sastles-com/power-2S-02/docs/03-mp1584-module.md

# 03 — MP1584 降圧回路 (固定 5V / 最大 3 A)

<subproject>
- name: mp1584-module
- parent: power-2s-02
- status: **確定 (2026-08-10)** — 入手性・データシート照合・全定数を決定。**作図に着手できる**
- depends_on: [01-legacy-analysis, 06-power-switch]
</subproject>

## Scope

2S (6.0〜8.4 V) から **固定 5V / 最大 3 A** を作る降圧回路のオンボード設計。
既製品 MP1584EN ミニ降圧モジュール (トリマ調整式) の置き換え。

## 0. 入手性 (2026-08-10 確認)

<confirmed>
| 項目 | 値 |
| --- | --- |
| **選定品** | **MP1584EN-LF-Z** / Monolithic Power Systems (MPS) |
| **LCSC** | **C15051** |
| パッケージ | **SOIC-8-EP (= SOIC8E、露出パッド付き)** |
| 在庫 | 4,681 pcs |
| JLCPCB 実装 | **可 (SMT Assembly)**。ライブラリ区分 **Extended** |
| θJA | **50 °C/W** (JESD51-7、**4 層基板**での実測値 → 本基板は 4 層なのでこの値が使える) |
</confirmed>

### ⚠️ MP1584 系で在庫があるのは C15051 だけ

JLCPCB 部品ライブラリで `MP1584` を検索すると 20 品目ヒットするが、
**C15051 (MP1584EN-LF-Z) 以外はすべて在庫 0**。以下は選んではいけない:

| 型番 | LCSC | 在庫 | 備考 |
| --- | --- | --- | --- |
| **MP1584EN-LF-Z** | **C15051** | **4,681** | **✅ これを使う** |
| MP1584EN | C454188 | 0 | 無鉛/T&R サフィックスなし品 |
| MP1584EN-LF-P | C7304223 | 0 | チューブ品 |
| MP1584EN-Z | C55109561 | 0 | — |
| MP1584WN | C2916141 | 0 | 車載グレード |
| その他 (JLCPCB Assembly ブランド表記の 13 品目) | — | 0 | — |

サフィックスの意味 (データシート ORDERING INFORMATION):
**`-Z` = Tape & Reel / `-LF` = RoHS 対応** → `MP1584EN-LF-Z` が正規の量産型番。

## 1. 確定事項

<confirmed>
- **IC: MP1584EN-LF-Z** (LCSC C15051、SOIC-8-EP)。**非同期整流** (外付けキャッチダイオード方式)
- **出力: 固定 5V** — トリマ廃止、**R1 = 105 kΩ / R2 = 20 kΩ (1%) で 5.000 V** (§3.1)
- **設計最大電流: 3 A**。引き上げ (5〜6 A 級 IC への変更) は行わない
- **スイッチング周波数: 約 485 kHz** (RFREQ = 200 kΩ)。
  **データシート標準回路の 100 kΩ (≈911 kHz) は採らない** — 高デューティで最小オフ時間を割る (§3.2)
- **外付けブートストラップダイオードが必須** (§3.4)。データシート標準回路には無いが、
  `VOUT/VIN > 65%` の条件に本設計は該当する
- **EN 制御**: ディスクリートラッチが EN を **オープンドレインで引き下げる**だけの構成 (§3.7)。
  **EN を 2S レールに直結してはならない (絶対最大 6 V)**。直列 FET は置かない
- **設計の根拠: データシート標準アプリケーション回路 + 自前計算**
</confirmed>

### データシート情報源

- **一次資料: MPS MP1584 データシート Rev 1.0 (18 ページ、2011-08-08)**
  - 入手 URL: `https://robu-prod-media.s3.ap-south-1.amazonaws.com/uploads/2017/05/Mini-MP1584-DC-DC-3A-Adjustable-Buck-module-Datasheet-ROBU.IN_.pdf`
  - MPS 公式サイト / Mouser / LCSC の直リンクはいずれも bot ブロックで取得できなかった
  - ⚠️ **Rev 1.0 は 2011 年版**。最新は Rev 1.9 相当で、電気的特性が微修正されている可能性がある。
    量産前に MPS 公式で最新版を照合すること (§5)

### 既製モジュールの実測情報 (参考、写真から確認済み)

- パワーインダクタ刻印 **4R7 = 4.7 µH** → **本設計の計算結果と一致** (§3.3)
- 整流ダイオード刻印 **SS34** (3 A ショットキー) → 踏襲
- 入力 4.5〜28 V / 出力 0.8〜20 V (トリマ調整)

### legacy 基板での使われ方 ([`docs/01`](01-legacy-analysis.md))

- IN+ ← VIN ネット (P+ から FB1 フェライトビーズ経由、C1 100 µF タンタル + C3 22 µF + C2 0.1 µF)
- OUT+ → VOUT ネット (C7 100 µF タンタル + C5/C6 22 µF + C4 0.1 µF)
- ⚠️ **タンタルは本設計では使わない** — 補償回路が ESR ゼロの影響を受け C6 が必要になる (§3.5)

## 2. ピン配置 (SOIC-8-EP)

| Pin | 名称 | 機能 | 本設計での扱い |
| --- | --- | --- | --- |
| 1 | SW | スイッチノード。キャッチダイオードを**ピン直近**に | L1 / D1 / D2 (§3.3, §3.4) |
| 2 | EN | イネーブル。**H または floating で動作** | **ラッチのオープンドレインで引き下げ** (§3.7) |
| 3 | COMP | エラーアンプ出力。補償ネットワーク接続 | R3 100 kΩ + C3 220 pF (§3.5) |
| 4 | FB | フィードバック入力。**内部基準 0.8 V** | R1/R2 分圧 (§3.1) |
| 5 | GND (露出パッド) | グランド + 放熱。**出力コンデンサに最短で接続** | サーマルビア (§4) |
| 6 | FREQ | 発振周波数設定。抵抗を GND へ | **RFREQ 200 kΩ 1%** (§3.2) |
| 7 | VIN | 入力電源。デカップリングを**ピン直近**に | C1 (§3.6) |
| 8 | BST | ブートストラップ。BST–SW 間にバイパス | C4 100 nF + **D2** (§3.4) |

### 絶対最大定格 / 推奨動作条件 (重要な制約)

| 項目 | 値 | 本設計での意味 |
| --- | --- | --- |
| VIN 絶対最大 | **30 V** | 2S 8.4 V に対し十分 |
| VIN 推奨 | 4.5〜28 V | ○ |
| **その他全ピン (EN/COMP/FB/FREQ) 絶対最大** | **−0.3 〜 +6 V** | **⚠️ EN を 2S レール (6.0〜8.4 V) に直結できない** (§3.7) |
| BST − SW | −0.3 〜 +6 V | 外付け BST ダイオードを使っても 5 V 弱で収まる (§3.4) |
| 連続許容損失 (Ta = 25 °C) | 2.5 W | 実損失 ~1.3 W なので範囲内 (§3.8) |
| 動作接合部温度 Tj | −20 〜 +125 °C | §3.8 で余裕を計算 |
| 熱シャットダウン | 150 °C (ヒステリシス 15 °C) | — |
| VIN UVLO | 立上り 3.0 V / 立下り 2.6 V | BMS が先に切るので到達しない |
| 電流制限 | **min 4.0 / typ 4.7 A** | ピークインダクタ電流 3.44 A で 14% の余裕 (§3.3) |

## 3. 定数設計

### 3.1 出力電圧設定 — **R1 = 105 kΩ / R2 = 20 kΩ で 5.000 V**

- **FB 基準電圧 = 0.8 V** (min 0.776 / max 0.824 → **±3%**)
- `VOUT = VFB × (R1 + R2) / R2`。R1 = VOUT→FB 間 (上側)、R2 = FB→GND 間 (下側)

| 候補 | R1 | R2 | VOUT | 無負荷時の分圧電流 | 判定 |
| --- | --- | --- | --- | --- | --- |
| データシート標準 (Figure 4) | 210 kΩ | 40.2 kΩ | 4.979 V | **20.0 µA** | △ 下の制約にギリギリ |
| **採用** | **105 kΩ** | **20 kΩ** | **5.000 V** | **40 µA** | **○** |

**なぜ標準値を採らないか**: データシートに
`IO + VO/(R1+R2) > 20 µA` (高圧側ブートストラップ回路が出力に流す ~20 µA を吸収するため)
という制約がある。標準値 210 k/40.2 k では無負荷時ちょうど 20.0 µA で余裕がない。
**105 k/20 k なら 40 µA** で確実に満たし、しかも比が正確に 6.25 = 5.000 V/0.8 V になる。

- R2 は「40 kΩ 以下」というデータシート指定も満たす (20 kΩ)
- 精度は **1%** 品。総合誤差は FB の ±3% が支配的で、**最悪 4.77〜5.24 V**。
  WS2812 の電源範囲内なので問題ない。さらに詰めるなら 0.5% 品にする
- 分圧は VOUT に対して入るので、**電源 OFF 時 (VOUT = 0) の電池消費はゼロ**

### 3.2 スイッチング周波数 — **RFREQ = 200 kΩ → 約 485 kHz** (標準回路と変える)

`RFREQ(kΩ) = 180000 / [fs(kHz)]^1.1` → **200 kΩ で fs ≈ 485 kHz**

#### ⚠️ 本設計は高デューティ動作である (最重要の設計制約)

非同期降圧のデューティは `D = (VOUT + Vf) / (VIN + Vf − I×RDS(ON))`。
Vf = 0.5 V (SS34@3A)、RDS(ON) = 150 mΩ、L1 の DCR 30 mΩ 分を出力側に足して計算すると:

| VIN (2S) | 必要デューティ D (3 A 時) | Dmax @485 kHz = 0.952 | Dmax @911 kHz = 0.909 |
| --- | --- | --- | --- |
| 8.4 V (満充電) | 0.66 | ○ | ○ |
| 7.4 V (公称) | 0.75 | ○ | ○ |
| 6.6 V (3.3 V/cell) | 0.84 | ○ | ○ |
| **6.0 V (放電末期)** | **0.92** | **○ (余裕 3 pt)** | **✗ regulation 不能** |

- **最小オフ時間 100 ns** が上限デューティを決める: `Dmax = 1 − 100 ns × fs`
- **データシート標準回路 (Figure 4) の RFREQ = 100 kΩ (≈911 kHz) では、VIN 6.1 V 以下で 3 A を維持できない**
- **485 kHz なら 2S の全範囲 (6.0 V まで) で 3 A を出せる**。スイッチング損失も減り発熱に有利 (§3.8)
- 副作用: 同じリップルを得るのに L が大きくなる → §3.3 で 4.7 µH に決定 (結果的に既製モジュールと同値)

### 3.3 インダクタ — **L1 = 4.7 µH (LCSC C36417)**

`L1 = VOUT/(fs × ΔIL) × (1 − VOUT/VIN)` — リップル最大は VIN 最大 (8.4 V) 側

- ΔIL 目標 1.0 A (電流制限 min 4.0 A に対しピークで余裕を残す) → **L = 4.17 µH → E 系列で 4.7 µH**
- L = 4.7 µH での実際のリップル (VIN = 8.4 V):
  `ΔIL = 5/(485k × 4.7µ) × (1 − 5/8.4) = 0.89 A` (負荷 3 A の 30%、データシートの推奨範囲内)
- ピークインダクタ電流 `ILP = 3.0 + 0.89/2 = 3.44 A`
  → **電流制限の最小値 4.0 A に対し 14% の余裕** ✓
- VIN = 6.0 V ではリップルが 0.37 A に下がる (ILP 3.18 A) ので、8.4 V が最悪条件
- 要求: **Isat ≥ 4.2 A / Idc ≥ 3.6 A (ピーク 3.44 A・平均 3.0 A に対し 1.2 倍)**、DCR ≤ 30 mΩ
  (DCR 損失 = 9 × 0.03 = 0.27 W。これ以上大きいと効率と発熱に効く)
- **選定確定 (2026-08-11): `SWPA8040S4R7NT` = LCSC `C36417`**
   — 4.7 µH / **Idc 4.1 A / Isat 6.5 A / DCR 25 mΩ / 8.0 × 8.0 mm**
  - 余裕: Isat は ピーク 3.44 A に対し **1.9 倍** ✓ / Idc は平均 3.0 A に対し **1.37 倍**
    (Idc 定格は温度上昇 40 °C 基準なので、3.0 A では上昇 21 °C 相当)
  - DCR 25 mΩ は要求「≤ 30 mΩ」を満たす ✓ (損失 `9 × 0.025 = 0.23 W`)
  - ⚠️ **8.0 × 8.0 mm は本基板で最大の部品**。40×40 のレイアウト制約になる ([`docs/04`](04-layout-thermal.md))。
    小型の `SWPA6045S4R7NT` (C316350) もあるが**ライブラリに電流・DCR が入っておらず検証できない**ため採らなかった
  - データシート Table 1 の推奨品 (TDK RLF7030T-4R7 = 4.7 µH / 31 mΩ / 3.4 A) は電流定格が足りない

### 3.4 外付けブートストラップダイオード — **必須。標準回路には無いので忘れやすい**

<confirmed>
**D2: VOUT (5 V) → BST に `1N4148W` (LCSC C81598) を追加する。**
</confirmed>

データシート "External Bootstrap Diode" の適用条件に本設計が**二重に該当する**:

1. **「`VOUT/VIN > 65%` の高デューティ動作」** — 本設計は 5/7.4 = **68%** (公称)、5/6.0 = 83% (末期)。
   満充電の 5/8.4 = 60% のときだけ 65% を下回る = **電池寿命のほぼ全域で該当**
2. **「軽負荷時は `VIN − VOUT > 3 V` が必要」** — 本設計は最大でも 8.4 − 5 = 3.4 V、公称では **2.4 V で不足**。
   軽負荷ではパルススキップ動作に入り BST コンデンサのリフレッシュ時間が足りなくなる

放置すると **ハイサイド FET のゲート電圧が不足して効率低下・出力不安定**を招く。
5 V レールが系内にある (自分の出力) ので、データシートの言う
「5 V レールが利用できるなら外付けダイオードを追加せよ」に素直に従える。

- 実装: **VOUT → D2 → BST**、BST–SW 間の **C4 = 100 nF** は標準どおり残す
- BST−SW 間電圧は `5 V − Vf ≈ 4.7 V` で**絶対最大 6 V 以内** ✓
- 起動時は VOUT = 0 なので D2 は効かないが、内部 PMOS 経由の充電で立ち上がる (ソフトスタート 1.5 ms)
- **選定確定 (2026-08-11): `1N4148W` = LCSC `C81598` (SOD-123F、Basic Part)**
  - データシートが名指しする型番で、Basic なので段取り費もかからない
  - Vf = 1 V @ 50 mA なので BST−SW ≈ **4.0 V**。ショットキー (BAT54, Vf 0.3 V) なら 4.7 V だが、
    **BST の UVLO 立上り閾値は 2.2 V** なので 4.0 V でも十分な余裕がある ✓
  - BAT54 は LCSC で SOT-23 の Extended しか無く、サイズもコストも不利だったため採らなかった

### 3.5 補償ネットワーク — **R3 = 100 kΩ / C3 = 220 pF / C6 なし**

データシート "Compensation Components" の手順に従う (GEA = 60 µA/V、GCS = 9 A/V):

1. `R3 = 2π × C2 × fC / (GEA × GCS) × VOUT/VFB`、クロスオーバ `fC = fs/10 = 48.5 kHz`
   - C2 実効 22 µF なら R3 = **78 kΩ**、実効 35 µF なら R3 = **124 kΩ**
   - → **R3 = 100 kΩ** はこの範囲の中央で、かつ**データシート Table 3 の 5 V 行の値と一致**する
2. `C3 > 4/(2π × R3 × fC)` = **131 pF** → **C3 = 220 pF** を採用
   - 零点 `fZ1 = 1/(2π × C3 × R3) = 7.2 kHz` = fC/6.7 → 「fC の 1/4 以下」条件を満たす ✓
   - Table 3 の 5 V 行は 150 pF。**220 pF は位相余裕を厚めに取った選択**。
     過渡応答を速くしたい場合は 150 pF に下げてよい
3. `C6` は出力コンデンサの ESR 零点が `fs/2` 未満のときだけ必要
   - **セラミックのみ (ESR ~5 mΩ)** → ESR 零点 ≈ 1.4 MHz ≫ fs/2 = 242 kHz → **C6 不要** ✓
   - ⚠️ **legacy のように 100 µF タンタル (ESR ~100 mΩ) を足すと ESR 零点が 16 kHz に落ちて C6 が必要になる**
     (`C6 = C2 × RESR / R3` ≈ 130 pF)。**タンタルは使わず全セラミックにする**方が設計が単純で確実

- 補償部品は **IC 直近**に置く。SW ノードの真下・近傍や大電流ループ内には置かない (§4)

### 3.6 入出力コンデンサ — **全セラミック**

| | 構成 | 根拠 |
| --- | --- | --- |
| **C1 (入力)** | **22 µF/25 V ×2 + 0.1 µF** | 入力リップル電流は `ILOAD × √(D(1−D)) = 3 × 0.43 = 1.3 A RMS`。セラミック複数個で分担する。入力電圧リップルは 26 mV |
| **C2 (出力)** | **22 µF/25 V ×2 + 0.1 µF** | 出力リップル `ΔVOUT = VOUT/(8 fs² L C2) × (1−VOUT/VIN)` = 10 mV (公称値)、DC バイアス減衰後の実効 ~22 µF でも 21 mV |

- **耐圧 25 V を選ぶ** — 5 V 出力・8.4 V 入力に対して過剰に見えるが、
  **0805/1206 の 22 µF X5R は DC バイアスで実効容量が 30〜50% 落ちる**。
  16 V 品より 25 V 品の方が定格電圧に対する使用率が下がり、実効容量を確保できる
- 0.1 µF は各々 IC ピン直近に配置
- **タンタル/電解は使わない** (§3.5 の理由 + 信頼性)

### 3.7 EN ピンとラッチ interface — **ここが [`docs/06`](06-power-switch.md) の設計前提**

<confirmed>
**EN は「ラッチがオープンドレインで GND へ引き下げるだけ」の構成にする。プルアップ抵抗も分圧も付けない。**
</confirmed>

データシートから判明した EN の性質:

| 項目 | 値 | 設計への影響 |
| --- | --- | --- |
| 立上り閾値 | 1.5 V typ (**min 1.35 / max 1.65**) | — |
| 立下り閾値 | **1.2 V** (precision) | ヒステリシス 300 mV |
| **floating 時** | **内部 1 µA プルアップで約 3.0 V まで上がり = イネーブル** | **⚠️ 何もしないと電源 ON になる** |
| 引き下げに必要な能力 | **1 µA** | 小信号 MOS/NPN で十分 |
| **絶対最大** | **6 V** | **⚠️ 2S レール (6.0〜8.4 V) に直結不可** |
| シャットダウン時消費 | **12 µA typ / 20 µA max** (VEN = 0) | §3.9 のオフ電流を支配する |

#### [`docs/06`](06-power-switch.md) への申し送り (4 件)

1. **EN を 2S レールから分圧してはならない…わけではないが、その必要がない。**
   floating で内部プルアップが ~3.0 V まで持ち上げるので、**ラッチは「引き下げるだけ」でよい**。
   分圧を付けると 6 V 絶対最大の管理が必要になり、常時電流も流れる。**オープンドレイン一択**
2. **電池を挿した直後のデフォルトは「電源 ON」になる** (EN が floating = イネーブル)。
   これを避けるには **ラッチの電源投入時状態を「EN を引き下げる」側に確定させる回路** (RC による
   パワーオンリセット等) が必要。2 石ソフトラッチの素朴な構成では初期状態が不定になりうる
3. **OFF 時は EN を GND まで確実に引き切る。** データシートに
   「EN が 0 V より高く立上り閾値より低い場合、シャットダウンではあるが消費電流がやや増える」
   と明記されている
4. **EN は開放時 1 µA という高インピーダンスノード** → SW ノードから離して配線し、
   **ノイズ対策に EN–GND 間へ 220 pF 程度**を入れる (1 µA で 220 pF を 1.5 V まで充電するのに
   約 0.33 ms。ソフトスタート 1.5 ms に対して無視できる)

### 3.8 発熱と効率 (VIN = 7.4 V, VOUT = 5 V, 3 A)

| 損失要因 | 計算 | 損失 |
| --- | --- | --- |
| ハイサイド FET 導通 | `I² × RDS(ON) × D = 9 × 0.15 × 0.75` | **1.01 W** |
| スイッチング + ドライバ | 概算 | 0.15 W |
| **→ IC 単体** | | **約 1.16 W** |
| D1 キャッチダイオード | `Vf × I × (1−D) = 0.5 × 3 × 0.25` | 0.38 W |
| L1 の DCR | `I² × DCR = 9 × 0.03` | 0.27 W |
| **合計** | | **約 1.8 W** |

- **効率 ≈ 15 W / 16.8 W = 89%** → **CLAUDE.md §9 の「降圧効率 ~90%」という前提を裏取りできた**
- IC の温度上昇: **θJA 50 °C/W × 1.16 W = ΔT 58 °C**。
  ⚠️ IC 損失の最悪条件は**高デューティ側** (VIN = 6.6 V, D = 0.84) で **1.28 W → ΔT 64 °C**
- 周囲温度 40 °C を仮定すると **Tj ≈ 104 °C** — 動作上限 125 °C 以内だが**余裕は大きくない**。
  θJA 50 °C/W は「4 層基板 + 露出パッドを GND プレーンに熱結合」が前提の数値なので、
  **サーマルビアの設計が効率と信頼性を直接左右する** → §4 / [`docs/04`](04-layout-thermal.md)
- 連続許容損失 2.5 W (Ta = 25 °C) の範囲内 ✓

### 3.9 オフ時消費電流 — **≤10 µA は達成不可能** (docs/06 Q1 への回答)

| 要因 | 電流 |
| --- | --- |
| **MP1584 シャットダウン電流 (VEN = 0)** | **12 µA typ / 20 µA max** |
| IP2326 スタンバイ (充電入力なし) | 0.7 µA typ / 1 µA max ([`docs/02`](02-ip2326-module.md) §3.7) |
| ラッチ回路の静止電流 | 未定 ([`docs/06`](06-power-switch.md)) |
| FB 分圧 / EN 分圧 | **0** (VOUT = 0、EN 分圧なし) |
| **合計 (ラッチ除く)** | **約 13 µA typ / 21 µA max** |

- **[`docs/06`](06-power-switch.md) Q1 の目標「≤10 µA」は MP1584 単体で超えるので達成できない。**
  **目標を ≤50 µA に改める** ことを提案 (ラッチ側に ~20 µA の予算が残る)
- 実用上の影響: **20 µA で 2000 mAh を消費するのに 11 年** — 完全に無視できる。
  ディスクリートラッチ方式を選んだ本来の目的 (直列 FET の導通損失回避 + オフ時に降圧 IC を止める)
  は達成できている

## 3.10 回路図の実装状況 — **DCDC ブロック完成 (2026-08-11)**

> **Designator は 2026-08-11 にリナンバー済み** (旧 U20/L20/C20-C27/R20-R23/D20/D21)。
> 全体の対応表は [`HANDOFF.md`](../HANDOFF.md) 「Designator リナンバー」を参照。

<confirmed>
**枠 X 690..1400 / Y 340..700 (710×360)。16 部品 + GND 記号 12 + NET_PORT 3 + 配線 15 本を実装し、
幾何検証 (短絡なし / 未接続なし) をクリアした。**
</confirmed>

| Designator | 部品 | LCSC | 位置 |
| --- | --- | --- | --- |
| **U2** | MP1584EN-LF-Z | C15051 | (1000,520)。**幅 100 / ピッチ 10 / 左 SW,EN,COMP,FB / 右 GND,FREQ,VIN,BST / EP は pin 9 (1000,485)** |
| L2 | 4.7 µH | C36417 | (850,535) |
| D2 (キャッチ) / D3 (**外付け BST**) | SS34 / 1N4148W | C8678 / C81598 | (900,480) / (1130,580) |
| C9 / C10 (入力 22 µF) | — | C12891 | (1120,510) / (1180,510) |
| C11 / C12 (出力 22 µF) | — | C12891 | (800,520) / (760,520) |
| C13 (入力 0.1 µF) / C14 (出力 0.1 µF) / C15 (BST 100 nF) | — | C1591 | (1240,505) / (720,515) / (1000,580) |
| C16 (補償 220 pF) | — | C27675 | (840,370) |
| R7 (105 k) / R8 (20 k) | FB 分圧 | C16840 / C4184 | (900,450) / (900,410) |
| R9 (100 k) / R10 (200 k) | 補償 / RFREQ | C25803 / C25811 | (900,370) / (1090,470) |

**ネットごとの接続 (検証結果)**:

| ネット | ピン |
| --- | --- |
| `DC_SW` | U2.SW / L2.2 / D2.K / C15.1 |
| `DC_BST` | U2.BST / C15.2 / **D3.K** ← 外付け BST ダイオードが入っている ✓ |
| `V5V` | L2.1 / C11.1 / C12.1 / C14.1 / R7.1 / **D3.A** / NET_PORT |
| `SW_VIN` | U2.VIN / C9.1 / C10.1 / C13.1 / NET_PORT |
| `DC_FB` | U2.FB / R7.2 / R8.2 |
| `DC_COMP` → `DC_COMPR` | U2.COMP / R9.2 → R9.1 / C16.2 (直列 RC) |
| `DC_FREQ` | U2.FREQ / R10.1 |
| `PWR_EN` | U2.EN / NET_PORT (PMIC のラッチから) |
| `GND` | U2.GND / U2.EP + 各コンデンサ・抵抗の GND 側 (12 ピン、netflag 直置き) |

⚠️ **`PACK_P` → `SW_VIN` の接続 (フェライトビーズ or 0 Ω) は未実装** —
legacy の FB1 を続投するかは未確定 ([`docs/04`](04-layout-thermal.md) §7 Q2)。
現状は `SW_VIN` を NET_PORT で外に出しているだけ。

### 2026-08-12 の再監査結果

**16 部品・37 ピンを 1 ピンずつ照合し、上の表と完全に一致することを確認した**
(`GND` 12 / `V5V` 6 / SW 4 / `SW_VIN` 4 / FB 3 / BST 3 / COMP 2 / FREQ 2 / 補償 RC 2 / `PWR_EN` 1)。
**短絡・未接続なし。** 監査は `.claude/skills/eda-connect/scripts/dcdc-audit.js`。

DCDC 段の残件は 2 件だけ:

| # | 残件 | 状態 |
| --- | --- | --- |
| ① | **`PACK_P` → `SW_VIN`** (ビーズ or 0 Ω) | 未実装 ([`docs/04`](04-layout-thermal.md) §7 Q2) |
| ② | **EN–GND の 220 pF** (§3.7 申し送り 4) | **未実装。方式変更で不要になった可能性** — §3.7 の提案は「EN が 1 µA プルアップの高インピーダンスノード」という前提だったが、[`docs/06`](06-power-switch.md) §4.5 で **D-FF の Q (3.3 V CMOS プッシュプル) 直結**に変わり、ノードは低インピーダンスになった。入れるなら D-FF の駆動能力 (数 mA) で 220 pF は問題なく、SW ノード近傍を通す場合の保険になる → ユーザー判断 |

## 4. レイアウト要件 (データシート "High Frequency Operation" より)

- **C1 (入力デカップリング) / D1 (キャッチダイオード) / IC の VIN・SW・GND を可能な限り近接**させ、
  配線は**短く太く**。SW ノードの電圧スパイクと EMI を抑える
- **D1 は SW ピン直近**に置く (データシートがピン説明でも明記)
- **FB 配線はインダクタと大電流配線から離す。** 可能なら**インダクタの裏面側に GND プレーンを挟んで**通す
- **補償部品 (R3/C3) は IC 直近。SW ノードの近傍/直下や大電流ループ内に置かない**
- **露出パッド直下にサーマルビアのグリッド**:
  - **バレル径 15 mil (0.38 mm)** — メッキで穴がほぼ埋まる小径にする (大きいとリフローで半田が吸われる)
  - **ピッチ 40 mil (1.0 mm)**
  - → [`docs/04`](04-layout-thermal.md) の内層/Bottom ベタ GND へ熱を逃がす
- SW ノードは面積最小 + 内層 GND で直下シールド

## 5. 負荷側の制約 (重要)

**3 A は LED 負荷に対して厳しい上限**であり、ファーム側の輝度上限運用が前提。
定量的な内訳は CLAUDE.md §9 (Known Constraints) を参照。要点は
**設計上限 3 A から静止電流 0.6〜0.8 A を引いた約 2.2 A が発光に使える分**で、
**LED 1 個あたり平均 2.75 mA** (全白の約 5%) が上限ということ。
この制約は親プロジェクトのファーム設計へ申し送る必要がある。

- §3.8 で **効率 89%** が裏取りできたので、CLAUDE.md §9 の
  「14.8 Wh に対し 15 W で実際 50 分程度」という見積りはそのまま有効

## 6. Open questions

**降圧段の定数は確定した。残るのは部品選定と検証項目のみ。**

| 旧 Q | 内容 | 結論 |
| --- | --- | --- |
| Q1 | データシート照合・固定 5V 分圧・EN 仕様 | ✅ 完了 (§2, §3)。EN の性質は §3.7 に整理して [`docs/06`](06-power-switch.md) へ申し送り |
| Q2 | 出力コンデンサの実効容量確保 | ✅ **22 µF/25 V ×2 の全セラミック構成**。タンタルは補償が複雑になるので使わない (§3.5, §3.6) |
| Q3 | 同期整流型の後継 IC を将来検討するか | 今回は **MP1584 で確定** (再議論しない)。※ 調査中に **SCT2430** (Silicon Content、3.5 A 同期整流、低ドロップアウトモード、ESOP-8) を見つけた。ピン配置は非互換だが、将来 2S 末期の余裕を増やしたい場合の候補として記録 |

残タスク:

- [x] ~~L1 の LCSC 品番選定~~ → **C36417 (SWPA8040S4R7NT)** (§3.3)。⚠️ **8.0×8.0 mm がレイアウト制約**
- [x] ~~D2 (外付け BST ダイオード)~~ → **C81598 (1N4148W, SOD-123F, Basic)** (§3.4)
- [x] ~~セラコン 22 µF/25 V~~ → **C12891 (1206, Basic, 25 V 確認済み)**。
  **0805 の 22 µF は 16 V 品しか存在しない**ので 1206 で確定。入力/出力で計 4 個 + 充電段 2 個 = **6 個**載る
  ([`docs/05`](05-jlcpcb-fab.md) §2.1)
- [ ] **データシート最新版 (Rev 1.9 相当) との照合** — 本設計は Rev 1.0 (2011) に基づく。
  電気的特性 (特に EN 閾値・シャットダウン電流・最小オフ時間) が変わっていないか量産前に確認
- [ ] **試作機での検証**: 負荷ステップ応答 (補償の妥当性)、VIN 6.0〜6.6 V での 3 A 維持、IC 温度実測
