sastles-com/power-2S-02/docs/08-north-status-window.md

# 08 — 北極ステータス窓 (North Pole Status Window)

<subproject>
- name: north-status-window
- parent: power-2s-02 (さらに親: Isolation Sphere V2)
- status: **draft — 作業指示書 (handoff)。着手前に §7 の判断 4 件を解消すること**
- created: 2026-08-11
- depends_on: [06-power-switch, 02-ip2326-module, 親リポジトリ docs/01-shell-cad]
</subproject>

> **この doc は単独で読めるように書いてある。** 会話ログや他セッションの文脈に依存しない。
> 別セッション (別の Opus) がこの doc と [`CLAUDE.md`](../CLAUDE.md) / [`HANDOFF.md`](../HANDOFF.md) だけを読んで着手できることを要件とする。

---

## 1. Goal / 何を作るか

<goal>
球体 (Isolation Sphere V2) の**北極キャップを、電源状態と充電状態が見える「ステータス窓」に作り替える。**

解決する問題は 2 つ:

1. **電源 ON/OFF が分からない** — 磁石をかざして電源を入れても、コントローラ (M5 AtomS 系) の起動に時間がかかるため、
   その間ユーザーは ON なのか OFF なのか判断できない。**ファームウェアに依存しないハードウェア表示**が必要。
2. **既存の指示 LED が見えない** — [`docs/06`](06-power-switch.md) §3.6.2 の電源 ON LED と
   [`docs/02`](02-ip2326-module.md) §3.5 の充電中 LED は**どちらも電源基板上 = 球体コアの中**にあり、
   外殻に埋まって視認できない。**北極キャップへ移設する。**

加えて **「再生が始まったら消灯する」** — コントローラがコンテンツ再生を開始したら、
ステータス窓を消して演出の邪魔をしない。これは ESP32 からの veto 線 1 本で実現する (§4.3)。
</goal>

## 2. Scope / この doc が扱う範囲

- 北極キャップ (意匠) の透光化
- 北極 pillar 先端の**キャリア基板** (ホール素子 + ステータス LED 2 個)
- 北極 pillar の**配線通路** (Φ3 mm / 5 本)
- 電源基板側の LED 駆動回路と **ESP32 veto 回路**
- 上記に伴う親リポジトリ / 本リポジトリの doc 改訂リスト

### Out of scope / 扱わない範囲

- 電源 ON/OFF 回路そのもの (ホール素子 → フリップフロップ → MP1584 EN) → [`docs/06`](06-power-switch.md)
- 充電回路 → [`docs/02`](02-ip2326-module.md)
- 球体外殻・カセット・マザーリング → 親リポジトリ `docs/01-shell-cad.md`
- **ブザー (音による通知)** — **保留**。光で先行する (§7 Q3)

---

## 3. Confirmed decisions / 確定事項

<confirmed>
2026-08-11 ユーザー決定。**再議論しない。**

| 項目 | 決定 |
| --- | --- |
| 北極キャップの役割 | 「純粋装飾蓋」→ **透光ステータス窓**に変更 |
| トリガ素子 | **ホール素子** (リードスイッチは不採用)。**間欠動作の µA 級に限る** — 連続動作型は mA 級で予算 50 µA を 100 倍超える |
| 素子の型 | **スイッチ型 (磁石が近い間だけ出力)**。**ラッチ型は不可** — N/S を交互に当てる必要があり磁石を裏返す操作になる |
| 検知極性 | **両極検知 (omnipolar)** — 磁石の向きを気にせず使える |
| トリガ位置 | **北極** (充電マグネット端子は南極)。磁気干渉なし — 距離 100 mm、磁束は距離の 3 乗で減衰し約 1/1000。クランプねじは真鍮=非磁性 |
| 状態表示の駆動元 | **フリップフロップの Q (3.3 V)**。5V レールではない — **かざした瞬間**に点灯し、MP1584 の soft-start (1.5 ms) すら待たない |
| 再生開始で消灯 | **実装する。** 方式は §4.3 の 3 案から選ぶ。**起動中は必ず点灯**していること (boot-safe) |
| ⚠️ コントローラの制約 | **M5 AtomS3R は GPIO を使い切っている** (2026-08-11 判明)。**veto 専用 GPIO は使えない**前提で設計する |
| 充電中 LED | **北極キャリア基板へ移設**。IP2326 pin 6 が充電中点灯 / 満充電消灯 / 異常点滅を自動でやる |
| **音 (ブザー)** | **鳴らさない。確定 (2026-08-11)。光のみ。** 再提案禁止 |
| **動画再生中の表示** | **電源 ON / 充電中の両インジケータを消灯する。** veto は 2 灯まとめて効かせる (§4.3) |
| pillar 先端の実装 | **小型キャリア基板を新設** (ホール SOT-23-3 + LED 2 + 抵抗 2)。`inner_deck` に続く 2 枚目の補助基板 |
| 北極 pillar | **配線通路 Φ3 mm を新設** (現行仕様は「北極は通路不要」) |
| 接着剤 | **使用禁止** (親プロジェクトの絶対規則) |
</confirmed>

---

## 4. Electrical specification / 電気仕様

### 4.1 System context (前提となる電源アーキテクチャ)

```
2S LiPo ──> [XR-2S-30A BMS (基板外)] ──> PACK_P (6.0-8.4V)
                                            │
                        ┌───────────────────┼──────────────────┐
                        │                   │                  │
                   [IP2326 充電]      [HT7333-1 LDO]     [MP1584 降圧]
                   CHG_IN=南極磁気端子   3.3V 常時オン        EN 制御で ON/OFF
                        │                   │                  │
                    pin6=充電LED        ┌───┴───┐            V5V (5V/3A)
                        │               │       │                │
                        │          ホール素子  [D-FF]            └─> AtomS + LED 800
                        │           (北極)   Q=電源状態
                        │                       │
                        └──────────────> 北極ステータス窓 <───────┘
```

**重要**: 3.3 V LDO は**常時オン**。だから電源 OFF 中でもホール素子と D-FF が生きていて、
かざした瞬間に反応できる。この構造が本 doc の前提。詳細は [`docs/06`](06-power-switch.md)。

### 4.2 北極 pillar を通る配線 — 6 本

**⚠️ 2026-08-11 改訂: 共通カソード方式へ変更したため 3 本のネットが入れ替わった。**
**下表が最新。** 旧表 (`LED_VCC` / `STAT_PWR_K` / `STAT_CHG_K`) は破棄した — 経緯は §5.2a の訂正ブロック。

| # | 信号名 (電源基板側) | 北極側 | 方向 | 内容 |
| --- | --- | --- | --- | --- |
| 1 | `V3P3` | `+3V3` (J1.2) | 基板 → 北極 | 常時オン 3.3 V。ホール素子とスイッチのプルアップ用 |
| 2 | `GND` | `GND` (J1.1) | — | 共通グランド |
| 3 | `HALL_OUT` | `OUT` (J2.2) | 北極 → 基板 | ホール + SW のダイオード OR 出力 → Schmitt → D-FF の CLK |
| 4 | **`PWR_EN`** | `PWR_EN` (J2.4) | **基板 → 北極** | **D-FF の `Q` が `D1` のアノードを直接駆動** (MOSFET 不要) |
| 5 | **`CHG_LED`** | `CHG_LED` (J2.3) | **基板 → 北極** | **IP2326 pin 6 が `D2` のアノードを直接駆動** (ソース出力) |
| 6 | **`LED_K`** | `LED_K` (J2.1) | **北極 → 基板** | **2 灯の共通カソードの帰り** → 電源基板の `Q1` (2N7002) が GND へ落とす。**veto はここ 1 点で 2 灯を消す** |

- **線材: AWG30 級の細線 × 6**。AWG30 は被覆込み Φ0.5 mm 級なので Φ3 mm (断面 7 mm²) 通路に余裕で収まる
- ✅ **`V3P3` は veto の影響を受けない** — veto は共通カソード `LED_K` を切るだけなので、
  **ホール素子が veto 中に止まる経路が構造的に存在しない**。
  (旧方式では `LED_VCC` と `V3P3` の共用が禁止事項だったが、その前提自体が消えた)
- **`HALL_OUT` は必ずツイストする** — 球内に WS2812 データ 5 本が走っており、
  40〜50 mm の引き回しはノイズを拾う。ホール出力はドライブされた低インピーダンスなので
  リードスイッチ (高インピーダンスのプルアップノード) よりは有利だが、対策は入れる
- 基板側に **RC ローパス** (例 1 kΩ + 1 nF) を入れる

### 4.3 インジケータの駆動 + 再生開始で 2 灯とも消灯する仕組み (veto)

> ## ⚠️ 本節 (§4.3 / §4.4 / §4.4a / §4.4b) は検討経緯であり、**確定仕様ではない**
>
> **`IP2326` pin 6 が「シンク」という誤った前提**で書かれている。データシート Figure 5 で
> **ソース**と判明したため、topology は **共通カソード + N-MOS 1 個**に変わった。
>
> **確定仕様は [§5.2a の訂正ブロック](#-2026-08-11-訂正-ip2326-pin-6-はソースだった--led-を共通カソードに変える) と
> [§4.2 の配線表](#42-北極-pillar-を通る配線--6-本) を見ること。**
> 本節は「なぜ P-MOS + PNP 反転段を検討したか」「案 A/案 1/案 2 を何故捨てたか」の記録として残す。

**電流制限抵抗と LED はキャリア基板に、スイッチング素子は電源基板に置く。**

**設計方針: veto は「LED 用アノードレール `LED_VCC` を 1 個の素子で切る」。**
こうすれば **電源 ON LED と充電 LED の 2 灯を 1 箇所で一括消灯**でき、
IP2326 pin 6 の駆動経路に一切手を入れずに済む (pin 6 の駆動形式が §7 Q2 で未確定なため重要)。

```text
                    [電源基板]                          │      [キャリア基板 = 北極]
                                                        │
  V3P3 ──┬─────────────────────────────────────────────┼──> ホール素子 (veto の影響を受けない)
         │                                              │
         ├── Q_RAIL.source (P-MOS)                      │
         │      │  gate ──┬── R 100k ── GND  (default ON = 点灯)
         │      │         └── R 10k ──── VETO 信号 (H で OFF = 消灯)
         │      │                                       │
         │   Q_RAIL.drain ── LED_VCC ══════════════════>┼──┬── R 680Ω ── LED_PWR ──┐
         │                                              │  │  (Vf 2.0V → 2.0mA)    │
         │                                              │  └── R xxxΩ ── LED_CHG ──┼─┐
         │                                              │     (値は §7 Q2 で確定)  │ │
         │   Q_LED.drain <════ STAT_PWR_K ══════════════┼─────────────────────────-┘ │
         │      │ (2N7002)                              │                            │
         │     GND                                      │                            │
         │      gate ── R 10k ── Q (D-FF 出力)          │                            │
         │                                              │                            │
         └── IP2326 pin 6 <════ STAT_CHG_K ═════════════┼────────────────────────────┘
```

**`VETO` 信号の作り方は 3 案あり (下記)。上の骨格はどの案でも共通。**

⚠️ **`Q_RAIL` の gate は R 100k で GND へプルダウンする (default = 点灯)。**
これが boot-safe を保証する — AtomS3R が起動中で veto を driveできない間、
LED レールは生きたままになる。**このプルダウンは省略不可。**

#### ⚠️ 制約: M5 AtomS3R は GPIO を使い切っている (2026-08-11)

当初案の「ESP32 の GPIO 1 本で veto」は**使えない**。代替 3 案を比較する。

| | **案 A: WS2812 データ活動検出** | 案 B: I2C GPIO エキスパンダ | 案 C: RC タイムアウト |
| --- | --- | --- | --- |
| GPIO 消費 | **0** | **0** (既存 I2C バスに相乗り) | **0** |
| firmware 変更 | **不要** | 必要 (1 bit 書くだけ) | **不要** |
| 追加部品 | 6 点 (すべて既存 BOM の型番) | IC 1 個 + 受動数点 + アドレス管理 | **4 点** |
| 消灯タイミング | **WS2812 へフレームが流れ始めた瞬間** | firmware が決めた任意の時点 | 電源 ON から固定時間後 |
| 意味的な正しさ | **「再生を始めたら」とほぼ一致** | 最も正確 (任意の条件で制御可) | 近似 (起動が遅れると先に消える) |
| リスク | データ線への負荷 (要高インピーダンス設計) | I2C バスが GPIO として使われていると成立しない | 起動時間のばらつきを吸収できない |

**推奨は案 A。** GPIO も I2C も firmware も使わず、しかも「再生が始まった」という
意味そのものを直接検出できる。

#### 案 A の回路 (WS2812 データ活動検出) — **フォールバック**

⚠️ **2026-08-11 に方針変更: I2C 端子が基板上で使用可能と判明したため、`VETO` は
§4.4 案 1 (I2C GPIO エキスパンダ) から取る。** 案 A は **I2C が使えないと分かった場合の
代替**として残す (定数まで算出済みなので即着手できる)。

Grove ポートは BNO055 が使用中だが、**I2C はバスなので別アドレスのデバイスを追加できる**
(§4.4)。案 A を使うのは、アドレス衝突・バス速度・実装スペースなどで
エキスパンダが載らないと判明した場合に限る。

##### ① 入力信号の実測前提 (WS2812 のタイミングから計算)

| 項目 | 値 | 根拠 |
| --- | --- | --- |
| ビット周期 | **1.25 µs** (800 kbps) | WS2812 プロトコル |
| **High の最大継続時間** | **T1H ≈ 0.8 µs** (公差込みで 1 µs 未満) | 「持続 High は通常発生しない」ことの根拠 |
| バースト内のデューティ | **28%** (全ビット 0) 〜 **60%** (全ビット 1) | T0H 0.4 / T1H 0.8 ÷ 1.25 |
| **1 フレームの送出時間** | **4.8 ms** | 160 LED × 24 bit × 1.25 µs。**5 本は並列駆動なので 1 本ぶんの時間** |
| フレーム間隔 (30 fps 想定) | 33.3 ms | — |
| **「データあり」の実効デューティ** | **4.0%** (全 0) 〜 **8.6%** (全 1) | 4.8 ms × バースト内デューティ ÷ 33.3 ms |

**設計は最悪条件 (実効デューティ 4.0% = 全ビット 0 = 全消灯フレーム) で成立させる。**

##### ② 回路

```text
  WS2812 DIN ──[R1 100k]──┬──[D1 1N4148W]──┬── V_ACT ──[R3 1M]── Q_ACT.base
   (3.3V, 800kbps)        │                │                     (MMBT3904 / C20526)
                          │             C1 100nF                        │
                       ピーク電流         │                       Q_ACT.collector
                       33 µA のみ       R2 4.7M                        │
                       = 信号品質に       │                        VETO ノード
                       影響しない        GND
```

##### ③ 定数の根拠

| 項目 | 式 / 値 |
| --- | --- |
| 充電の実効時定数 | `τc = R1·C1 / 実効デューティ` = 10 ms / 0.040 = **250 ms** |
| 放電の時定数 | `τd = R2·C1` = 4.7 MΩ × 100 nF = **470 ms** |
| `V_ACT` の平衡電圧 | `(3.3 − Vf) × τd/(τd+τc)` = 2.7 × 470/720 = **1.76 V** |
| しきい値 | **NPN の Vbe = 0.6 V** |
| **余裕** | 1.76 / 0.6 = **2.9 倍** ✓ |
| 消灯までの時間 | 数フレーム (≈100 ms 以内) |
| **再点灯までの時間** | `τd × ln(1.76/0.6)` = **約 0.5 s** |

- **しきい値に NPN の Vbe (0.6 V) を使う。** MOSFET の Vth (2N7002 で 1.0〜2.5 V の 2.5 倍ばらつき)
  に依存させない — [`docs/06`](06-power-switch.md) §3.6.4 で採った設計方針と同じ
- `R3 = 1 MΩ` にして **`V_ACT` からの引き出しを 1.2 µA に抑える**。
  こうすればチャージポンプの供給能力 (1 フレームあたり 40 nC 級) で余裕をもって支えられる。
  ⚠️ `R3` を 10 kΩ にすると 120 µA を引いてポンプが追従できず**平衡電圧が崩壊する**
- **`R1 = 100 kΩ` でデータ線への負荷はピーク 33 µA のみ。** ESP32 GPIO の駆動能力
  (20〜40 mA) に対して 0.1% 以下で、信号品質に影響しない
- **部品はすべて既存 BOM の型番を流用できる**: MMBT3904 = `C20526` /
  1N4148W = MP1584 の BST ダイオード `D3` と同型 / 抵抗・コンデンサは 0603 の既存品番
- **オフ時電流は 0** — `V_ACT` が 0 V なので `R2` にも `R3` にも電流が流れない

##### ④ VETO の極性と出力段 — **IP2326 pin 6 の駆動形式で 2 通りに分かれる (§7 Q2)**

`Q_ACT` (NPN) は **GND へ引く**ことしかできない。一方 boot-safe の要件から
**「detector 非活性 = 点灯」がデフォルト**でなければならない。この組み合わせで topology が決まる。

| pin 6 が | LED の共通側 | veto 素子 | 極性の整合 | 追加部品 |
| --- | --- | --- | --- | --- |
| **ソース (吐き出し)** | **共通カソード → GND** | **N-MOS 1 個** (ゲートを V3P3 へ 100 kΩ でプルアップ = default ON) | **`Q_ACT` がゲートを引き下げて消灯 — 直結で成立** ✓ | N-MOS + R 100 kΩ = **2 点** |
| **シンク (吸い込み)** | **共通アノード `LED_VCC`** | **P-MOS** (§4.3 の骨格) | `Q_ACT` では P-MOS ゲートを V3P3 まで**持ち上げられない** → **PNP 1 石の反転段が必要** | P-MOS + PNP + R×3 = **5 点** |

**pin 6 がソースなら回路が 3 点少なく済む。** §7 Q2 を先に確定させること。

##### ⑤ 実装上の注意

- **タップするのは 5 本のうち 1 本。** 常に駆動される系統を選ぶ
  (一部の系統だけ止める実装があると誤検出する)
- **タップ線は 50 mm 以下に抑える。** 800 kbps に対する容量負荷は
  50 mm ≈ 5 pF 程度で問題にならないが、長くする場合は `R1` をタップ点側に置く
- **電源基板に WS2812 データ線のタップ入力が 1 本増える** — コネクタ 1 ピンを確保する
  ([`docs/01`](01-legacy-analysis.md) §4 のコネクタ構成に反映)
- **この同じタップは将来 `PWR_OFF` にも再利用できる** — WS2812 は High が
  0.8 µs しか続かないので、**数十 ms の持続 High は通常動作では絶対に起きない**一意な合図になる。
  ただし `V_ACT` は持続 High でも飽和するため、**判別には 2 段目のしきい値が必要** (§4.4 案 2)

⚠️ **案 A の意味論に注意**: 検出しているのは「**firmware が WS2812 フレームを送出している**」で、
「コンテンツを再生している」ではない。**firmware が待機中も黒フレームを流し続ける実装だと、
待機状態でも消灯する。** ファームウェアの挙動を確認して判断すること (§7 V3)。

#### 動作表 (案 A の場合)

| 状態 | Q | VETO | 電源 ON LED | 充電 LED |
| --- | --- | --- | --- | --- |
| 電源 OFF・充電なし | L | L | 消灯 | 消灯 |
| **電源 OFF で充電中** | L | L | 消灯 | **点灯** ← 消灯のまま充電できることの可視化 |
| **かざした瞬間 〜 AtomS 起動中** | **H** | **L** | **点灯** ← 解決したい問題 | 充電中なら点灯 |
| **動画再生中** | H | **H** | **消灯** | **消灯** ← 2 灯とも消える (2026-08-11 確定) |
| 再生停止 / 送出が 100 ms 以上途切れた | H | L | 点灯 | 充電中なら点灯 |

**boot-safe が最重要要件**: `Q_RAIL.gate` の pulldown が無いと `VETO` ノードが不定電位になり、
起動中に消灯する事故が起きる。**どの案を選んでも pulldown は省略不可。**

### 4.4 ESP32 インターフェースと GPIO 拡張

<constraint>
**M5 AtomS3R は GPIO を使い切っており、veto 線も電源オフ線も割り当てられない (2026-08-11)。**
必要な信号は 2 本:

| 信号 | 方向 | 用途 | 現在の扱い |
| --- | --- | --- | --- |
| `VETO` | AtomS → 基板 | 再生開始でステータス窓を消灯 (§4.3) | 本 doc で新設 |
| `PWR_OFF` | AtomS → 基板 | ソフト電源断 (D-FF の CLR を引く) | **2026-08-11 にペンディング解除 → 実装する** ([`docs/06`](06-power-switch.md) §1 の「パッド予約のみ」を改訂) |

**GPIO は 1 本も空いていないが、I2C 端子が基板上に実装済みで使用可能** (2026-08-11 ユーザー確認)。
I2C は**バス**なので、Grove の BNO055 と同居しながらデバイスを追加でき、**GPIO を消費しない。**
</constraint>

#### 拡張方法 3 案

| | **案 1: I2C GPIO エキスパンダ** | 案 2: WS2812 データ線に多重化 | 案 3: コントローラを載せ替え |
| --- | --- | --- | --- |
| 追加 GPIO の消費 | **0** (既存 I2C バスに相乗り) | **0** | — |
| 得られるビット数 | **4〜8 本** (将来の拡張余地つき) | 1 本相当 | 多数 |
| 部品 | IC 1 個 + パスコン (I2C プルアップはバス側に既存) | R + D + C + NPN ≈ 4 点 | — |
| firmware | I2C 書き込み (M5Unified で容易) | `digitalWrite(HIGH); delay(100);` のみ | 再検証が必要 |
| 決定性 | **高い** (任意のタイミングを明示的に制御) | 中 (レベル判別に設計余裕が必要) | 高い |
| 前提 | **I2C バスが空いていること** ← §7 Q5 | WS2812 線を電源基板まで引くこと | 親プロジェクトへの影響大 |

#### ⚠️ 案 1 (I2C エキスパンダ) は保留 — パッケージが大きい (2026-08-11)

**40×40 片面実装に載る小型品が見つからないため、いったん保留。**
以下の案 1 の設計は**将来 小型品が見つかった場合のために残す** (落とし穴の分析は再利用価値がある)。
再検討する場合は **`PCA9570` クラス (4 bit・出力専用・SC70-6 等)** から当たること。

**→ 現在の方針は §4.4a (WS2812 データ線から 2 信号とも取る) を参照。**

#### 案 1 の設計 (保留・参考)

**I2C 端子は電源基板上に実装済みで使用可能**、かつ **`PWR_OFF` も実現したい**との判断。

> **Grove を BNO055 が使っていても問題ない。** I2C は**バス**なので、同じ 2 線に別アドレスの
> デバイスを追加できる (BNO055 = 0x28/0x29、エキスパンダ = 0x20 帯 / 0x41)。**GPIO は 1 本も増えない。**

これにより **`VETO` と `PWR_OFF` を 1 個の IC でまとめて供給**でき、
**§4.3 案 A (WS2812 データ活動検出) は不要になる** → 案 A は **I2C が使えなかった場合の
フォールバックとして残す** (回路と定数は算出済みなので、必要になれば即着手できる)。

##### 信号の割り当て

| ビット | 信号 | 極性 | 接続先 |
| --- | --- | --- | --- |
| P0 | `VETO` | 詳細は下記 ② | LED アノードレール `LED_VCC` のスイッチ (§4.3) |
| P1 | `PWR_OFF` | 同 | D-FF の **CLR (アクティブ Low)** → 引くと即 OFF |
| P2, P3 | 予備 | — | 将来の `PWR_STATE` 通知 / RGB ドライバ制御など |

##### ① ⚠️ 落とし穴 1: 電源ドメインの選択

| 電源 | 利点 | 致命的な問題 |
| --- | --- | --- |
| **常時オン 3.3 V (`V3P3`)** | 配線が単純 | **前回セッションの veto 状態が残る。** 再生中に電源を切ると veto=有効のまま保持され、**次回起動時にステータス窓が点かない** — 本 doc が解決しようとしている問題そのものが再発する |
| **電源 ON 中の系 (推奨)** | **毎回リセットされるので状態が残らない** ✓ / **オフ時電流に寄与しない** ✓ | 未通電時のリーク経路に注意 (下記 ②) |

**推奨: AtomS3R の 3V3 出力から給電する。** I2C バスの論理レベルも AtomS3R の 3.3 V と
自動的に一致するので、レベル変換が不要になる (§7 V8 で 3V3 ピンの供給能力を確認)。

##### ② ⚠️ 落とし穴 2: 未通電時のリークと power-up 出力状態

エキスパンダを ON ドメインで動かすと、**電源 OFF 中はエキスパンダが未通電**になる。
このとき信号線を常時オン側のプルアップで保持すると、
**プルアップ電流が未通電 IC の ESD ダイオード経由で VDD へ流れ込む** — 100 kΩ × 2 本で
**66 µA**、オフ時電流の予算 50 µA を単独で超える。

**対策: エキスパンダの出力を直接つながず、小信号 N-MOS 1 石ずつで受ける。**

```text
   [ON ドメイン]                    │        [常時オン ドメイン]
                                    │
  エキスパンダ Px ──┬── R 10k ──────┼── Q_x.gate      (Q_x = 2N7002)
                    │               │      │
                  R 100k            │   Q_x.drain ──> 信号ノード
                  (pulldown)        │      │          (VETO / CLR)
                    │               │     GND         ← R 100k で V3P3 へプルアップ
                   GND              │
```

- **未通電時**: `Px` が高インピーダンス → `R 100k` の pulldown が `Q_x` のゲートを GND に固定
  → `Q_x` OFF → **リーク経路なし** ✓ かつ信号ノードはプルアップで H = 非アサート ✓
- **極性**: エキスパンダが **H を出すとアサート** (`Q_x` が信号を GND へ引く) になる
- **したがってエキスパンダは「power-up 時に出力が H にならない」品種でなければならない。**
  **`PCA9536` は power-up 時に全ピンが入力 (高インピーダンス) になる**ので条件を満たす。
  ⚠️ **`PCF8574` は power-up 時に出力が H** になるため、この topology では
  **起動と同時に電源が切れる**。**PCF8574 を採用してはならない** (§7 V7 で最終確認)
- pulldown があるので **boot-safe も同時に満たす** — firmware が走る前は両信号とも非アサート
  = ステータス窓は点灯、電源は入ったまま ✓

##### ③ `PWR_OFF` の動作シーケンス

1. firmware が `P1` を H にする → `Q_1` が D-FF の `CLR` を GND へ引く
2. D-FF がクリア → `Q` = L → MP1584 の EN が L → 5V 崩壊 → **電源 OFF**
3. 5V が消える → AtomS3R とエキスパンダが未通電 → `Q_1` OFF → `CLR` はプルアップで解放
4. **D-FF は常時オン 3.3 V で生きており `Q` = L を保持** → 再投入ループは起きない ✓

##### ④ 部品と追加線

| 部品 | 数 | 置き場所 |
| --- | --- | --- |
| I2C GPIO エキスパンダ (PCA9536 系) | 1 | 電源基板 |
| パスコン 100 nF | 1 | 電源基板 |
| N-MOS 2N7002 (`C8545`) | 2 | 電源基板 |
| 抵抗 (ゲート直列 10 k ×2 / pulldown 100 k ×2 / プルアップ 100 k ×2) | 6 | 電源基板 |

- **AtomS3R との接続線: SDA / SCL / 3V3 / GND = 4 本** (既存 I2C 端子を流用)
- I2C バスのプルアップ抵抗が基板側にあるか AtomS3R 側にあるかを確認 (§7 V9)

### 4.4b ★採用: PCA9632 (I2C 4ch LED ドライバ) — 2026-08-11

**GPIO エキスパンダではなく「I2C LED ドライバ」を使うのが本件には最適。**
ユーザー提示: [Switch Science PCA9632DP1 I2C 4ch LED ドライバ基板 ¥611 / 在庫 88](https://www.switch-science.com/products/2378)

#### なぜエキスパンダより良いのか — 4 点

| 特性 | 本件での意味 |
| --- | --- |
| **出力がオープンドレイン (シンク 25 mA/ch)** | 必要な操作は「プルアップされたノードを GND へ引く」だけ。**極性が完全に一致し、N-MOS のバッファが不要**になる (エキスパンダ案で必要だった 2 石 + 抵抗 4 本が消える) |
| **LED ドライバなので power-up 時は消灯 = 出力オフ** | **`VETO` も `PWR_OFF` も power-up 時に非アサート** → **boot-safe が無条件で成立**。`PCF8574` の「power-up で出力 H → 起動と同時に電源が切れる」危険が原理的に発生しない |
| **8 bit PWM × 4ch + ハードウェア点滅** | ステータス窓の**明るさをソフトで可変**でき、点滅も IC 側が生成する。「暗所では暗く」「エラー種別を点滅パターンで」といった表現が firmware のタイマ処理なしで実現できる |
| **2.3〜5.5 V 動作 / I2C アドレス 0xC4 (7bit 0x62)** | **BNO055 (0x28 / 0x29) と衝突しない** ✓ |

#### 信号割り当て

| ch | 用途 | 接続 |
| --- | --- | --- |
| ch0 | **`VETO`** | LED アノードレールの N-MOS ゲート (V3P3 へ 1 MΩ プルアップ = default ON = 点灯) を**シンクして消灯** |
| ch1 | **`PWR_OFF`** | D-FF の **CLR** (V3P3 へ 470 kΩ プルアップ) を**シンクして電源 OFF** |
| ch2, ch3 | 予備 | 将来の 3 灯目 / RGB / `PWR_STATE` など |

- **どちらも直結**。追加の能動素子は LED レール用 N-MOS 1 個のみ
- 電源 ON 表示の「かざした瞬間に点灯」は従来どおり **D-FF の `Q` からハードウェアで駆動**する。
  PCA9632 は**それを消す側**にだけ関与する — これで firmware 起動前の点灯が保証される

#### ⚠️ 電源ドメインと未通電時リーク (エキスパンダ案と同じ論点)

- **PCA9632 は「電源 ON 中の系」(AtomS3R の 3V3) から給電する。**
  常時オンにすると**前回の veto 状態がレジスタに残り、次回起動時にステータス窓が点かない**
  (PCA9632 はソフトウェアリセットのみでリセットピンが無いため、電源で落とすのが唯一の確実な手段)
- 未通電時、常時オン側のプルアップ電流が **ESD ダイオード経由で流れ込む**。
  **プルアップを大きくして抑える**:

| ノード | プルアップ | リーク | 備考 |
| --- | --- | --- | --- |
| LED レール N-MOS ゲート | **1 MΩ** | 3.3 µA | ゲートは高インピーダンスなので 1 MΩ で問題ない |
| D-FF の `CLR` | **470 kΩ** | 7.0 µA | LVC の入力リーク ±1 µA max を考慮。1 MΩ では H レベルの余裕が薄い (§7 V10) |
| **合計** | — | **約 10 µA** | オフ時合計 **約 28 µA typ** → **目標 ≤50 µA を満たす** ✓ |

#### 調達

- **試作**: Switch Science のブレークアウト基板 (¥611 / 在庫 88) をそのまま使える
- **量産**: 単体 IC を電源基板に実装。`PCA9632DP1` は **TSSOP-8**、DFN 系の小型品種もある
  → LCSC 在庫とパッケージの確定は §7 V13

### 4.4a フォールバック: WS2812 データ線 + GPIO06 から取る

⚠️ **PCA9632 (§4.4b) が使えないと分かった場合の代替。** 以下は設計・定数まで算出済みなので即着手できる。

**`VETO` と `PWR_OFF` を GPIO を消費せずに作る。**

| 信号 | 取得元 | 検出方法 | 原理 |
| --- | --- | --- | --- |
| `VETO` | **WS2812 データ線 (0 ピン)** | **活動検出** (§4.3 案 A) | フレームが流れている = 再生中 |
| `PWR_OFF` | **GPIO06 (スピーカと共用)** | **「Low が来ないこと」の検出** (下記) | **音声は AC なので 100 ms の DC High を保つことは絶対にない** |

#### M5 AtomS3R の外部ピンは 6 本しかない (2026-08-11 ユーザー確認)

| ピン | 用途 | 空き |
| --- | --- | --- |
| GPIO01〜05 | **WS2812 5 ストリップの制御** | ✗ (親プロジェクトの必須要件) |
| **GPIO06** | **スピーカ** | **共用の可否が論点 (下記)** |
| 内部の他ピン | 製品として線が出ていない (ESP32-S3 には存在する) | 実質不可 — **モジュール上のパッドへ手はんだする改造が必要。極小モジュールでは現実的でない** |

#### ✅ GPIO06 は **`PWR_OFF` に限って共用できる** — スピーカを維持したまま

**信号の性質が違うので、共用の可否は信号ごとに分かれる。**

| 信号 | 性質 | GPIO06 共用 |
| --- | --- | --- |
| `VETO` | **再生中ずっと保持する静的レベル** | **✗ 不可** — 音を鳴らしている間レベルが暴れる。時間多重が成立しない |
| **`PWR_OFF`** | **意図した瞬間だけの一過性の操作** | **✅ 可能** — 下記の理由で音声と原理的に弁別できる |

**弁別できる理由: 音声信号は AC であり、100 ms のあいだ DC High を保つことは絶対にない。**
したがって「持続 High 検出」(下記の `PWR_OFF` 検出回路) は、
**スピーカが鳴っていても誤発火しない。**

- firmware は電源を切りたいとき **GPIO06 を 100 ms 以上 High に保持するだけ**
- **スピーカ機能はそのまま残せる** — 音声出力と電源オフ指示が同じ線で共存する
- ⚠️ **タップ位置はアンプ/ドライバの前 (GPIO 側)** にする。3.3 V ロジックレベルを直接見る
- ⚠️ **スピーカを直結駆動している場合、100 ms の DC High はコイルに直流を流す。**
  「プツッ」という音が出る (電源オフの合図としては実用上むしろ都合が良いが、
  素子保護の観点で直流耐性を確認する) → §7 V12

**これにより WS2812 データ線に触るのは `VETO` の活動検出だけになる。**
活動検出は「データが無い = veto しない = 点灯」という安全側に倒れる回路なので、
**LED データ線に critical な依存を作らずに済む** — 当初 `PWR_OFF` も WS2812 から
取ろうとしていた案より安全。

#### `PWR_OFF` の検出回路 — GPIO06 で「Low が来ないこと」を見る

振幅ではなく **「一定時間 Low が現れないこと」** で弁別する。
音声信号は AC なので必ず Low に戻る → **原理的に誤動作しない。**

```text
  V3P3 ──[R4 1M]──┬── V_OFF ──[R5 220k]──┬── Q_OFF.base (MMBT3904)
                  │                       │
                C2 100nF              [R6 100k]
                  │                       │
                 GND                     GND
                  │
  GPIO06 ─────────┴──[D2 1N4148W]  (アノード = V_OFF 側 / カソード = GPIO06 側)
   (アンプ前の
    ロジック側)  │
             [R7 10k] ← ⚠️ プルダウン (必須・下記)
                │
               GND
```

| 状態 | GPIO06 | `V_OFF` | 判定 |
| --- | --- | --- | --- |
| **音声出力中** | AC で必ず Low に戻る | **D2 が毎周期 放電 → 0.6 V に固定** | 非アサート ✓ |
| 無音 / 待機 / 起動中 | **Low で静止** (プルダウンで確定) | D2 が導通し続け 0.6 V | 非アサート ✓ |
| **firmware が意図的に High 保持** | High 継続 | **D2 が切れて `R4·C2` で充電** | **しきい値到達で `PWR_OFF`** |

- 充電時定数 `R4·C2` = 1 MΩ × 100 nF = **100 ms**
- 分圧 `R5:R6 = 220k:100k` によりトリガは `V_OFF ≈ 1.9 V` (NPN の Vbe 0.6 V に対応)
- 到達時間 = `100 ms × ln((3.3−0.6)/(3.3−1.9))` = **約 66 ms**
  → **firmware は該当ピンを 100 ms 以上 High に保持するだけでよい**
- ⚠️ **`R7 10 kΩ` のデータ線プルダウンは必須。** ESP32 の GPIO は起動中 High-Z になりうる。
  プルダウンが無いと線が浮いて **起動中に `PWR_OFF` が誤発火し、電源が落ちる**。
  WS2812 の DIN を確定させる意味でも定石
- しきい値に **NPN の Vbe (0.6 V)** を使う方針は §4.3 と同じ
- **オフ時電流**: 電源 OFF 中は `V3P3` から `R4` 経由で `C2` が充電され、
  `D2` がデータ線 (プルダウンで Low) へ流す → **3.3 V / 1 MΩ ≈ 3.3 µA が常時流れる**。
  ⚠️ これは無視できないので、**`R4` を `V3P3` ではなく `LED_VCC` か
  「電源 ON 中の系」から取ることを検討する** (§7 V11)

#### 部品まとめ (WS2812 方式・2 信号)

| 用途 | 部品 | 数 |
| --- | --- | --- |
| 共通 | データ線プルダウン `R7` | 1 |
| `VETO` 活動検出 | `R1` `D1` `C1` `R2` `R3` + NPN | 6 |
| `PWR_OFF` 検出 | `R4` `C2` `D2` `R5` `R6` + NPN | 6 |
| 出力段 | §4.3 ④ の topology (pin 6 の駆動形式次第で 2〜5 点) | 2〜5 |

**合計 15〜18 点。** I2C エキスパンダ案 (10 点) より多いが、**GPIO も I2C も消費せず、
小型パッケージの入手性に依存しない**。すべて 0603 / SOT-23 の既存 BOM 型番で構成できる。

#### 案 2 の詳細 (参考・上記 `PWR_OFF` 検出の原型)

WS2812 のプロトコルでは **High が最大 ~0.9 µs (T1H) しか続かない**。
したがって **数十 ms continuous High は通常動作では絶対に発生しない** → 一意な合図として使える。

- firmware は該当ピンを `HIGH` にして 100 ms 保持するだけ
- 基板側は RC ローパス + NPN で「持続 High」を検出 → `PWR_OFF` を生成
- ⚠️ **通常のフレーム送出との判別に設計余裕が必要**: WS2812 のビット列はデューティ
  33〜66% なので、RC の整定値が全ビット 1 のときと持続 High で近づく。
  **しきい値の余裕を計算で裏取りすること**。余裕が取れない場合は案 1 に戻る

### 4.5 充電中 LED

- IP2326 **pin 6** が駆動 (充電中点灯 / 満充電消灯 / 異常点滅を IC が自動判定)
- アノードは **`LED_VCC`** から取る。`LED_VCC` は常時オンの `V3P3` を veto でゲートしたものなので:
  - **電源 OFF 中の充電でも点灯する** ✓ (「消灯のまま充電できる」ことがユーザーに見える)
  - **動画再生中は電源 ON LED と一緒に消灯する** ✓ (2026-08-11 確定)
- 直列抵抗はキャリア基板側に置く。値は pin 6 の駆動形式が確定してから決める (§7 Q2)
- ⚠️ **異常表示は別 LED を足さなくてよい** — IP2326 が**異常時に点滅**させるので、
  この 1 灯が「充電中 / 満充電 / 異常」の 3 状態を表現する

### 4.6 ホール素子

| 候補 | 消費電流 | Bop | パッケージ | 調達 | 備考 |
| --- | --- | --- | --- | --- | --- |
| **ABLIC S-5716A** | **4.0 µA typ** (両極, tcycle 50.50 ms) | 1.8 / 3.0 / 3.4 / 4.5 / 7.0 mT から選択 | SOT-23-3 | **秋月 116980 系 ¥60** | 感度の高い品種が取れれば有利。出力は Nch OD / CMOS 選択可 |
| TI DRV5032FA | 1.6 µA (3V, 20Hz) | ±4.8 mT | TO-92 / SOT-23 / X2SON | LCSC C3716252 $0.18 | TO-92 あり (ただしキャリア基板を作るので不要) |

**どちらを採用するかは §7 Q1 で決める。** 消費電流の差 2.4 µA は
MP1584 のシャットダウン 12 µA に対し無視できるので、**判断軸は感度と調達性**。

---

## 5. Mechanical specification / 機構仕様

### 5.0 ★実機で確定した機構 (2026-08-11)

<confirmed>
**ユーザー確認済み。ここが設計の土台なので、以降の記述はすべてこれに従う。**

| 項目 | 確定内容 |
| --- | --- |
| **北極の五角形穴** | **φ5〜6 mm。これを「LED を覗かせる窓」として使う** |
| **基板の位置** | **球体の内側。pillar 先端に載る** |
| **外形** | **φ14.7 mm** (南極の送信側基板と同一寸法。実測値) |
| ホール素子の検出 | **外殻 5 mm を透かして検出**。Bop 1.8 mT 品を選定済み |
| 外部露出 | **なし** → **ESD 保護素子は不要** |
</confirmed>

⚠️ **`charge-connector-06` は球体の部品ではない。** あれは**充電ドック/ケーブル側の「送信側」基板**で、
磁石で球体の南極に吸着して `+5V` / `GND` を送り込む。**球体側の南極には裏面パッドが無い。**
[`docs/09`](09-system-structure.md) の基板一覧でも「球体外の部品」として扱う。

```text
          磁石 (手でかざす)
             │  距離 = 外殻 5mm + 隙間
   ━━━━━━━━━┿━━━━━━━━━━  ← 外殻 5mm / φ5〜6mm の五角形穴 = LED の窓
             │ ↑ LED の光が出る
        ┌────┴────┐
        │ 北極基板 │ φ14.7mm  ← 内側・pillar 先端
        │ U1 / LED×2 / R×2 │
        └────┬────┘
             │ 6 本
          pillar → コア → 電源基板
```

### 5.1 北極キャップ — ⚠️ 窓と競合する

- 現行: 黒 PETG の**純粋装飾蓋**、pillar へ**スナップ留め** (中央ねじなし)
- **問題**: **五角形穴を LED の窓として使う**ため、**不透明なキャップが穴を覆うと光が出ない**
- 選択肢 (§7 Q4):

| 案 | 内容 |
| --- | --- |
| **a. キャップに開口を設ける** | 五角形穴と位置を合わせた窓を開ける。黒の意匠を保てる |
| **b. キャップを半透明 PETG で造形** | 部品追加ゼロ。穴の位置合わせが不要になる |
| **c. キャップを付けない** | 穴がそのまま露出。最も単純だが意匠と防塵で不利 |

- ⚠️ 外殻を黒にしているのは **LED ラッパ穴の遮光マスク**目的なので、
  北極キャップの透光化はその規則に抵触しない (極には LED が無い)
- **キャップは着脱式のまま維持する** — ホール素子と LED は**キャップではなく pillar 先端の
  キャリア基板に載せる**。こうすればキャップを開けても配線を触らない
- ~~ライトパイプ~~ → **不要**。五角形穴が窓になるので導光する必要がない

### 5.2 pillar 先端キャリア基板

| 項目 | 仕様 |
| --- | --- |
| 搭載部品 | **ホール素子 SOT-23-3 × 1 / LED 0603 × 2 / 抵抗 0603 × 2 = 5 点** |
| **外形** | **φ14.7 mm で確定** (南極の送信側基板と同一。部品面積 27 mm² / 板面積 169.7 mm² = **16%**) |
| 固定 | **接着剤禁止**。pillar 先端の座に載せる。⚠️ **南極の送信側基板は取付穴を持たない**ので、同様に「座 + 配線で保持」か、Φ2 級の取付穴を設けるかは §7 Q7 |
| **配線** | **2 極 + 4 極の 2 コネクタに分ける** (2026-08-11 確定・下表) |
| 実装 | 5 部品。**LCSC にも SOT-23-3 のホール品があるので JLCPCB PCBA も可**。手はんだも容易 |
| 実装面 | **LED は五角形穴に向く面**に置く (0603 は上面発光)。ホール素子も同一面でよい |

✅ **逆貼りタクトスイッチを採用** (2026-08-11 ユーザー決定・当初からの想定どおり)。
五角形穴は深さ 5 mm・φ5〜6 mm で指は届かないので、**ルータのリセット穴と同じ
「クリップで突く」操作**になる。これが狙いであり、**球体を分解せずに電源を入れられる**ため
[`docs/06`](06-power-switch.md) §4.6 の基板上 `SW1` より保守性が高い。

- **部品はユーザー手持ちの `RT3301AF260Q` 系を使用**
- **アクチュエータは五角形穴の片側に寄せ、LED を反対側に置く** (穴を光路と機械アクセスで分け合う)
- 回路は**ダイオード OR** で `HALL_OUT` に合流させ、**線は 6 本に保つ** (下記)

### 5.2a ★北極キャリア基板 確定仕様 (2026-08-11)

<confirmed>
**部品 11 点。指示器は単色 2 灯 (案 A)。**

> ⚠️ **回路図の正本は KiCad プロジェクト (ユーザー作図・2026-08-11 レビュー済み)。**
> EasyEDA 側に一時的に作った `Board2` は**廃棄済み**。以降 EasyEDA で北極基板を作図しない。
> 本 doc の記述と KiCad が食い違った場合は **KiCad を正**とし、doc を追随させる。
>
> **リファレンス指定子は KiCad に合わせた** — LED は `D1` / `D2`、**OR ダイオードは `D3`**、
> `C2` は `U1` の VDD パスコン。以前の版の `LED1` / `LED2` / `D1`(OR) 表記は破棄した。
</confirmed>

#### ⚠️★ 2026-08-11 訂正: IP2326 pin 6 は「ソース」だった — LED を共通カソードに変える

<confirmed>
**データシート Figure 5 (p.16) を画像でレンダリングして確認した結果、`pin 6` は電流を吐き出す**
**ソース出力**だった (`pin6 → R2 100Ω → LED → GND`)。**§7 Q2 の「シンク」という結論は誤り**で、
[`docs/02`](02-ip2326-module.md) §3.5 の「標準回路は LED + 100 Ω を GND へ」を読み違えたもの。

**これで §4.3 ④ の表の 1 行目 (= ソースの行) が採用行になり、§4.3/§4.4b の矛盾も解消する:**

| | 誤っていた前提 (シンク) | **正しい前提 (ソース)** |
| --- | --- | --- |
| LED の共通側 | 共通アノード `LED_VCC` | **共通カソード `LED_K` → GND** |
| veto 素子 | P-MOS **+ PNP 反転段 = 5 点** | **N-MOS 1 個 + プルアップ 100 kΩ = 2 点** |
| PCA9632 との整合 | ゲートを持ち上げられず**不成立** | **ゲートを引き下げるだけ = 直結で成立** ✓ |
| 充電 LED の駆動 | `LED_VCC` → R → LED → pin6 (シンク) | **pin6 → R → LED → 共通カソード** |
| 電源 ON LED の駆動 | `LED_VCC` → R → LED → N-MOS | **`PWR_EN` (D-FF の Q) → R → LED → 共通カソード** |

**副産物として能動素子がさらに減った:**

- **電源 ON LED は MOSFET が要らない** — `74LVC1G74` の出力は ±24 mA 駆動なので、
  **`PWR_EN` から直接 LED を吐かせられる** (必要なのは 1.84 mA)
- **veto 用 N-MOS 1 個で 2 灯まとめて消える** — 共通カソードを GND から切り離すだけ。
  ゲートは `V3P3` へ 100 kΩ でプルアップ (**default = 点灯 = boot-safe**)、PCA9632 ch0 がシンクして消灯
- **電源基板側の追加部品は `2N7002` × 1 + 100 kΩ × 1 = 2 点だけ**

⚠️ **`LED_VCC` は廃止。** 代わりに **`LED_K` (共通カソードの帰り)** になる。**pillar を通る線は 6 本のまま。**
これに伴い **「`V3P3` と `LED_VCC` を共用してはならない」という警告は前提が消えて無効**になる
(veto がレールを切らないので、ホール素子が veto に殺される経路が構造的に存在しない)。

⚠️ **KiCad の北極回路図は LED の向きを反転する必要がある** (現状は共通アノード)。
`R1`/`R2` を LED のアノード側へ移し、カソードを 1 点に束ねて `LED_K` として出す。

**抵抗値も変わる:**

| | 旧 (誤前提) | **新** | 根拠 |
| --- | --- | --- | --- |
| `R2` (充電 LED) | 680 Ω | **100 Ω** | **メーカー指定値**。pin 6 の出力電圧が未規定なので独自計算してはいけない ([`docs/02`](02-ip2326-module.md) §3.5) |
| `R1` (電源 ON LED) | 680 Ω | **680 Ω (変更なし)** | `PWR_EN` = 3.3 V CMOS 駆動。`(3.3 − 2.0) / 680 = 1.9 mA` |

</confirmed>

#### BOM (11 点)

| Ref | 部品 | 値 / 型番 | パッケージ | 役割 |
| --- | --- | --- | --- | --- |
| **U1** | ホール IC | **`S-5716ACDH0-M3T1U`** (CMOS / 両極検知 / アクティブ H / **Bop 1.8 mT** / 4.0 µA)<br>秋月 **116180** / LCSC にも同系列あり | **SOT-23-3** | 磁石検出 |
| **SW1** | **逆貼り (裏面実装) タクト SW** | `RT3301AF260Q` 系。**ユーザー手持ち品を使用**<br>⚠️ **フットプリントは実測から自作が必要** | SMD 逆貼り | **クリップで突く非常用トグル** |
| **D3** | ダイオード | **1N4148WS** | SOD-323 | **OR 用**。ホールの L 出力とスイッチの H 駆動を分離 |
| **R3** | 抵抗 | **1 kΩ** | 0603 | SW1 直列保護 |
| **R4** | 抵抗 | **100 kΩ** | 0603 | `OUT` プルダウン |
| **C1** | セラコン | **100 nF** | 0603 | **デバウンス + ノイズ対策** (`R4·C1` = 10 ms) |
| **C2** | セラコン | **100 nF** | 0603 | **`U1` VDD パスコン (`+3V3`—GND 間・並列)**。⚠️ **直列に入れると `U1` が無通電になる** |
| **D1** | LED 赤 | Vf ≈ 2.0 V | 0603 | **電源 ON 表示** |
| **D2** | LED 赤 or 橙 | **Vf ≈ 2.0 V の色に限る** | 0603 | **充電中 / 満充電 / 異常 (点滅)** |
| **R1** | 抵抗 | **680 Ω** | 0603 | `D1` 電流制限。`PWR_EN` = 3.3 V CMOS 駆動 → 1.9 mA |
| **R2** | 抵抗 | **100 Ω** ⚠️ **680 Ω から変更** | 0603 | `D2` 電流制限。**IP2326 のメーカー指定値**。pin 6 の出力電圧が未規定なので独自計算してはいけない ([`docs/02`](02-ip2326-module.md) §3.5) |

#### 確定したネット名とコネクタのピン割り当て (KiCad 正本)

**2026-08-11 更新: 共通カソード方式に改版した KiCad 図に合わせて確定。**
**コネクタの Ref は `J1` / `J2`** (本 doc の旧称 `CN1` / `CN2` は破棄)。

| コネクタ | pin | ネット名 | 接続先 (北極側) | 電源基板側 |
| --- | --- | --- | --- | --- |
| **`J1` (2P・電源)** | 1 | **`GND`** | `U1.VSS` / `C1` / `C2` / `R4` / `C28` | GND |
| | 2 | **`+3V3`** | `U1.VDD` / `C2` / `R3` | `U3` (HT7333-1) 出力 = `V3P3` |
| **`J2` (1×4・信号)** | 1 | **`LED_K`** | **`D1` / `D2` の共通カソード** | **`Q1` (2N7002) のドレイン** |
| | 2 | **`OUT`** | ダイオード OR ノード | `R19` → `U4` → `U5.CP` |
| | 3 | **`CHG_LED`** | `R2` → `D2` **アノード** | **`U1.6` (IP2326 LED pin)** |
| | 4 | **`PWR_EN`** | `R1` → `D1` **アノード** | **`U5.Q` (D-FF)**。`U2.EN` と共用 |

#### ★ネット名は電源基板 (EasyEDA) 側に寄せる — 2026-08-11 ユーザー決定

<confirmed>
**正式名は電源基板側の名前とする。北極 KiCad 側をリネームする。**

| 現 KiCad (北極) | → | **正式名** | 備考 |
| --- | --- | --- | --- |
| `OUT` | → | **`HALL_OUT`** | ただのローカルラベル。文字を書き換えるだけ |
| `+3V3` | → | **`V3P3`** | **KiCad の電源シンボルはネット名 = `Value` フィールド**。`power:+3V3` を置いたまま **Value を `V3P3` に変える**だけでネット名が変わる (専用シンボルを作る必要はない) |
| `GND` | → | `GND` | 両側同じ。変更なし |
| `LED_K` / `PWR_EN` / `CHG_LED` | → | 同名 | 既に一致している |

⚠️ **`V3P3` に改名したら、`power:+3V3` シンボルの見た目 (表示文字) も `V3P3` になる。**
電源基板の netport 名と一致するので、ハーネスを作るときの読み違えが無くなる。
</confirmed>

#### ★LED の極性 — ここを間違えると点灯しない

**`D1` / `D2` は必ず「アノードが `PWR_EN` / `CHG_LED` 側、カソードが `LED_K` 側」**にする。

```text
PWR_EN  ──[R1 680Ω]──▶|── LED_K        ← D1 (電源 ON)
CHG_LED ──[R2 100Ω]──▶|── LED_K        ← D2 (充電)
                       ▲
                  アノードが左 / カソードが右 (LED_K 側)
```

- `PWR_EN` / `CHG_LED` が**電流を吐き出す側**、`LED_K` が**電流を受ける側** (電源基板の `Q1` が GND へ落とす)
- **逆向きに描くと LED は 1 度も点かない。** `R` と LED の前後は電気的に等価なので入れ替えてよいが、
  **ダイオードの向きだけは等価でない**

✅ **2026-08-11 の KiCad 図は向きが正しい** (`kicad-cli sch export netlist` で検証):

```
PWR_EN  : J2.4, R1.1        →  Net-(D1-A) : R1.2, D1.2[A]    ← アノードが駆動側 ✓
CHG_LED : J2.3, R2.1        →  Net-(D2-A) : R2.2, D2.2[A]    ← 同じく ✓
```

⚠️ **ただし `D1` / `D2` のカソードが未接続だった** — これが本当の欠陥:

```
unconnected-(D1-K-Pad1) : D1.1[K]      ← 浮いている
unconnected-(D2-K-Pad1) : D2.1[K]      ← 浮いている
LED_K                   : J2.1 のみ    ← カソードが来ていない
```

**必要な修正: `D1.1` と `D2.1` を束ねて `J2.1` (`LED_K`) へ配線する。** これだけで回路は完成する。

#### ★ダイオード OR — 線を 6 本に保ったままスイッチを足す (案 2・2026-08-11 確定)

```text
                     C2 100nF ← U1 の VDD パスコン (+3V3—GND 間・並列)
                        │
   +3V3 ────────────────┴── U1.2 (VDD)
                             │
   U1.3 (OUT / CMOS) ──[D3]──┬──────────── OUT  ──> 電源基板へ
                      A    K │
                             │
       +3V3 ──[R3 1k]── SW1 ─┤   ← 突くと H に引き上げる
                             │
                             ├──[R4 100k]── GND      ← プルダウン
                             │
                          [C1 100nF]                 ← τ = 10ms
                             │
                            GND
```

| 状態 | `OUT` | 判定 |
| --- | --- | --- |
| 磁石なし・SW 押さず | ホールが L → **D3 が逆バイアスで遮断** → `R4` が 0 V に固定 | L (何も起きない) |
| **磁石をかざす** | ホールが H → D3 導通 → **3.3 − 0.6 = 2.7 V** | **H** (VIH 2.0 V に対し余裕) → トグル |
| **SW1 を突く** | `+3V3` → `R3` → ノード。`R4` は 100 kΩ なので **3.27 V**。**このとき D3 は逆バイアスでホールの L 出力を遮断** | **H** → トグル |

**`D3` が要点。** ホール素子は CMOS 出力なので、そのまま並列にすると
スイッチが H に引こうとしても**ホールの L 側ドライバ (Ron 約 50 Ω) が勝ってしまう**。
`D3` を入れると**ホールは「上げる」ことしかできなくなり**、スイッチと衝突しない。

⚠️ **`C2` は `+3V3` と `GND` の間に並列**に入れる。**`+3V3` → `C2` → `U1.VDD` と
直列にしてはならない** — `U1` が無通電になり回路全体が死ぬ (作図レビューで実際に出た誤り)。

- **SW1 は磁石と完全に等価なトグル**になる (強制 ON ではない) → 磁石紛失時の完全な代替
- **デバウンスは `R4·C1` = 10 ms が兼務**。Schmitt (`74LVC1G17`) は任意に遅い遷移を受け付けるので問題ない
- **電源基板の変更は不要** — `R1` DNP / Schmitt = バッファ という確定事項がそのまま生きる
- オフ時電流への影響 **0** — ホールが L のとき `R4` に電流は流れない

#### SW1 を実装しない / 配線しない場合 — **問題なく動きます**

**`D3` / `R4` / `C1` の 3 点だけで回路は完結している**ので、`SW1` は**任意実装 (オプション)** にできる。

| 構成 | `OUT` の挙動 |
| --- | --- |
| SW1 あり | 磁石 **または** 突きでトグル |
| **SW1 未実装 / 未配線** | **磁石のみでトグル。他は一切変化なし** ✓ |

`SW1` の端子が開放でも、ノードは `R4` で確実に 0 V に固定されるため**浮きません**。
したがって **「とりあえずフットプリントと配線を入れておき、実装は後で決める」**という運用が安全にできる。
**配線しておくコストはゼロ**なので、パターンは引いておくことを推奨する。

⚠️ **緑・青は使えない。** InGaN 系は **Vf = 3.6 V** で、`LED_VCC` = 3.3 V では
順方向電圧に届かず点灯しない。**赤 / 橙 / 黄 (Vf ≈ 2.0 V) から選ぶ。**

#### S-5716A のピン配置 (EasyEDA ライブラリの検証済みシンボルから確定)

| pin | 名前 | 接続 |
| --- | --- | --- |
| **1** | **VSS** | `GND` |
| **2** | **VDD** | **`V3P3`** (常時オン。2.7〜5.5 V の範囲内 ✓) |
| **3** | **OUT** | **`HALL_OUT`** → pillar 経由で電源基板へ |

**プルアップとノイズフィルタは北極側に置かない** — 電源基板側の `R1 100 kΩ`
(OD 出力なら実装 / CMOS 出力なら DNP) と `R2 1 kΩ + C5 1 nF` が担当する
([`docs/06`](06-power-switch.md) §4.9)。**北極基板は素子を出すだけ。**

#### 電流制限抵抗 — **2 灯で値が違う**

**`R1` (電源 ON / `D1`)**: アノードを `PWR_EN` = **D-FF の Q (3.3 V CMOS)** が駆動する。
Vf = 2.0 V、`Q1` の Vds(on) ≈ 0.05 V として:

```
R1 = (3.3 − 2.0 − 0.05) / 2 mA = 625 Ω  →  E24 で 680 Ω  →  実効 1.84 mA
```

**`R2` (充電 / `D2`)**: アノードを `CHG_LED` = **IP2326 pin 6** が駆動する。
**pin 6 の出力電圧はデータシートに規定が無い**ため、この式は使えない。
**メーカー指定の 100 Ω をそのまま採用する。**

⚠️ **旧版で「100 Ω では 13 mA になり定格超過」と書いていたのは誤り。**
あれは「アノードを `V3P3` = 3.3 V で駆動する」というシンク前提の計算で、
実際は pin 6 が駆動源なので**その電圧が分からない限り電流は計算できない**。
100 Ω がメーカー標準回路の値である以上、**pin 6 の compliance は 2.5 V 前後か、
内部で 5 mA に自己制限している**と読むのが自然。**実機で実測すること (V15)。**

| 系統 | 抵抗 | 電流 | 制約の確認 |
| --- | --- | --- | --- |
| `D1` (電源 ON) | **680 Ω** | 1.84 mA | `U5` (74LVC1G74) の出力は ±24 mA 級。`VOH` 低下は数十 mV で `U2.EN` に影響しない |
| `D2` (充電) | **100 Ω** | **未確定 (≤5 mA)** | pin 6 の出力電圧が未規定。**メーカー指定値なので 5 mA 内のはず**だが実測が必要 (V15) |

#### 電源 OFF 中の消費

**アノード側が両方とも「駆動されていないとき Low」なので、電流は流れない:**

| 状態 | `D1` (`PWR_EN` 駆動) | `D2` (pin 6 駆動) | `V3P3` からの消費 |
| --- | --- | --- | --- |
| 電源 OFF・充電なし | `Q` = L → **消灯** | pin 6 出力なし → **消灯** | **0 mA** ✓ |
| 電源 OFF・充電中 | `Q` = L → 消灯 | **点灯** | 充電器が給電中なので問題なし |
| 電源 ON | 点灯 | 充電中なら点灯 | システムが 0.6 A 以上引くので無視できる |
| **動画再生中** | **消灯** | **消灯** | `Q1` が `LED_K` を切る (veto) |

✅ **オフ時電流への寄与は 0。** `V3P3` は LED 経路に一切関与しない (アノードは `PWR_EN` / pin 6)。

#### 接続まとめ (6 本・[§4.2](#42-北極-pillar-を通る配線--6-本) と一致)

| 線 | コネクタ | 北極側 | 電源基板側 |
| --- | --- | --- | --- |
| `GND` | **J1.1** | `U1.1` (VSS) / `C1` / `C2` / `R4` | GND |
| `+3V3` | **J1.2** | `U1.2` (VDD) / `C2` / `R3` | `U3` HT7333-1 出力 (常時オン) |
| `LED_K` | **J2.1** | `D1` / `D2` の共通カソード | `Q1` (2N7002) のドレイン → GND |
| `OUT` | **J2.2** | `U1.3` (OUT) → `D3` → OR ノード | `R19` 1 kΩ → `U4` Schmitt → `U5.CP` |
| **`CHG_LED`** | **J2.3** | `R2` 100 Ω → **`D2` アノード** | **IP2326 pin 6 (ソース)** |
| **`PWR_EN`** | **J2.4** | `R1` 680 Ω → **`D1` アノード** | **`U5.Q` (D-FF)**。`U2.EN` と共用 |

#### コネクタの分割 (2026-08-11 確定)

**電源 2 極 + 信号 4 極の 2 コネクタに分ける。** 南極の送信側基板が `J2`(2.00 mm) / `J3`(2.54 mm) と
ピッチ違いで 2 個持っているのと同じ流儀。

| コネクタ | 極数 | 信号 | 備考 |
| --- | --- | --- | --- |
| **`J1` (電源)** | **2** | `GND` / `+3V3` | ホール素子と SW プルアップの電源。**常時オン系** |
| **`J2` (信号)** | **4** | `LED_K` / `OUT` / `CHG_LED` / `PWR_EN` | 最大電流は `LED_K` の 2 灯合計 (`D1` 1.84 mA + `D2` ≤5 mA) なので信号側で問題ない |

- 電源系と信号系を分けることで、**組立時の挿し間違いが物理的に起きにくくなる**
- ✅ **旧版の「`V3P3` と `LED_VCC` を同じコネクタに入れない」という禁止は不要になった** —
  `LED_VCC` が廃止され、veto は共通カソード `LED_K` を切る方式に変わったため
- 実装形態 (ピンヘッダか、パッドへ直ハンダか) は §7 Q9。
  **直ハンダにする場合は BOM と position ファイルから除外**する
- KiCad 正本では **`J1` (2P) / `J2` (1×4)** のシンボルで作図済み。**フットプリントは Q9 の決定待ち**

#### 回路図の外に残っている作業 (2026-08-11 時点)

**2026-08-11 に `kicad-cli sch export netlist` で実測した結果に基づく (推測なし)。**

| # | 作業 | 備考 |
| --- | --- | --- |
| **0** | **★`D1.1` / `D2.1` (カソード) を束ねて `J2.1` (`LED_K`) へ配線** | **現状 `unconnected-(D1-K-Pad1)` / `unconnected-(D2-K-Pad1)`。回路が未完成** |
| **0b** | **★`R2` を 680 Ω → 100 Ω に変更** | 現在 680 Ω。IP2326 pin 6 のメーカー指定値 (§5.2a 電流制限抵抗) |
| **0c** | **★ネット名を `OUT` → `HALL_OUT` / `+3V3` → `V3P3` にリネーム** | 上記「ネット名は電源基板側に寄せる」 |
| 1 | **`U1` の Value / MPN を `S-5716ACDH0-M3T1U` に設定** | **現在 `~` (未設定)**。§7 V14 の感度・出力形態の確定と同時でよい |
| 2 | ~~`SW1` のフットプリントを実測から自作~~ → **`Button_Switch_SMD:SW_SPST_PTS647_Sx50` を割当済み** | ⚠️ **手持ち `RT3301AF260Q` の実寸と一致するか要確認**。PTS647 は C&K の別品種 |
| 3 | **PCB 外形を φ14.7 mm で作成** | 南極送信側基板と同一寸法 (§5.0) |
| 4 | **`C2` を `U1` の VDD 直近に配置** | パスコンの意味を成立させる |
| 5 | **アクチュエータを五角形穴の片側へ、LED (`D1`/`D2`) を反対側へ配置** | φ5〜6 mm の穴を光路と機械アクセスで分け合う (§5.2) |

### 5.3 ホール素子の向き

- **磁石は北極の真上 (極軸方向) から近づく**
- ホール素子は**感磁面を極軸に対して垂直**に置く (磁束が素子面を貫くように)
- リードスイッチとは向きの考え方が違うので注意 (リードは長軸方向が高感度だった)

### 5.4 配線経路 — **親プロジェクトへの影響が縮小した**

基板は**内側の pillar 先端**にあり、**五角形穴は LED の窓としてしか使わない**ので、
**配線は穴を通らない。** したがって選択肢は 2 つ:

| 案 | 内容 | 親プロジェクトへの影響 |
| --- | --- | --- |
| **a. pillar の脇を通してコアへ落とす** | 通路を掘らない | **親 `CLAUDE.md` §2.8 の改訂が不要になる** ✓ |
| b. pillar 内部に Φ3 mm 通路を新設 | 南極 pillar と同じ手法。配線が保護され見た目も綺麗 | 親 `CLAUDE.md` §2.8「北極 pillar は配線通路不要」の改訂が必要 |

**a を選べば親プロジェクトの確定仕様を触らずに済む** ([§6](#d7-doc-改訂リスト) の `<impact>` が 1 件減る)。
どちらにするかは §7 Q8。

- どちらでも構造荷重には影響しない — 案 K_new で pillar はクランプ荷重を受けないため
- 6 本は AWG30 級で断面積 約 1.7 mm²。Φ3 mm 通路 (19.6 mm²) なら占有率 9% で余裕

---

## 6. Deliverables / 成果物と置き場所

| # | 成果物 | 置き場所 | 担当プロジェクト |
| --- | --- | --- | --- |
| D1 | 北極キャップ (透光) の 3D モデル + STL | 親リポジトリ `shell-cad/` | shell-cad |
| D2 | 北極 pillar の配線通路 Φ3 mm 追加 | 親リポジトリ `shell-cad/` | shell-cad |
| D3 | pillar 先端キャリア基板の座 (固定構造) | 親リポジトリ `shell-cad/` | shell-cad |
| D4 | キャリア基板の回路図 + PCB | **KiCad (正本・2026-08-11 に回路図レビュー完了)**。⚠️ EasyEDA には作らない — 試作した `Board2` は廃棄済み | 本プロジェクト |
| D5 | 電源基板側の LED 駆動 + veto 回路 (§4.3) | EasyEDA Pro `power-2S-02` の PMIC ブロック | 本プロジェクト |
| D6 | AtomS 接続用インターフェース — **I2C エキスパンダ (§4.4 案 1) なら I2C 2 線 + 電源、データ活動検出 (案 2) なら WS2812 線 1 本**。`PWR_OFF` も同経路に載せる | 同上 | 本プロジェクト |
| D7 | doc 改訂 (下表) | 各リポジトリ | — |

### D7: doc 改訂リスト

<impact>
**親リポジトリ (`FPC-isolation-sphere`) — ユーザー承認が必要**

| ファイル | 変更内容 |
| --- | --- |
| `CLAUDE.md` §2.8 極部 | 「**北極 pillar は配線通路不要**」→ **Φ3 mm 通路が必要**に改訂 |
| `CLAUDE.md` §2.8 極キャップ | 「北極: 純粋装飾蓋」→ **透光ステータス窓** |
| `CLAUDE.md` §2.7 BOM | Pillar 備考の改訂 / 細線 5 本 / キャリア基板 / ホール素子 / LED 2 個 / 磁石 を追加 |
| `CLAUDE.md` §3 Open Questions Q2 | ESP32 型番 — **M5 AtomS 系であることが判明**。正確な型番と 5 並列出力の可否を確定 |
| `docs/01-shell-cad.md` | 北極 pillar 通路 + キャリア基板座 + 透光キャップの造形仕様 |

**本リポジトリ (`power-2S-02`)**

| ファイル | 変更内容 |
| --- | --- |
| `CLAUDE.md` §4 Docs Index | 本 doc (08) の行を追加 ✅ (この作業で実施済み) |
| [`docs/06`](06-power-switch.md) | 電源 SW 方式の全面改訂 (ホール + LDO + D-FF + EN 制御) と LED 駆動・veto の追記 |
| [`docs/02`](02-ip2326-module.md) §3.5 | 充電 LED を北極へ移設 |
| [`docs/05`](05-jlcpcb-fab.md) | BOM 追加 (LDO / D-FF / ホール / MOSFET 2 / 抵抗 / LED) |
| [`HANDOFF.md`](../HANDOFF.md) | 作業状態の更新 |
</impact>

---

## 7. 着手前に解消すべき判断 / Decisions required before starting

<open_questions>
**この 4 件はユーザー判断。推論で埋めてはならない ([`CLAUDE.md`](../CLAUDE.md) §3)。**

- ~~**Q1: ホール素子の選定**~~ → **✅ 解決 (2026-08-11): `S-5716A` で確定。**
  ピン配置 (1=VSS / 2=VDD / 3=OUT) と諸元は §5.2a に記載。
  **LCSC にも SOT-23-3 品がある** (`C2152468` 等) ので、手はんだ / JLCPCB 実装のどちらも選べる。
  残るのは **感度ランク (Bop = 1.8 / 3.0 / 3.4 / 4.5 / 7.0 mT) の選択** → V14
- ~~**Q2: IP2326 pin 6 の駆動形式**~~ → **⚠️ 一度誤答したので訂正済み (2026-08-11)。**
  当初「シンク」と結論したが、**データシート Figure 5 を画像で確認した結果 `pin 6` は「ソース」**だった。
  `pin → LED → R → GND` はソース構成であり、「標準回路が LED + 抵抗を GND へ」という
  [`docs/02`](02-ip2326-module.md) の記述をシンクと読み違えていた。
  **正しい結論: ソース / 最大 5 mA / 出力電圧は未規定。** → **LED は共通カソード方式**にする
  (§5.2a の訂正ブロック)。アノード共通レール `LED_VCC` 方式は**成立しないので廃止**
- ~~**Q6: キャリア基板に他に載せるものはあるか**~~ → **✅ 解決 (2026-08-11): 単色 2 灯 (案 A) で確定。**
  RGB LED は **緑・青の Vf = 3.6 V が 3.3 V レールで点灯しない**ため不採用 (§5.2a)
- **(旧 Q1 の記述は以下に保存)** ホール素子を S-5716A と DRV5032 のどちらにするか:
  キャリア基板を JLCPCB で実装させるなら DRV5032、手はんだなら秋月品で足りる。
  - 未確認の技術事項: 秋月の `S-5716ACDH0-M3T1U` は商品ページに「動作磁束密度 0.9 mT / 0.3 mT」
    「アナログ出力」と記載されているが、**ABLIC データシートの Bop 選択肢は 1.8/3.0/3.4/4.5/7.0 mT で
    出力はデジタル (OD / CMOS)** で一致しない。**ABLIC のパーツリストで実際の品種を確定させること**
- **Q2: IP2326 pin 6 (LED 出力) の駆動形式** — シンク (オープンドレイン) かソースか。
  直列抵抗値とアノードの取り方が決まる。データシートで確認 ([`docs/02`](02-ip2326-module.md))
- ~~**Q3: 音 (ブザー) を追加するか**~~ → **✅ 解決 (2026-08-11): 鳴らさない。光のみで確定。再提案禁止**
- **Q6: キャリア基板に他に載せるものはあるか。** **現在の搭載予定は 5 部品のみ**
  (ホール素子 ×1 / LED ×2 / 抵抗 ×2)。以下は**候補として挙げるだけで未決定** — §8 の完了条件には含めない:

  | 候補 | 得られるもの | コスト / 前提 |
  | --- | --- | --- |
  | **RGB LED (WS2812 など) 1 灯に統合** | 単色 2 灯より多くの状態を 1 つの窓で表現できる (残量・エラー種別・待機など) | データ線が必要 → **AtomS3R の GPIO 枯渇に直撃**。I2C エキスパンダ経由の RGB ドライバなら可 |
  | **環境光センサ (I2C)** | 暗所で自動減光。**透光キャップの真下は設置場所として理想的** | I2C バスに相乗り (§4.4 案 1 と同じ前提)。親プロジェクトの輝度上限運用と相性が良い |
  | **2 個目のホール素子** | 磁石の当て方で複数コマンド (向き検出など) | 用途が未定義。現時点で必要性なし |
  | ~~ブザー~~ | — | **却下済み (Q3)** |
  | ~~異常表示用の追加 LED~~ | — | **不要** — IP2326 が異常時に点滅させるので充電 LED 1 灯で 3 状態を表現できる |
  | ~~ESD 保護素子~~ | — | **不要** — キャリア基板は外殻内部で外界と電気的に接触しない (磁石は非接触)。ボタン方式で必須だった TVS が要らなくなった |

  ⚠️ **温度センサはこの基板に載せない。** 密閉球体内で MP1584 が最悪 1.28 W / ΔT 64 °C を出すため
  監視自体は価値があるが、**測るべき場所は MP1584 と電池の近傍**であって北極ではない。
  必要なら [`docs/04`](04-layout-thermal.md) 側の別項目として扱う
- **Q4 (更新): 北極キャップと LED 窓の両立方法** — 五角形穴を窓に使うため、
  **不透明キャップが穴を覆うと光が出ない**。a: キャップに開口 / b: 半透明 PETG / c: キャップなし (§5.1)
- **Q7 (NEW): 北極基板の固定方法** — 南極の送信側基板は取付穴を持たない。
  pillar 先端の座 + 配線で保持するか、Φ2 級の取付穴を設けるか (**接着剤は禁止**)
- **Q9 (NEW): CN1 / CN2 の実装形態** — ピンヘッダを実装するか、パッドへ直ハンダか。
  直ハンダなら BOM / position から除外する
- **Q10 (NEW): `SW1` を初期ロットで実装するか** — 回路は `SW1` 無しでも成立する (§5.2a)。
  **パターンは引いておき、実装は後決め**が安全
- **Q8 (NEW): 配線経路** — pillar の脇を通す (親 doc の改訂不要) か、Φ3 mm 通路を掘るか (§5.4)
- ~~**Q5: M5 AtomS3R の全ピン割り当て**~~ → **✅ 一部解決 (2026-08-11)**:
  **Grove は BNO055 が使用中**だが **I2C 端子は電源基板上に実装済みで使用可能**。
  したがって **§4.4 案 1 (I2C GPIO エキスパンダ) で確定**し、
  **`PWR_OFF` もスコープに入れる** (従来のペンディングを解除)。
  残る確認は V7〜V9 に移した

**技術的な未確認事項 (調査で潰せる)**

- **V1: 磁石の選定と動作距離の実測** — 外殻 5 mm + 隙間 = 合計 6〜8 mm を隔てて Bop を超えられるか。
  **計算より実測が速い。** ホール素子と一緒にネオジム磁石を数サイズ購入して測る
- **V2: 磁石を製品 BOM に載せるか**、ユーザー手持ち運用にするか
- **V3: AtomS の起動時間の実測 + フレーム送出の挙動** — 起動から最初の WS2812 フレームまでの時間。
  **待機中も黒フレームを流し続ける実装かどうか** (§4.3 案 A の意味論に直結)
- **V4: ~~veto に使える GPIO の選定~~** → **GPIO 枯渇のため §4.4 の拡張方式選定に置き換え**。
  型番は **M5 AtomS3R** と判明 (親 `CLAUDE.md` Q2 の解消材料)。
  **5 並列 PIO/RMT 出力が要件**なので、AtomS3R でそれが成立しているかも併せて記録する
- **V7 (最重要): GPIO エキスパンダの品番確定。** 選定条件は 3 つとも必須:
  1. **power-up 時に出力が H にならないこと** (入力/高インピーダンスで起動する)。
     **`PCF8574` は power-up 時に出力 H なので採用不可** — §4.4 ② の topology では
     **起動と同時に電源が切れる**。`PCA9536` は power-up 時に全ピン入力なので条件を満たす見込み
  2. **BNO055 (0x28/0x29) とアドレスが衝突しないこと**
  3. LCSC 在庫とパッケージ (40×40 片面実装に載ること)
- **V8: AtomS3R の `3V3` 出力ピンの有無と供給能力** — エキスパンダ + N-MOS ゲートで
  数百 µA。ここから給電できればレベル変換が不要になる (§4.4 ①)
- **V9: I2C バスのプルアップ抵抗**が電源基板側にあるか AtomS3R 側にあるか。
  二重に付いていないか (バス容量とプルアップ値の確認)
- **V10: D-FF の `CLR` に対する `PWR_OFF` のレベル整合** — LVC の VIL/VIH と
  大きなプルアップでのリーク (LVC 入力リーク ±1 µA max) を確認。§4.4b では 470 kΩ を仮採用
- **V11 (§4.4a を使う場合): `R4` の給電元** — `V3P3` から取ると電源 OFF 中も 3.3 µA 流れる。
  `LED_VCC` か ON ドメインから取れないか検討
- **V12 (§4.4a を使う場合): GPIO06 の 100 ms DC High がスピーカに与える影響** —
  直結駆動ならコイルに直流が流れる。素子の直流耐性と「プツッ」音の許容を確認
- **V14 (NEW): S-5716A の感度ランクと出力オプションの確定。**
  データシートの品名構成表 (2 ページ目以降) が PDF テキスト抽出不能で未確認。確定させたいのは 3 点:
  1. **`P4` の数字と Bop の対応** — 1.8 mT (最高感度) がどのランク番号か。外殻 5 mm を隔てた検出距離に直結
  2. **`P2` = D / S が「Nch オープンドレイン / CMOS」のどちらを指すか** — 電源基板の `R1 100 kΩ` を実装するか DNP にするかが決まる
  3. **`P3` = H / L が「アクティブ H / アクティブ L」のどちらか** — 電源基板の Schmitt を
     `74LVC1G14` (インバータ) か `74LVC1G17` (バッファ) のどちらにするかが決まる
  ⚠️ **いずれも設計は両対応済み**なので回路図は描ける。**部品発注前に確定**させればよい
- **V13 (★最優先・§4.4b): PCA9632 の datasheet 照合と入手性**
  1. **power-up 時に全出力がオフ (LED 消灯) であること** — boot-safe の根拠。**要明文確認**
  2. **消費電流** (動作時 / スリープ時) — ON ドメイン給電なのでオフ時電流には効かないが、
     5V 系の負荷として把握する
  3. **オープンドレイン出力の VOL とシンク能力** — N-MOS ゲートと `CLR` を確実に GND へ引けるか
  4. **LCSC の在庫とパッケージ** (`PCA9632DP1` = TSSOP-8 / DFN 小型品種の有無)
  5. **I2C アドレス 0xC4 (7bit 0x62)** が BNO055 (0x28/0x29) と衝突しないこと ✓ (既に確認済み)
- **V5: pillar 先端の実寸** — キャリア基板の外形が決まる。親 `docs/01-shell-cad.md` を参照
- **V6: HT7333-1 の入力電圧上限**が 2S 8.4 V に対し十分か (LCSC 表記 30 V を datasheet で裏取り)
</open_questions>

---

## 8. Acceptance criteria / 完了条件

- [ ] **磁石をかざした瞬間** (AtomS の起動を待たず) に北極が点灯する
- [ ] **起動中も点灯し続ける** — AtomS の GPIO が High-Z の間、pulldown で LED が生きている
- [ ] **再生開始で消灯する** — §4.4 で選んだ方式 (I2C エキスパンダ / データ活動検出 / タイムアウト) で消える
- [ ] **veto 経路が AtomS3R の GPIO を 1 本も新規に消費していない** (§4.4 の前提)
- [ ] **もう一度かざすと即座に消灯**し、電源が切れる
- [ ] **firmware から I2C 経由で電源を切れる** (`PWR_OFF`)。切れた後に再投入ループが起きない
- [ ] **電源 OFF 中のリーク経路が無い** — エキスパンダ未通電時にプルアップ電流が
      ESD ダイオードへ流れ込んでいないこと (実測でオフ時電流を確認)
- [ ] **エキスパンダの power-up 出力状態で誤動作しない** — 起動と同時に
      電源が切れたりステータス窓が消えたりしないこと
- [ ] **電池を挿した直後は消灯 (電源 OFF)** — D-FF の POR で保証
- [ ] **電源 OFF のまま充電すると充電 LED だけが点く**
- [ ] **動画再生中は電源 ON LED と充電 LED の両方が消灯する**
- [ ] **ホール素子は veto 中も動作している** — 再生中に磁石をかざして電源を切れること
      (`V3P3` と `LED_VCC` を共用していないことの確認)
- [ ] **南極の充電マグネットを着脱してもホール素子が誤反応しない**
- [ ] オフ時のシステム合計電流が **≤50 µA** (設計見込み: LDO 2.5 + ホール 1.6〜4.0 + D-FF ~1 + MP1584 12 + IP2326 0.7 ≈ **18〜21 µA typ**)
- [ ] **北極キャップを外しても配線を触らずに済む** (素子は pillar 側)
- [ ] **接着剤を 1 箇所も使っていない**

---

## 9. Hard rules / 厳守事項

<hard_rules>
- **NEVER** 接着剤・瞬間接着剤・エポキシで固定する (親プロジェクトの全損事故履歴)
- **NEVER** 連続動作型のホール IC (mA 級) を使う — オフ電流予算 50 µA を 100 倍超える
- **NEVER** ホールラッチ (bipolar latch) を使う — 磁石を裏返す操作が必要になり UX が成立しない
- **NEVER** MP1584 の EN を 2S レール (6.0〜8.4 V) に接続する — **絶対最大 6 V**
- **NEVER** veto 回路の pulldown 抵抗を省略する — 起動中に消灯する事故になる
- **NEVER** 未確定の寸法・型番で確定させない。§7 は必ずユーザーに確認する
- **ALWAYS** 親リポジトリの doc を変更する前にユーザー承認を取る (親 `CLAUDE.md` §8.4)
- **ALWAYS** 全実装部品に LCSC 番号を設定する。ただし**秋月調達品は手はんだ前提で例外扱い**とし、
  その旨を BOM に明記する ([`docs/05`](05-jlcpcb-fab.md))
- **ALWAYS** ドキュメントに絶対パスを書かない (作業機が変わる前提)
</hard_rules>

---

## 10. References

- [`CLAUDE.md`](../CLAUDE.md) — 本プロジェクトの確定仕様・厳守事項
- [`HANDOFF.md`](../HANDOFF.md) — 作業状態と次アクション
- [`docs/02`](02-ip2326-module.md) §3.5 — IP2326 の LED 出力ピン
- [`docs/03`](03-mp1584-module.md) §3.7 / §3.9 — MP1584 の EN 仕様とシャットダウン電流
- [`docs/06`](06-power-switch.md) — 電源 ON/OFF 回路 (**本 doc と一体で改訂が必要**)
- 親リポジトリ `CLAUDE.md` §2.8 — 極部 (pillar / キャップ) の現行仕様
- 親リポジトリ `docs/01-shell-cad.md` — 外殻・pillar の造形
- 部品: [ABLIC S-5716 シリーズ](https://www.ablic.com/en/semicon/datasheets/sensor/magnetism-sensor-ic/s-5716/) /
  [秋月 116180](https://akizukidenshi.com/catalog/g/g116180/) /
  [LCSC C3716252 (DRV5032FALPG)](https://www.lcsc.com/product-detail/C3716252.html) /
  [LCSC C70285 (SN74LVC1G74)](https://www.lcsc.com/product-detail/Flip-Flops_Texas-Instruments-SN74LVC1G74DCUR_C70285.html) /
  [LCSC C77777 (HT7333-1)](https://www.lcsc.com/product-detail/C77777.html)
