sastles-com/power-2S-02/docs/09-system-structure.md

# 09 — システム構造とボード間インターフェース

<subproject>
- name: system-structure
- parent: power-2s-02 (さらに親: Isolation Sphere V2)
- status: **draft — 未確定 5 件あり (§6)。確定した項目のみ確定として記載**
- created: 2026-08-11
- depends_on: [06-power-switch, 08-north-status-window, 親リポジトリ CLAUDE.md]
</subproject>

## 0. この doc の役割

**電源基板 (power-2S-02) から見た「何が何につながっているか」の地図。**
球体全体の設計が複数の基板に分かれてきたため、**インターフェースの取り合いを 1 箇所に集約する。**

⚠️ **確定したハード仕様 (球体寸法・LED 総数・カセット構成など) はここに書かない。**
親リポジトリの `CLAUDE.md` が正本で、ここからは参照するだけ (親 `CLAUDE.md` §8.2 の重複禁止)。

---

## 0.5 実基板の解析結果 (2026-08-11) — **一次情報**

<confirmed>
**mother-ring / core-M5atom-FPC の KiCad プロジェクトからネットリストを抽出して確定させた。**
推測ではなく実データ。親リポジトリの `kiban/resized/` 配下に実在する。

| プロジェクト | 部品 | ネット | 役割 |
| --- | --- | --- | --- |
| `mother-ring` | 25 | 25 | 赤道ドーナツ基板。**外形 約 φ82 mm** |
| `core-M5atom-FPC` | 19 | 16 | **B2 = core 基板の正体**。M5AtomS3R + BNO055 + スピーカ |

### 判明した接続 (抜粋)

```text
[power-2S-02] ─J7 POWER-02─ [mother-ring] ─J8/J9 ESP32-01─ [core-M5atom-FPC]
                J6 POWER-01                                  ├ J4 M5atomS3-R
                                                             ├ U1 AE-BNO055
                     │                                       └ LS1 SPEAKER
                     └─ J1..J5 pogo-pad 1x06 ─> 各カセット
                        5V-GND-DIN-DOUT-GND-5V (回文) ✓ 親 CLAUDE.md §2.6 と一致
```

| 発見 | 内容 |
| --- | --- |
| **GPIO06 のスピーカ結線** | `GPIO06 → R1 (0Ω) → C7 (0.1µF) → LS1 (PKLCS1212)`。**`R1` が 0 Ω = 事実上のジャンパ**で、外せば切り離せる。**`C7` で AC 結合**されているので直流はコイルに流れない |
| **WS2812 の駆動** | `GPIO01〜05` → core `J17` → ring `J9` → **33 Ω ダンピング抵抗 (R1〜R5)** → `DIN01〜05`。`DOUT` は各コネクタで終端 (戻さない) ✓ |
| **I2C の所在** | `SDA/SCL` は core `U1`(BNO055) / `J9`,`J10`(Grove) / `J16` → ring `J8.3`,`J8.4` → ring **`J16` (2 ピン)** に引き出し済み |
| **I2C プルアップ** | **AE-BNO055 基板に実装済み → 追加不要** (2026-08-11 ユーザー確認) |
| ring の `+3V3` | **M5AtomS3R の 3V3 ピン由来** (`J4.1 → J16.6 → J8.6 → J13.2`) = **ON ドメイン** |
| `J7` の未使用ピン | **`J7.5 = BM` / `J7.6 = P+` は使用しない** (電池と BMS は電源基板へ直接ワイヤ接続のため) |
| ring の空き面積 | 部品は半径 23.7〜40.8 mm の帯に集中。**角度方向に 33°/41°/69°/47° の空きがあり、40° の扇形で約 400 mm²** |
</confirmed>

## 0.6 確定した設計判断 (2026-08-11 ユーザー決定)

<confirmed>
| # | 判断 | 内容 |
| --- | --- | --- |
| 1 | **PCA9632 は mother-ring に実装する** | I2C (`SDA`/`SCL`/`+3V3`) が**すべて ring 上でローカルに揃う**ため。空き 400 mm² に対し 17 mm² |
| 2 | **`J7.5`/`J7.6` を `VETO`/`PWR_OFF` に転用** | BM/P+ が未使用なので振り替える。**新規コネクタはゼロ** |
| 3 | ~~`5V-ALWAYS` → `V3P3-ALWAYS`~~ → **`J6.4`/`J6.5` を `SDA` / `SCL` に振り替える** (2026-08-11 再決定) | EN 制御では常時オン 5V を作れず、かつ **`V3P3-ALWAYS` は負荷がゼロのまま**だった。**実需のある I2C (電源基板側の残量測定用) に振り替える**方が合理的。⚠️ **これにより「3.3 V が 2 系統」の危険が消滅する** (下記) |
| 4 | **北極コネクタ `CN7` は 6 極で確定** | `V3P3` / `GND` / `HALL_OUT` / `LED_VCC` / `STAT_PWR_K` / `STAT_CHG_K`。[`docs/06`](06-power-switch.md) の 5 極を **6 極に改める** |
| 5 | mother-ring と core は**改版可能** | 上記 1〜3 は ring の改版を要する |
</confirmed>

### ✅ 解消済み: 「ring 上に 3.3 V が 2 系統」の危険

**判断 3 を「`J6.4`/`J6.5` → `SDA`/`SCL`」に変更した結果、`V3P3-ALWAYS` は存在しなくなり、
この危険は消滅した (2026-08-11)。ring 上の 3.3 V は `V3P3-SW` の 1 本だけ。**

- ring 側で必要な作業が減った: **`V3P3-ALWAYS` ネットの新設が不要**、
  **`J12` の意味変更も不要** ([`docs/10`](10-ring-core-revision.md) §1.5)
- `+3V3` → `V3P3-SW` のリネームは**既に実施済み**で、1 本しかなくても
  「常時オンでない」ことが名前で分かるので**そのまま維持する**

以下は判断の経緯として保存する。**現在は該当しない。**

#### (旧) 危険: ring 上に 3.3 V が 2 系統できる

| ネット | 供給元 | ドメイン | 用途 |
| --- | --- | --- | --- |
| **`+3V3`** (既存) | **M5AtomS3R の 3V3 ピン** | **ON ドメイン** (AtomS3R と一緒に落ちる) | **PCA9632 の VDD** / I2C プルアップの基準 |
| **`V3P3-ALWAYS`** (新規) | **電源基板の HT7333-1** | **常時オン** | 将来の常時給電用 (現時点で負荷なし) |

**NEVER この 2 本を接続してはならない。** 接続すると:

1. 常時オン側が AtomS3R の内部レギュレータ出力を**逆給電**する → 電源 OFF 中も AtomS3R が中途半端に通電し、
   リーク増加と不定動作を招く
2. **PCA9632 のレジスタが電源 OFF でリセットされなくなる** → 前回の `VETO` 状態が残り、
   **次回起動時にステータス窓が点かない** ([`docs/08`](08-north-status-window.md) が解決しようとしている問題の再発)

**対策: ネット名を紛れない形に改める。** `+3V3` → **`V3P3_SW`** (switched / AtomS3R 由来) のように、
「常時オンか否か」が名前で判別できるようにすること。ring 改版時に必ず実施する。

## 1. 基板・アセンブリの一覧

| # | 名称 | 中身 | 管轄 |
| --- | --- | --- | --- |
| **B1** | **電源基板 `power-2S-02`** | 40×40 / 4 層 / 片面実装。IP2326 充電・MP1584 5V 3A・常時オン 3.3 V LDO・電源ラッチ (D-FF)・LED レールスイッチ | **本プロジェクト** |
| **B2** | **core 基板** = `core-M5atom-FPC` | **M5 AtomS3R** (`J4`) + **BNO055** (`U1` AE-BNO055) + **スピーカ** (`LS1` PKLCS1212) + WS2812 5 系統のファンアウト。**部品 19 / ネット 16** | 親 `kiban/resized/core-M5atom-FPC` |
| **B3** | **mother-ring** = `mother-ring` | 赤道ドーナツ基板 **外形 約 φ82 mm**。pogo パッド ×5 + 33 Ω ダンピング抵抗 + **PCA9632 (新規実装・§0.6)**。**部品 25 / ネット 25** | 親 `kiban/resized/mother-ring` |
| **B4** | `inner_deck` × 10 | 小型 FR4。上面 = FPC 半田パッド 6 / 下面 = DIP ポゴピン 6 | 親 `01-shell-cad.md` |
| **B5** | **北極キャリア基板** (新規) | ホール素子 ×1 + 状態 LED ×2 + 抵抗 ×2 | [`docs/08`](08-north-status-window.md) |
| **B6** | 共通骨組み FPC × 10 | WS2812-2020 × 80/枚 = 計 800 | 親 `02-fpc-kicad.md` |
| — | XR-2S-30A BMS | **基板外・ワイヤ接続** (B+/BM/B−/P+/P−) | 市販品 |
| — | LiPo 2000 mAh × 2 | 2S 直列 | 市販品 |

---

## 2. 全体ブロック図

```text
                        ┌──────────── 北極 (ステータス窓) ────────────┐
                        │  B5 キャリア基板                             │
                        │   ホール素子 / LED_PWR / LED_CHG            │
                        └───────────────┬─────────────────────────────┘
                                        │ 6 本 (§4.1)   [北極 pillar Φ3mm 通路]
                                        │
  南極 磁気端子 ──CHG_IN──┐             │
   (Φ4mm 2極)             │             │
                          v             v
  ┌──────────────────────────────────────────────────────────────┐
  │  B1  電源基板 power-2S-02  (40×40 / 4層)                      │
  │                                                              │
  │   IP2326 充電 ──BATT_P/BM/BATT_N──> [XR-2S-30A BMS] ──PACK_P─┐│
  │        │ pin6 = 充電LED                                      ││
  │        └──────────────────────> LED_CHG (北極へ)             ││
  │                                                              ││
  │   HT7333-1 LDO ──> V3P3 (常時オン 3.3V / 2.5µA)              ││
  │        ├──> ホール素子 (北極)                                 ││
  │        ├──> D-FF (電源ラッチ)                                 ││
  │        └──> 各プルアップ                                      ││
  │                                                              ││
  │   HALL_OUT ─> 74LVC1G14 (Schmitt インバータ) ─> D-FF の CLK   ││
  │        ⚠️ 直結は規格違反 (docs/06 §4.3)                        ││
  │   D-FF (74LVC1G74): SD=強制ON / RD=POR+強制OFF+PWR_OFF        ││
  │        └─ FF_Q ─┬─> MP1584 の EN (3.3V 直結)                  ││
  │                 └─> LED_PWR のスイッチ                        ││
  │                                                              ││
  │   MP1584 降圧 <──SW_VIN── PACK_P ────────────────────────────┘│
  │        └──> V5V (5V / 3A)                                     │
  └────────┬──────────────────────┬──────────────────────────────┘
           │ V5V + GND            │ VETO / PWR_OFF (2 本・§4.2)
           v                      ^
  ┌──────────────────────────────────────────────────────────────┐
  │  B2  core 基板                                                │
  │    M5 AtomS3R ── GPIO01-05 ──> WS2812 5 系統                  │
  │        │       ── GPIO06 ────> スピーカ                       │
  │        │       ── I2C ───┬──> BNO055 (0x28/0x29)              │
  │        │                 └──> PCA9632 (0x62) ──> VETO/PWR_OFF │
  │        └── 3V3 ──> BNO055 / PCA9632 の電源                    │
  └────────┬──────────────────────────────────────────────────────┘
           │ 5 データ系統 + 5V + GND
           v
  ┌──────────────────────────────────────────────────────────────┐
  │  B3 赤道マザーリング (パッドのみ) ── B4 inner_deck ×10 (ポゴ6)  │
  │                            └── B6 FPC ×10 ── WS2812 × 800    │
  └──────────────────────────────────────────────────────────────┘
```

---

## 3. 電源ドメイン

| ドメイン | 電圧 | 生成元 | 供給先 | 電源 OFF 中 |
| --- | --- | --- | --- | --- |
| `PACK_P` | 6.0〜8.4 V | 2S LiPo → BMS 後 | IP2326 / MP1584 / LDO | **生きている** |
| **`V3P3`** | **3.3 V** | **HT7333-1 LDO (Iq 2.5 µA)** | ホール素子 / D-FF / プルアップ | **生きている (常時オン)** |
| `V5V` | 5 V / 最大 3 A | MP1584 (**EN 制御**) | B2 core 基板 / WS2812 × 800 | **停止** |
| AtomS3R の `3V3` | 3.3 V | AtomS3R 内部 LDO | BNO055 / **PCA9632** | **停止** (V5V 由来) |
| `LED_VCC` | 3.3 V | `V3P3` を `VETO` でゲート | 北極の LED 2 灯 | 点灯可 (充電表示) |

### オフ時電流の内訳 (設計見込み)

| 要因 | 電流 |
| --- | --- |
| MP1584 シャットダウン | 12 µA typ / 20 µA max |
| HT7333-1 LDO | 2.5 µA |
| ホール素子 (間欠動作) | 1.6〜4.0 µA |
| D-FF (LVC 静的) | ~1 µA |
| IP2326 スタンバイ | 0.7 µA |
| **PCA9632 未通電時のプルアップリーク** | **3.3〜33 µA — プルアップ値次第。§5.5 破れ ② で決着が必要** |
| **合計** | **typ 21〜23 µA / max は §5.5 の決着に依存 (41〜74 µA)** |

⚠️ **`FF_RD` のプルアップを 100 kΩ にすると max が 70 µA 級になり目標 ≤50 µA を超える。**
**§5.5 破れ ② を解決しないと予算が閉じない。**

⚠️ **D-FF / Schmitt は Nexperia 品を選ぶ** — TI の `SN74LVC1G74` は **ICC max 10 µA** で、
2 個使うと max だけで 20 µA を占める ([`docs/06`](06-power-switch.md) §5)。

⚠️ **`V3P3` が常時オンであることが設計の土台。** これがあるから電源 OFF 中でも
ホール素子と D-FF が生きており、磁石をかざした瞬間に反応できる。

---

## 4. ボード間インターフェース

### 4.1 B1 電源基板 ↔ B5 北極キャリア基板 — 6 本

[`docs/08`](08-north-status-window.md) §4.2 が正。**北極 pillar の Φ3 mm 通路**を通す (AWG30 級)。

| # | 信号 | 方向 | 備考 |
| --- | --- | --- | --- |
| 1 | `V3P3` | B1 → B5 | **ホール素子専用。veto の影響を受けてはならない** |
| 2 | `GND` | — | — |
| 3 | `HALL_OUT` | B5 → B1 | D-FF の CLK。**ツイスト + RC ローパス必須** (WS2812 データ 5 本の近傍を通る) |
| 4 | `LED_VCC` | B1 → B5 | veto でゲートされた LED アノード共通 |
| 5 | `STAT_PWR_K` | B5 → B1 | 電源 ON LED カソード戻り |
| 6 | `STAT_CHG_K` | B5 → B1 | 充電 LED カソード戻り → IP2326 pin 6 |

### 4.2 B1 電源基板 ↔ B3 mother-ring — **既存コネクタのみで完結**

<confirmed>
**PCA9632 は B3 (mother-ring) に載る** (2026-08-11 ユーザー決定・§0.6)。
`SDA` / `SCL` / `+3V3` が ring 上でローカルに揃うため、**I2C の基板間配線が不要**になる。
`VETO` / `PWR_OFF` は **`J7` の未使用ピン 2 本を転用**して電源基板へ渡す。
**新規コネクタはゼロ。**
</confirmed>

| コネクタ | ピン | 現状 | **改版後** |
| --- | --- | --- | --- |
| `J6` POWER-01 | 1 / 6 | GND | GND |
| | 2 / 3 | `+5V` | `+5V` (据置) |
| | **4 / 5** | **`5V-ALWAYS`** | **`SDA` / `SCL`** (§0.6 判断 3 改訂。電源基板側の残量測定用に I2C を引き込む) |
| `J7` POWER-02 | 1 / 4 | GND | GND |
| | 2 / 3 | `CHARGE` | `CHARGE` (据置。充電入力 ~1.83 A のため 2 ピン) |
| | **5** | **`BM` (未使用)** | **`VETO`** (オープンドレイン) |
| | **6** | **`P+` (未使用)** | **`PWR_OFF`** (オープンドレイン) |

- `VETO` / `PWR_OFF` は **B3 → B1** 方向。**電源基板側で `V3P3` へプルアップ** (1 MΩ / §5.5)
- **オープンドレインで基板間を渡すのは好都合**: アサート時は低インピーダンスで GND へ引き、
  非アサート時は受け側のプルアップが決めるので、**線が長くてもレベルが曖昧にならない**
- ⚠️ `J14 BATTERY` (ring 側) の `BM` / `P+` は**行き先を失う**。ring 改版時に
  `J14` 自体を削除するか、電源基板へ繋がない端子として残すかを決める (§6 Q6)

**オープンドレインで基板間を渡すのは好都合**: アサート時は低インピーダンスで GND へ引き、
非アサート時は受け側のプルアップが決めるので、**線が長くてもレベルが曖昧にならない。**

⚠️ **B2 が未通電のとき (= 電源 OFF 中)、この 2 本のプルアップ電流が
PCA9632 の ESD ダイオード経由で流れ込む。** プルアップを大きくして
**合計 約 10 µA に抑える設計** ([`docs/08`](08-north-status-window.md) §4.4b)。
**基板間配線になったことで経路は長くなるが、リーク量は変わらない。**

### 4.3 B2 core 基板 ↔ B3 マザーリング

| 信号 | 内容 |
| --- | --- |
| WS2812 データ × 5 | AtomS3R の GPIO01〜05。各系統が 160 LED (北 80 + 南 80) を駆動 |
| 5V / GND | 各カセット 6 パッド `5V-GND-DIN-DOUT-GND-5V` (回文) へ分配 |

`N_DOUT → S_DIN` のクロスはマザーリング側で行う (親 `CLAUDE.md` §2.6)。

### 4.4 B1 のコネクタ (現状の確定分)

| コネクタ | 内容 | 状態 |
| --- | --- | --- |
| `CN5` (VOUT 6p) | 5V 出力側 | **基板左右端・同一 Y・対向配置で確定**。ピン定義は §6 Q3 |
| `CN6` (VIN 6p) | 電池 / BMS 側 | 同上 |
| 充電入力 | 南極磁気端子から AWG26 × 2 | — |
| BMS 戻り | B+/BM/B−/P+/P− の 5 線 | — |
| 北極 | 6 本 (§4.1) | **新設** |
| core 基板 | `VETO` / `PWR_OFF` (+ 電力) | **新設** |

---

## 5. 電源 ON/OFF の全体シーケンス

| # | きっかけ | 起きること |
| --- | --- | --- |
| 1 | 電池挿入 | D-FF が POR でクリア → `Q`=L → MP1584 の EN=L → **OFF** |
| 2 | **北極に磁石をかざす** | ホール素子 → D-FF の CLK → トグル → `Q`=H → **EN 解放 → 5V 起動** |
| 3 | 同時に | `Q` が LED_PWR を点灯 → **AtomS3R の起動を待たずに窓が光る** |
| 4 | AtomS3R 起動 | PCA9632 は power-up 時 出力オフ → **窓は点灯のまま (boot-safe)** |
| 5 | 再生開始 | firmware が PCA9632 ch0 をシンク → `VETO` → **2 灯とも消灯** |
| 6a | もう一度かざす | D-FF トグル → `Q`=L → **5V 崩壊 → OFF** |
| 6b | firmware が電源断 | PCA9632 ch1 をシンク → `PWR_OFF` → D-FF の CLR → **OFF** |
| 7 | 充電端子を装着 | D-FF の PRE (SET) → `Q`=H → **強制 ON** (消灯中でも点く) |
| 8 | 電源 OFF のまま充電 | IP2326 が独立動作。`LED_VCC` は生きているので **充電 LED だけ点く** |

---

## 5.5 ⚠️ サブ doc 間の整合性の破れ 2 件 (2026-08-11 検出)

<impact>
[`docs/06`](06-power-switch.md) の全面改訂版と [`docs/08`](08-north-status-window.md) が
**別々に更新された結果、2 箇所で食い違っている。着手前に決着させること。**

### ✅ 破れ ① — **解決済み (2026-08-11): 6 極で確定。docs/06 の `CN7` を 6 極に改める**

以下は判断の経緯として残す。

#### 破れ ① 北極コネクタが 5 極 (docs/06) vs 6 本 (docs/08)

| doc | 内容 |
| --- | --- |
| [`docs/06`](06-power-switch.md) §4.9 | `CN7` = **5 極** (`V3P3` / `GND` / `HALL_OUT` / `STAT_PWR_K` / `STAT_CHG_K`)。§4.2 で **`V3P3` が「北極 LED アノードの電源」** と定義されている |
| [`docs/08`](08-north-status-window.md) §4.2 | **6 本**。LED アノードは **`LED_VCC` (= `V3P3` を `VETO` でゲートしたもの)** |

**原因**: ユーザー確定「**動画再生中は電源 ON / 充電の 2 灯とも消灯**」を満たすには、
充電 LED も切れる必要がある。充電 LED は IP2326 pin 6 が駆動するため、
**アノード側のレールを切る以外に 2 灯を一括で消す方法がない** → `LED_VCC` が必要になり線が 1 本増える。

**提案する決着**: **docs/08 側 (6 本 + `LED_VCC`) を採用し、docs/06 の `CN7` を 6 極に改める。**
`V3P3` は**ホール素子専用**にしないと、veto 中にホール素子が止まり
**再生中に磁石をかざしても電源が切れなくなる** (docs/08 §4.2 の警告)。

### 破れ ② `FF_RD` のプルアップ値が オフ時電流の予算を壊す

| doc | 内容 |
| --- | --- |
| [`docs/06`](06-power-switch.md) §4.7 | `R5` = **100 kΩ** (V3P3 → RD) + `C6` = 100 nF で POR (τ = 10 ms) |
| [`docs/08`](08-north-status-window.md) §4.4b | PCA9632 (core 基板・**ON ドメイン**) が `FF_RD` をシンクして `PWR_OFF` |

**問題**: 電源 OFF 中は PCA9632 が未通電になる。`R5` = 100 kΩ だと
**3.3 V / 100 kΩ = 33 µA** が PCA9632 の ESD ダイオード経由で流れ込み、
docs/06 §5 の max 38〜41 µA に上乗せされて **70 µA 級 = 目標 ≤50 µA を大幅超過**する。

**提案する決着 (どちらか)**:

1. **POR の定数を `R5` = 1 MΩ / `C6` = 10 nF に変更する** (τ = 10 ms は不変)。
   リークが **3.3 µA** に下がり、合計 **41〜44 µA max** で予算内に収まる。
   ⚠️ 1 MΩ プルアップ + LVC の入力リーク ±1 µA max → 最悪 H レベル 2.3 V。
   **VIH 2.0 V は満たすが余裕は薄い** ので、入力リークの小さい Nexperia 品で確認する
2. **PCA9632 の出力を N-MOS 1 石で受ける** (docs/08 §4.4 ② の topology)。
   未通電時はゲートが pulldown で固定されリーク経路が消えるので、
   **`R5` = 100 kΩ をそのまま維持できる**。部品 +2 点

**推奨は 1 → 駄目なら 2。** どちらも「PCA9632 が未通電のときに常時オン側から
電流が流れ込まないこと」という同じ要件への対処である。

#### 補足 (2026-08-11): PCA9632 が ring 実装になっても**リーク量は変わらない**

`VETO` / `PWR_OFF` のプルアップは**受け側 (電源基板) の常時オン `V3P3`** に付くので、
PCA9632 がどの基板にあっても「未通電の IC の ESD ダイオードへ流れ込む」構図は同じ。
**基板間配線になった分だけ経路が長くなるだけで、電流は変わらない。**

⚠️ **プルアップを ON ドメイン側に付け替えて回避することはできない**:

- `FF_RD` のプルアップを ON ドメインにすると、**電源 OFF 中に RD が確定せず
  D-FF がリセット状態に張り付き、磁石をかざしても ON にできない** (致命的)
- `LED_VCC` スイッチのゲートを ON ドメインにすると、**電源 OFF 中に充電 LED が点かない**
  (「消灯のまま充電できることが見える」要件を壊す)

**したがって両方のプルアップは常時オン `V3P3` に付けるしかなく、リーク対策は
「1 MΩ にする」か「N-MOS で受ける」の二択に限られる。**
</impact>

## 6. Open questions / 未確定事項

<open_questions>
- ~~**Q1: core 基板 (B2) の正体**~~ → **✅ 解決 (2026-08-11)**: 親リポジトリ
  `kiban/resized/core-M5atom-FPC` の KiCad プロジェクト。ネットリスト解析結果は §0.5
- ~~**Q2: `V5V` の分配経路**~~ → **✅ 解決 (2026-08-11)**:
  **B1 → `J6` → B3 mother-ring → `J1`〜`J5` (各カセット) と `J8` (→ B2 core 基板)**。
  ring 上で `FB1` フェライトビーズを介して `ESP-VIN` として core へ分岐している。
  **銅箔幅は `J6` の `+5V` 2 ピンと ring 上の分配経路で決まる** — 3 A の裏取りは要実施
- **Q6 (NEW): ring `J14 BATTERY` の扱い。** `J7.5`/`J7.6` を転用すると
  `BM` / `P+` の行き先が無くなる。`J14` を削除するか、未接続端子として残すか
- **Q7 (NEW): `V3P3-ALWAYS` の電流予算。** 供給元は HT7333-1 (250 mA) で
  現時点の ring 側負荷はゼロ。**将来何を繋ぐかで LDO の余裕とオフ時電流が変わる**
- **Q3: `CN5` / `CN6` のピン定義。** 配置 (左右端・同一 Y・対向) は確定だが、
  ピンアサインは未確定 ([`docs/01`](01-legacy-analysis.md) §4)。**CN5/CN6 はユーザー担当**
- **Q4: スピーカの回路構成。** [`docs/08`](08-north-status-window.md) §4.4a の
  フォールバック (GPIO06 共用) を使う場合、アンプの有無とタップ位置の確定が必要
- **Q5: B2 に PCA9632 を載せる責任分界。** B2 は別プロジェクトなので、
  **PCA9632 の実装・I2C アドレス・ch 割り当てを B2 側の仕様として合意する必要がある**
</open_questions>

---

## 7. References

- [`CLAUDE.md`](../CLAUDE.md) — 本プロジェクトの確定仕様
- [`docs/06`](06-power-switch.md) — 電源 ON/OFF 回路 (**要全面改訂**)
- [`docs/08`](08-north-status-window.md) — 北極ステータス窓の作業指示書
- [`docs/01`](01-legacy-analysis.md) §3 / §4 — ネット名の ASCII 規約とコネクタ
- 親リポジトリ `CLAUDE.md` §2.6 / §2.7 / §2.8 — 赤道接続・BOM・極部 (**正本**)
