sastles-com/power-2S-02/docs/10-ring-core-revision.md

# 10 — mother-ring / core 基板 改版指示書 (Change Order)

<subproject>
- name: ring-core-revision
- parent: power-2s-02
- status: **draft — 改版指示。2026-08-11 のユーザー決定に基づく**
- created: 2026-08-11
- depends_on: [09-system-structure, 08-north-status-window, 06-power-switch]
- 対象: 親リポジトリ `kiban/resized/mother-ring` / `kiban/resized/core-M5atom-FPC`
</subproject>

> **この doc の位置づけ**: 電源基板 (power-2S-02) 側の設計決定によって
> **mother-ring と core 基板に必要になる変更だけ**を抜き出した指示書。
> 変更の背景と全体構造は [`docs/09`](09-system-structure.md) を参照。
> 現状のネットリストは [`docs/09`](09-system-structure.md) §0.5 に実測値として記録済み。

---

## 0. 結論のサマリ

| 基板 | 物理変更 | 規模 |
| --- | --- | --- |
| **mother-ring** | **必要** — 部品 2 点追加 + ネット 4 本の再定義 + 配線変更 | **中** (回路図 + PCB 再配線) |
| **core-M5atom-FPC** | **不要** — ネット名の整合のみ | **極小** (物理変更ゼロ) |

**PCA9632 を mother-ring に置く判断により、core 基板は一切改造せずに済む。**

---

## 1. mother-ring の変更

### 1.1 部品追加 — 2 点

| Ref | 部品 | LCSC | パッケージ | 面積 |
| --- | --- | --- | --- | --- |
| `U1` (仮) | **PCA9632DP1,118** (I2C 4ch LED ドライバ) | **`C2802665`** | TSSOP-8 (3.0×3.0, リード span 4.9) | 14.7 mm² |
| `C13` (仮) | セラコン 100 nF / 0603 | `C14663` 等 | 0603 | 2.5 mm² |

- **I2C プルアップは追加しない** — AE-BNO055 基板に実装済み ([`docs/09`](09-system-structure.md) §0.5)

### 1.2 推奨配置

実測した空き領域 ([`docs/09`](09-system-structure.md) §0.5):

| 角度範囲 | 幅 | 備考 |
| --- | --- | --- |
| **88°〜121°** | 33° | **`J16`(I2C, 87.7°) と `J13`(3V3, 121.5°) の間 → 推奨** |
| 167°〜208° | 41° | — |
| 216°〜285° | 69° | 最大 |
| 288°〜335° | 47° | — |

**推奨は 88°〜121° の扇形 (半径 24〜38 mm)。** `SDA` / `SCL` / `+3V3` の 3 本が
すぐ隣の `J16` / `J13` にあるため配線が最短になる。40° の扇形で **約 400 mm²** あり、
必要な 17 mm² に対して 20 倍以上の余裕がある。

### 1.3 PCA9632 の結線

| ピン | 名前 | 接続先 | 備考 |
| --- | --- | --- | --- |
| 1 | `LED0` | **`VETO`** → `J7.5` | オープンドレイン。**電源基板側で `V3P3` へ 1 MΩ プルアップ** |
| 2 | `LED1` | **`PWR_OFF`** → `J7.6` | 同上。D-FF の `RD` を引く |
| 3 | `LED2` | 予備 | テストパッド or NC |
| 4 | `LED3` | 予備 | テストパッド or NC |
| 5 | `VSS` | `GND` | — |
| 6 | `SCL` | 既存 `SCL` ネット | ローカル配線 |
| 7 | `SDA` | 既存 `SDA` ネット | ローカル配線 |
| 8 | `VDD` | **`+3V3`** (= AtomS3R 由来) | ⚠️ **`V3P3-ALWAYS` に繋いではならない** (§1.6) |

`C13` (100 nF) は **pin 8 (`VDD`) と pin 5 (`VSS`) の間に、IC の直近に**置く。

⚠️ **I2C アドレスは 0x62 固定** (8 ピン版)。BNO055 (0x28 / 0x29) と衝突しない。

### 1.4 `J7` POWER-02 のピン再定義

| ピン | 現状 | **改版後** | 理由 |
| --- | --- | --- | --- |
| 1 | `GND` | `GND` | 据置 |
| 2 | `CHARGE` | `CHARGE` | 据置 (充電入力 ~1.83 A のため 2 ピン並列) |
| 3 | `CHARGE` | `CHARGE` | 据置 |
| 4 | `GND` | `GND` | 据置 |
| **5** | **`BM`** | **`VETO`** | BM は未使用 (電池と BMS は電源基板へ直接ワイヤ接続) |
| **6** | **`P+`** | **`PWR_OFF`** | P+ も同様に未使用 |

**作業**: `J7.5` → `J14.2` および `J7.6` → `J14.3` の配線を削除し、
`J7.5` を PCA9632 `LED0`、`J7.6` を `LED1` へ接続する。

### 1.5 `J6` POWER-01 のネット再定義 — **`SDA`/`SCL` に振り替え (2026-08-11 再決定)**

| ピン | 現状 | **改版後** |
| --- | --- | --- |
| 1 / 6 | `GND` | 据置 |
| 2 / 3 | `+5V` | 据置 |
| **4 / 5** | **`5V-ALWAYS`** | **`SDA` / `SCL`** |

**経緯**: 当初は `V3P3-ALWAYS` (常時オン 3.3 V) に振り替える案だったが、
**負荷がゼロのまま**であることと、**電源基板側で LiPo 残量測定に I2C が必要**になったため、
**実需のある I2C に振り替える**ことで決着した。

**作業**: `5V-ALWAYS` ネットを**削除**し、`J6.4` / `J6.5` を**既存の `SDA` / `SCL` ネットに接続**する
(I2C はバスなので、`J8` / `J16` と同じネットに並列でぶら下げるだけ)。

- **`V3P3-ALWAYS` は新設しない** → ⚠️ **これにより「3.3 V が 2 系統できる」危険が消滅した**
- **`J12`** (2 ピン、旧 `5V-ALWAYS` 引き出し) は**行き先を失う**。削除するか未接続で残すかを決定 (§4 Q6)

#### 💡 推奨: `J6` のピン順を見直して I2C を GND で挟む

`J6` は **+5V を最大 3 A** 流すケーブルでもある。I2C (100〜400 kHz) と同居させるので、
**シールドのため `SDA`/`SCL` の隣を `GND` にする**のが望ましい。

| 案 | 1 | 2 | 3 | 4 | 5 | 6 | 評価 |
| --- | --- | --- | --- | --- | --- | --- | --- |
| そのまま | GND | +5V | +5V | **SDA** | **SCL** | GND | SCL は GND 隣接 ✓ / **SDA は +5V 隣接** ✗ |
| **推奨** | GND | +5V | +5V | **GND** | **SDA** | **SCL** | **SDA が GND 隣接** ✓ / GND は 2 ピン維持 ✓ |

⚠️ 推奨案でも **GND は 2 ピン (1, 4)** を確保できるので、3 A の帰路電流は 1.5 A/ピンで問題ない。

### 1.6 ✅ 解消済み: 「3.3 V が 2 系統」問題

| ネット | 供給元 | ドメイン | 用途 |
| --- | --- | --- | --- |
| **`+3V3`** (既存) | **M5AtomS3R の 3V3 ピン** (`J4.1`→`J16.6`→`J8.6`) | **ON ドメイン** (AtomS3R と一緒に落ちる) | **PCA9632 の VDD** / I2C の基準 |
| **`V3P3-ALWAYS`** (新規) | **電源基板の HT7333-1** (`J6.4`/`J6.5`) | **常時オン** | 将来の常時給電用 (現時点で負荷なし) |

**この 2 本を接続すると 2 つの故障が起きる:**

1. **常時オン側が AtomS3R の内部レギュレータ出力を逆給電する** → 電源 OFF 中も
   AtomS3R が中途半端に通電し、リーク増加と不定動作を招く
2. **PCA9632 のレジスタが電源 OFF でリセットされなくなる** → 前回の `VETO` 状態が残り、
   **次回起動時にステータス窓が点かない**。PCA9632 は**リセットピンを持たずソフトウェア
   リセットのみ**なので、電源を落とすことが唯一の確実な初期化手段である

**対策 (必須)**: **`+3V3` を `V3P3_SW` にリネーム**し、名前だけで
「常時オンか否か」が判別できるようにする。`V3P3_SW` / `V3P3-ALWAYS` の対比なら取り違えない。

### 1.7 `J14` / `J17` — **外部ジャンパ用のハンダパッド (2026-08-11 確定)**

旧 `J14 BATTERY` は削除ではなく、**`J17` とペアで「基板内の横断配線を外部線で代替する」ための
ハンダパッド**に転用する。**ユーザー決定: コネクタは使わず、線を直接ハンダ付けする。**

#### 実装の背景 (実測)

| 部品 | 座標 | 半径 | 角度 |
| --- | --- | --- | --- |
| `U1` PCA9632 | (−11.60, −37.20) | 39.0 mm | **107.3°** |
| `J17` | (−7.10, −28.10) | 29.0 mm | 104.2° |
| `J14` | (31.20, −9.60) | 32.6 mm | **17.1°** |
| `J7` POWER-02 | (22.86, −6.35) | 23.7 mm | 15.5° |

`U1` と `J7` は **角度で約 87°、円弧長で約 45 mm 離れている**。ドーナツ基板の内周は
5V 分配と pogo パッドで混雑しているため、**この横断だけ外部線に逃がす**。

| 区間 | 距離 | 手段 |
| --- | --- | --- |
| `U1.1` → `J17.1` | 11.6 mm | 銅箔 |
| `U1.2` → `J17.2` | 9.9 mm | 銅箔 |
| **`J17` ↔ `J14`** | **42.5 mm** | **外部線・直ハンダ × 2 本** |
| `J14.1` → `J7.5` | 15.8 mm | 銅箔 |
| `J14.2` → `J7.6` | 17.0 mm | 銅箔 |

#### ⚠️ 必須 ①: ネットを 2 本に分割する

外部線での接続は KiCad が知り得ないため、**4 点を同一ネットにしたままだと
DRC が「未接続」を恒久的に報告する**。例外登録で抑えると本当の未配線を見逃す。

| ネット名 | 接続 | 意味 |
| --- | --- | --- |
| `VETO` | `U1.1` + `J17.1` | PCA9632 → 外部線の出口 |
| **`VETO-EXT`** (新設) | `J14.1` + `J7.5` | 外部線の入口 → 電源基板 |
| `PWR_OFF` | `U1.2` + `J17.2` | 同 |
| **`PWR_OFF-EXT`** (新設) | `J14.2` + `J7.6` | 同 |

**どちらも 2 ピンの正当なネットになるので ERC / DRC がクリーンになる。**
回路図に注記を入れること: 「`J17` ↔ `J14` は外部線を直ハンダで接続 (基板内横断を回避)」

#### ⚠️ 必須 ②: 受け側にノイズフィルタを入れる (電源基板)

`VETO` / `PWR_OFF` は **オープンドレイン + 1 MΩ プルアップ = 高インピーダンスノード**。
そこへ **42.5 mm の裸線**を、**WS2812 のデータ線 5 本 (800 kbps) が走る球体内部**に通す。

**`PWR_OFF` が誤アサートされると再生中に電源が落ちる。** 実害が大きいので対策必須。

| 対策 | 値 | 効果 |
| --- | --- | --- |
| **受け側 (電源基板) に対 GND のフィルタ容量** | **1 nF × 2** | `1 MΩ × 1 nF = 1 ms` の時定数。両信号とも ms オーダーで十分間に合う |
| 線の処理 | **2 本をツイスト**し、WS2812 データ線から離す | 誘導結合を抑える |

⚠️ **プルアップを下げて低インピーダンス化するのは不可** — 1 MΩ にしているのは
未通電時のリークを 3.3 µA に抑えるためで、下げるとオフ時電流の予算が壊れる
([`docs/09`](09-system-structure.md) §5.5 破れ ②)。**容量で対処する。**

#### フットプリントの扱い

`J14` / `J17` は現状 `PinHeader_1x02_P2.54mm_Vertical`。**THT パッドなので線の直ハンダに使える**が、
**部品としては実装しない**ので:

- **BOM から除外** / **実装位置ファイル (position) から除外** する
  (JLCPCB がピンヘッダを載せようとしないように)
- シルクに `SOLDER` / `WIRE` 等を表記し、コネクタではないことを明示する

### 1.8 mother-ring 変更チェックリスト

- [ ] PCA9632DP1 (`C2802665`) を 88°〜121° の扇形・半径 24〜38 mm に配置
- [ ] 100 nF (0603) を PCA9632 の `VDD`–`VSS` 直近に配置
- [ ] `SDA` / `SCL` を PCA9632 の pin 7 / pin 6 へローカル配線
- [ ] PCA9632 `VDD` を **`+3V3` (AtomS3R 由来)** へ接続 — **`V3P3-ALWAYS` ではない**
- [x] `J7.5` → `J14.2` / `J7.6` → `J14.3` の旧配線を削除 (`BM` / `P+` ネットが消滅) ✅ 2026-08-11
- [x] `J7.5` = `VETO` / `J7.6` = `PWR_OFF` として PCA9632 `LED0` / `LED1` へ接続 ✅
- [ ] **`5V-ALWAYS` ネットを削除し、`J6.4`/`J6.5` を既存 `SDA`/`SCL` に接続** (§1.5 再決定)
      ⚠️ 一度 `V3P3-ALWAYS` にリネーム済みなので**やり直しになる**
- [ ] `J6` のピン順を推奨案 (1=GND / 2,3=+5V / 4=GND / 5=SDA / 6=SCL) に見直すか決定
- [x] **`+3V3` → `V3P3-SW` にリネーム** ✅ (§1.6 の取り違え防止)
- [x] `U1.8` / `C13.1` を `V3P3-SW` に接続 ✅ **一度 `V3P3_SW` (アンダースコア) で別ネットになり
      PCA9632 の VDD が浮いていたが修正済み。ハイフン / アンダースコアの混在は事故要因**
- [ ] **`J14` / `J17` のネットを 4 本に分割** (`VETO` / `VETO-EXT` / `PWR_OFF` / `PWR_OFF-EXT`) — §1.7 必須 ①
- [ ] **`J14` / `J17` を BOM と position から除外** (コネクタを実装しない) — §1.7
- [ ] `LED2` / `LED3` (予備 2ch) に **`NC` フラグ**を付与 (ERC 警告の解消)
- [ ] **PCB の配線**: 現状 **segment 0 本 = 全ネット未配線** (zone 2 枚のみ)。§1.7 の 4 区間を引く
- [ ] ERC / DRC クリーン
- [ ] **`V3P3-SW` と `V3P3-ALWAYS` が短絡していないことを目視 + DRC で確認**

---

## 2. core-M5atom-FPC の変更 — **物理変更は不要**

<confirmed>
**PCA9632 を mother-ring に置いた結果、core 基板の回路・PCB は一切変更不要。**
必要なのはネット名の整合だけ。
</confirmed>

### 2.1 変更が不要である根拠

| 検討項目 | 結論 |
| --- | --- |
| I2C の引き回し | `SDA`/`SCL` は既に `J16.3`/`J16.4` から ring へ出ている → **追加不要** |
| PCA9632 の電源 | `+3V3` は既に `J16.6` から ring へ出ている → **追加不要** |
| GPIO の追い出し | **GPIO06 (スピーカ) は使わない判断** → `R1` (0 Ω) もそのまま → **変更不要** |
| WS2812 | `GPIO01〜05` → `J17` の既存経路をそのまま使う → **変更不要** |

### 2.2 やること — 名前の整合のみ

- [ ] `+3V3` → **`V3P3_SW`** にリネーム (mother-ring 側 §1.6 と一致させる)
      — **ハーネスで繋がる同一ネットなので、両基板で名前を揃えないと事故要因になる**

### 2.3 参考: 現状のまま残るもの (変更しないことの確認)

| Ref | 内容 | 扱い |
| --- | --- | --- |
| `LS1` SPEAKER (PKLCS1212) | `GPIO06 → R1(0Ω) → C7(0.1µF) → LS1` | **そのまま維持。スピーカ機能は失わない** |
| `R1` 0 Ω | 事実上のジャンパ | **外さない** (GPIO06 は VETO に転用しない) |
| `U1` AE-BNO055 | I2C 0x28/0x29、**プルアップ内蔵** | そのまま。PCA9632 (0x62) と非衝突 |
| `J9` / `J10` I2C (Grove 4p) | SDA/SCL/+5V/GND | そのまま (拡張用) |

---

## 3. 電源基板 (power-2S-02) 側の対応 — 参考

この改版と対になる電源基板側の作業。詳細は [`docs/06`](06-power-switch.md) / [`docs/08`](08-north-status-window.md)。

- `J7.5` / `J7.6` から `VETO` / `PWR_OFF` を受け、**`V3P3` へ 1 MΩ でプルアップ**
- **各信号に対 GND の 1 nF を追加** — ring 側で 42.5 mm の外部線を通るため
  (§1.7 必須 ②)。`1 MΩ × 1 nF = 1 ms` で、誤アサートによる意図しない電源断を防ぐ
- `J6.4` / `J6.5` へ **常時オン 3.3 V (`V3P3-ALWAYS`) を出力**
- **`CN7` を 6 極**に (`V3P3`/`GND`/`HALL_OUT`/`LED_VCC`/`STAT_PWR_K`/`STAT_CHG_K`)
- **`FF_RD` の POR を 1 MΩ + 10 nF に変更** (τ = 10 ms 不変。100 kΩ だとリーク 33 µA で
  オフ時電流の予算を超える — [`docs/09`](09-system-structure.md) §5.5 破れ ②)

---

## 4. Open questions

<open_questions>
- **Q1: AtomS3R の `3V3` ピンの供給能力。** PCA9632 の IDD (動作時) を足せるか。
  **PCA9632 のデータシート照合が未完** ([`docs/08`](08-north-status-window.md) §7 V13)
- **Q2: `J14 BATTERY` を削除するか** (§1.7)
- **Q3: PCA9632 の予備 2ch (`LED2`/`LED3`) をテストパッドに出すか**
- **Q4: `V3P3-ALWAYS` に将来何を繋ぐか** — 現時点で負荷ゼロ。
  HT7333-1 は 250 mA なので余裕はあるが、**繋いだ分はオフ時電流に直接乗る**
- **Q5: mother-ring は既に製造済みか。** `production/` に bom.csv / positions.csv が
  生成されているため、発注済みなら改版のコストが変わる
</open_questions>

## 5. References

- [`docs/09`](09-system-structure.md) — システム構造・実基板のネットリスト解析 (§0.5) と設計判断 (§0.6)
- [`docs/08`](08-north-status-window.md) — 北極ステータス窓 (`VETO` / `PWR_OFF` の意味と回路)
- [`docs/06`](06-power-switch.md) — 電源 ON/OFF 回路 (D-FF / `FF_RD` / EN 制御)
- 親リポジトリ `kiban/resized/mother-ring` / `kiban/resized/core-M5atom-FPC` — 改版対象
