sastles-com/power-2S-02/docs/04-layout-thermal.md

# 04 — 40×40 / 4 層レイアウト・ベタ GND・排熱設計

<subproject>
- name: layout-thermal
- parent: power-2s-02
- status: draft
- depends_on: [02-ip2326-module, 03-mp1584-module, 06-power-switch]
</subproject>

## Scope

新基板 (40×40 mm, 4 層) の層構成・ゾーニング・ベタ GND・排熱・大電流パスの設計方針。

## 1. 基板仕様 (確定)

| 項目 | 値 |
| --- | --- |
| 外形 | **40 × 40 mm** |
| 層数 | **4 層** |
| **取付穴** | **四隅に M2 (Φ2.2) × 4** |
| **実装面** | **片面実装 (Top のみ)** — Bottom 全面をベタ GND 放熱面にできる。PCBA コストも安い |
| 板厚 | 1.6 mm |
| 銅箔厚 | 外層 1 oz (JLCPCB 標準)。電流計算で不足なら 2 oz を検討 (§7 Q1) |
| 表面処理 | 発注時決定 ([`docs/05`](05-jlcpcb-fab.md)) |

## 2. 層構成 (stackup)

| 層 | 割当 |
| --- | --- |
| L1 (Top) | **全部品** + 大電流パス (充電昇圧ループ / 降圧ループ) |
| L2 | **GND ベタ (切れ目なし厳守)** — スイッチングループのリターン & シールド |
| L3 | 電源プレーン (P+ / VOUT / CHARGE を分割配置) + 補助配線 |
| L4 (Bottom) | **ベタ GND + 放熱銅箔** (部品なし) |

原則:

- **L2 の GND は絶対に分断しない**。スイッチングノード直下も L2 GND で受ける
- 部品は Top のみ。Bottom は放熱と GND リターンに専念させる

## 3. ゾーニング (配置案)

```text
        +--------------------------------------+
        | ○                                  ○ |  ← 四隅 M2 穴
        |  [充電入力]   [IP2326]               |  ← 充電昇圧ゾーン (発熱源1)
        |     D1   L(2.2µH)  Cin/Cout          |
   CN5  |--------------------------------------|  CN6
  VOUT ═|  [セル×2 / BMS 戻り]   BM ライン      |═ VIN   ← 左右端・同一 Y・対向 (§3.1)
   6p   |--------------------------------------|  6p
        |  [MP1584] L(4.7µH) SS34  Cin/Cout    |  ← 降圧ゾーン (発熱源2)
        |  [ラッチ回路 + LED]                   |  ← 小信号
        | ○                                  ○ |
        +--------------------------------------+
```

### 3.1 CN5 / CN6 の配置 (確定制約)

**CN5 (VOUT 6p 2.54mm) と CN6 (VIN 6p 2.54mm) は基板の左右端に、同一 Y・対向で配置する** (2026-08-10 決定)。

2P 版 PCB での実測値 (この配置を踏襲する):

| Ref | 役割 | X | Y | 回転 |
| --- | --- | --- | --- | --- |
| CN5 | VOUT_HDR (出力) | **−1.65 mm** (左端寄り) | **−19.79 mm** | −90° |
| CN6 | VIN_HDR (入力) | **+41.66 mm** (右端寄り) | **−19.56 mm** | −90° |

- 2P 版の基板外形は 46.86 × 40.00 mm (Board Outline 実測)。本基板は 40×40 なので **X 間隔は縮まる**が、
  **「左右端・同一 Y・同一回転で向かい合う」関係は維持する**
- 電流パスが入力→出力で基板を横断する直線になり、ハーネスの取り回しも左右対称になる
- 6p のうち複数ピンを電源に割り当てて電流容量を稼ぐ流儀 (legacy J7/J8、2P 版 CN5/CN6 と同じ) を踏襲

### 3.2 発熱源とブロック

#### ⚠️ 大型部品の実寸 (2026-08-11 BOM 確定、[`docs/05`](05-jlcpcb-fab.md) §2.1)

| 部品 | 実寸 | 影響 |
| --- | --- | --- |
| **降圧段 L (C36417 / SWPA8040S4R7NT)** | **8.0 × 8.0 mm** | **本基板で最大の部品**。40×40 の 4% を占める |
| 充電段 L (C36500 / SWPA6045S2R2NT) | 6.0 × 6.0 mm | 当初想定の CD43 (4.5×4.5) より大きい |
| 22 µF/25 V (C12891) | **1206 × 6 個** | 0805 の 22 µF は 16 V 品しか無いため 1206 で確定 |
| IP2326 (VQFN-24-EP) | 4.0 × 4.0 mm | — |
| MP1584 (SOIC-8-EP) | 4.9 × 3.9 mm | — |

インダクタ 2 個で **100 mm²**、1206 が 6 個で約 **40 mm²**。
片面実装 (Top のみ) なので、**この 2 種でゾーニングの自由度がほぼ決まる**。
小型化が必要になった場合の候補は [`docs/05`](05-jlcpcb-fab.md) §2.1 に記載 (要データシート確認)。

- 発熱源 2 つ (IP2326 / MP1584+ダイオード) を**基板の対辺に離す**
- 2 つのスイッチングループを近接させない (相互干渉回避)
- コネクタは外周縁に整列。**最小構成 (4〜5 個) に削減済み**なので面積は確保しやすい
- BM ライン (バランス、電流小) は細くてよいがパック電圧が乗るため沿面確保
- ラッチ回路は 2S 電圧で動く小信号なので、スイッチングノードから離して配置

## 4. 大電流パスの設計 (必ず計算で裏取り)

**電流値は 2026-08-10 に確定した** ([`docs/02`](02-ip2326-module.md) §3.1 / [`docs/03`](03-mp1584-module.md) §3.3)。

| パス | 確定電流 | 備考 |
| --- | --- | --- |
| 充電: CHARGE(5V) → IP2326 → L1 → B+(P+) | **入力側 1.83 A** / 出力側 1.0 A | 充電電流 1.0 A に決定 (~3 A 想定から下げた)。**律速は AWG26 の許容電流** |
| 放電: P+ → MP1584 → VOUT(5V) | 5V 側 **最大 3 A**、入力側 **~2.3 A** (VIN 7.4 V / 効率 89%) | 降圧なので入力電流は小 |
| **MP1584 の SW → L1 (ピークインダクタ電流)** | **3.44 A** | リップル 0.89 A を含むピーク値。電流制限 min 4.0 A |
| 5V 出力 → コネクタ | 最大 3 A | **直列 FET は無し** (EN 制御方式のため) |
| BM (バランス) ライン | **最大 34 mA** | 細くてよい ([`docs/02`](02-ip2326-module.md) §3.2) |

- トレース幅は IPC-2152 で温度上昇 ≤20 ℃ を目安に算出
- 3 A 級パスは **幅 ≥2 mm + ポリゴン** を基本、層間は **ビア多打ち** (Φ0.3 で ~1 A 目安 → 3 A なら 3〜4 個以上)
- **FB1 (legacy の 0603 フェライトビーズ) は定格電流不足の可能性が高い** — サイズアップ (1206/1812) か撤去を判断 (§7 Q2)

## 5. 排熱設計

**損失は 2026-08-10 に計算で確定した。**

| 発熱源 | 損失 | θJA | 温度上昇 | 備考 |
| --- | --- | --- | --- | --- |
| **IP2326** (充電中) | **~0.7 W** (効率 92%、8.4 W 出力時) | **60 °C/W** | **ΔT ~42 °C** | 熱シャットダウン 135 °C ([`docs/02`](02-ip2326-module.md) §4) |
| **MP1584** (3 A 放電時) | **1.16 W** (公称) / **1.28 W** (最悪、VIN 6.6 V の高デューティ側) | **50 °C/W** (4 層基板前提) | **ΔT 58〜64 °C** | 周囲 40 °C で Tj ≈ 104 °C、動作上限 125 °C。**余裕は大きくない** ([`docs/03`](03-mp1584-module.md) §3.8) |
| D1 (SS34 キャッチ) | 0.38 W | — | — | アノード側ランドを広げる |
| L1 (降圧側 DCR 30 mΩ) | 0.27 W | — | — | — |
| **最悪ケース: 充電しながら 3 A 点灯** | **合計 ~2.5 W** | — | — | 試作で実測する |

- **IP2326**: 露出パッド直下に **サーマルビア 3×3 (Φ0.3、ピッチ 1.0-1.2 mm)** → L2/L4 のベタ GND へ
- **MP1584EN**: 露出パッド (SOIC-8-EP) 直下に**サーマルビアのグリッド**。
  **データシート指定値: バレル径 15 mil (0.38 mm) / ピッチ 40 mil (1.0 mm)**
  ([`docs/03`](03-mp1584-module.md) §4)。
  ⚠️ **小径にする理由**: メッキで穴がほぼ埋まり熱伝導が上がる + リフローで半田が吸われる (solder wicking) のを防ぐ。
  **θJA 50 °C/W は「露出パッドを 4 層基板の GND プレーンに熱結合した」前提の値**なので、
  ここを手抜きすると §3.8 の温度計算が成立しない
- SS34 (SMA/SMB) はアノード側ランドを広げる
- 片面実装のため **Bottom 全面が放熱面として使える** — 発熱源の直下領域は銅箔をベタで確保
- Bottom のレジスト開口による放熱強化は、球体内での絶縁を優先して**行わない** (必要性が出たら再検討、§7 Q3)
- 密閉球体内で対流が期待できないため、**銅箔面積での拡散が主役**

## 6. EMC / ノイズ

- スイッチングループ (IP2326 昇圧 / MP1584 降圧) はそれぞれ**最小ループ面積**でまとめ、直下 L2 GND でリターン
- SW ノードのポリゴンは最小限に (dv/dt 大)
- 5V 出力は WS2812 のデータ品質に影響するためリップル抑制を意識

## 7. Open questions

- Q1: 外層銅箔厚 1 oz で足りるか → **電流が確定した (§4) ので計算できる状態**。
  最大は 5V 出力の 3 A と MP1584 の SW ピーク 3.44 A
- Q2: フェライトビーズの続投可否 — 3 A 定格品へ変更 or 撤去
- Q3: Bottom 面レジスト開口による放熱強化 (現状は行わない方針)
- Q4: 四隅 M2 穴の正確な位置 (端からの距離) と球体コア側の受け構造 — 親プロジェクトの機構と要調整
- Q5: コネクタの型番確定 (JST PH 系か、より小型か)
