sastles-com/power-2S-02/docs/05-jlcpcb-fab.md

# 05 — JLCPCB 発注フロー (EasyEDA 直発注)・BOM・LCSC 部品選定ルール

<subproject>
- name: jlcpcb-fab
- parent: power-2s-02
- status: draft
- depends_on: [02-ip2326-module, 03-mp1584-module, 07-easyeda-schematic-rules]
</subproject>

## Scope

JLCPCB への基板 + PCBA (実装) 発注に必要な手順・部品選定ルール・チェックリスト。

**EasyEDA Pro は JLCPCB と同一系列**のため、Gerber をエクスポートせず**エディタから直接発注**できる。
(KiCad + Fabrication Toolkit の旧フローは廃止 — EDA 移行により不要)

## 1. 発注フロー

1. **ERC / DRC をクリアさせる** (EasyEDA の設計ルールは JLCPCB 4 層の製造能力に準拠)
2. **全部品に LCSC 番号 (Supplier ID) が入っていることを確認** — §2 のルール
3. PCB エディタから「**JLCPCB へ発注**」を実行 → 基板仕様 (層数/板厚/色/表面処理) を指定
4. **PCBA を付ける場合**は BOM / 部品配置の照合画面で以下を目視確認:
   - 部品の**向き** (極性部品: ダイオード、タンタル、IC)
   - **未マッチ部品**の有無 (LCSC 番号が無い / 在庫切れ)
   - 手実装にする部品 (コネクタ等) の除外指定
5. 発注後、Gerber / BOM / 座標ファイルは記録用にエクスポートしておく (リポジトリには置かない — 設計本体はクラウド)

## 2. LCSC 部品選定ルール

1. **Basic Parts 優先** — 段取り費が掛からない。抵抗・コンデンサ・汎用トランジスタはほぼ Basic で揃う
2. Basic に無い場合は **Preferred → Extended** の順。Extended は在庫数を確認
3. **在庫 ≥ 発注数 × 10** を目安に選ぶ (再発注リスク回避)
4. **代替不可の IC を最初に在庫確認** — ここが律速:
   - ~~**IP2326**~~ → **確認済み・入手可** (2026-08-10、[`docs/02`](02-ip2326-module.md) §0)
   - ~~**MP1584EN**~~ → **確認済み。ただし在庫があるのは `MP1584EN-LF-Z` (C15051) だけ**
     — 他の MP1584 系 19 品目はすべて在庫 0 ([`docs/03`](03-mp1584-module.md) §0)
   - ディスクリートラッチ用の小信号 MOSFET ([`docs/06`](06-power-switch.md))
5. **確定した主要 IC の LCSC 番号**:

| 部品 | MPN | LCSC | 区分 | 在庫 (2026-08-10) | 備考 |
| --- | --- | --- | --- | --- | --- |
| 2S 昇圧チャージャ | **IP2326** | **C2832094** | Extended | 23,110 | VQFN-24-EP(4×4)。**`IP2326_NPD` (C5441281) と取り違えないこと** — あちらは充電電流 700 mA 未満品 ([`docs/02`](02-ip2326-module.md) §0) |
| 5V 降圧コンバータ | **MP1584EN-LF-Z** | **C15051** | Extended | 4,681 | SOIC-8-EP。**サフィックス違い (`MP1584EN` / `-LF-P` / `-Z` / `MP1584WN`) はすべて在庫 0 なので選ばない** ([`docs/03`](03-mp1584-module.md) §0) |
| 電源ラッチ N-MOS ×3 (Q1/Q5/Q6) | **2N7002** | **C8545** | **Basic** | 1,457,556 | ⚠️ Q1 は **I_DSS < 100 nA @85 °C** の確認が必要 ([`docs/06`](06-power-switch.md) §3.6.5 ④) |
| 電源ラッチ NPN ×2 (Q2/Q3) | **MMBT3904** | **C20526** | **Basic** | 698,799 | しきい値を Vbe 基準にしてタイマばらつきを抑える役 |
| 電源ラッチ P-MOS (Q4) | **BSS84** | **C85202** | Extended | 158,394 | Vgs 最大 ±20 V。※ AO3401A (**C15127 Basic**, 54 万) も可だが Vgs ±12 V で余裕 1.4 倍 |
| ボタン線 ESD 保護 (D1) | **SMF12A** | **C123800** | Extended | 80,360 | **standoff 12 V が必須**。⚠️ 一般的な `ESD9B5.0` (5 V) は**使えない** — ボタン節点に最大 8.4 V が載る ([`docs/06`](06-power-switch.md) §3.6.2) |

6. **2P 版で実績のある LCSC 番号** (2026-08-10 実測、流用可):

| 部品 | MPN | LCSC |
| --- | --- | --- |
| ショットキー SS34 (SMA) | SS34 | C8678 |
| 抵抗 0603 1% シリーズ | 0603WAF____T5E | C21189 (0R) / C21190 (1k) / C25804 (10k) / C25803 (100k) |
| セラコン 0603 | CL10 シリーズ | C15849 (1µF/50V) / C1591 (100nF/50V) |
| セラコン 1206 22µF/25V | CL31A226KAHNNNE | C12891 (**Basic**) |
| LED 0603 赤 | KT-0603R | C2286 |
| JST PH 2p (TH) | — | C20504437 |
| テストポイント | — | C9900007422 |
| ⚠️ セラコン 0805 10µF | CL21A106KAYNNNE | ~~C2980800~~ → **C15850 に差し替える** (§2.1 参照) |
| ⚠️ 小信号 P-MOS (デュアル) | SSM6J808R,LF | C20247098 — **直列 FET 方式廃止に伴い不使用** |

---

## 2.1 確定 BOM (2026-08-11 — EasyEDA ライブラリ実測で全件解決)

**`lib_Device.getByLcscIds()` / `search()` で全部品の存在・区分・パラメータを確認済み**
([`docs/07`](07-easyeda-schematic-rules.md) §3「部品を LCSC 番号から配置する」)。
以下をそのまま作図・BOM に使う。**空欄なし**。

### 半導体・IC (9 種)

| 用途 | MPN | LCSC | 区分 | 備考 |
| --- | --- | --- | --- | --- |
| 2S 昇圧チャージャ | IP2326 | **C2832094** | Extended | VQFN-24-EP(4×4)。`IP2326_NPD` (C5441281) と取り違え注意 |
| 5V 降圧 | MP1584EN-LF-Z | **C15051** | Extended | SOIC-8-EP。他サフィックスは全て在庫 0 |
| ラッチ N-MOS ×3 (Q1/Q5/Q6) | 2N7002 | **C8545** | **Basic** | ⚠️ Q1 は I_DSS < 100 nA @85 °C を確認 ([`docs/06`](06-power-switch.md) §3.6.5 ④) |
| ラッチ NPN ×2 (Q2/Q3) | MMBT3904 | **C20526** | **Basic** | Vbe 基準でタイマばらつきを抑える役 |
| ラッチ P-MOS (Q4) | BSS84-7-F | **C85202** | Extended | Vgs ±20 V。AO3401A (C15127 Basic) も可だが Vgs ±12 V で余裕 1.4 倍 |
| ボタン ESD 保護 | SMF12A | **C123800** | Extended | **standoff 12 V 必須**。`ESD9B5.0` は使用不可 |
| 逆流防止 / キャッチ (SMA) | SS34 | **C8678** | — | 充電入力段 + 降圧段キャッチの 2 箇所 |
| **外付け BST ダイオード** | **1N4148W** | **C81598** | **Basic** | SOD-123F。データシートが名指しする部品 ([`docs/03`](03-mp1584-module.md) §3.4)。Vf 1 V@50 mA → BST−SW ≈ 4.0 V で BST UVLO 2.2 V に対し余裕あり |
| LED 赤 ×2 (充電表示 / 電源 ON) | KT-0603R | **C2286** | — | 充電表示は IP2326 の LED ピン、電源 ON はラッチ側 |

### インダクタ (2 種)

| 用途 | MPN | LCSC | 値 | Idc | Isat | DCR | サイズ |
| --- | --- | --- | --- | --- | --- | --- | --- |
| 充電段 (昇圧) | SWPA6045S2R2NT | **C36500** | 2.2 µH | 4.6 A | 7.4 A | **18 mΩ** | 6.0 × 6.0 mm |
| 降圧段 | SWPA8040S4R7NT | **C36417** | 4.7 µH | 4.1 A | 6.5 A | **25 mΩ** | **8.0 × 8.0 mm** |

いずれも Extended。**電流余裕の検証** (実電流は [`docs/02`](02-ip2326-module.md) §3.1 / [`docs/03`](03-mp1584-module.md) §3.3):

| 段 | I_L 平均 | I_L ピーク | Isat 余裕 | Idc 余裕 |
| --- | --- | --- | --- | --- |
| 充電段 (入力 1.83 A、リップル 1.84 A p-p) | 1.83 A | **2.75 A** | 2.7× | 2.5× |
| 降圧段 (出力 3.0 A、リップル 0.89 A p-p) | 3.0 A | **3.44 A** | 1.9× | 1.37× |

⚠️ **⚠️ 降圧段の 8.0 × 8.0 mm は 40×40 基板で最大の部品**。レイアウトの制約になる ([`docs/04`](04-layout-thermal.md))。
より小型の `SWPA6045S4R7NT` (C316350) もあるが**ライブラリに電流・DCR のパラメータが入っておらず検証できない**ため採らなかった。
同様に `SWPA5040S2R2NT` (C96923、Isat 5.5 A、5.0×5.0) は DCR 未記載のため充電段でも採らなかった。
**小型化が必要になったらデータシートを直接当たって再選定する。**

### 抵抗 (16 種、すべて 0603 1% / RCB のみ 1206)

| 値 | MPN | LCSC | 区分 | 使用箇所 |
| --- | --- | --- | --- | --- |
| 1 Ω | RC0603FR-071RL | **C112305** | Extended | 充電 R1 (VIN ピンフィルタ)。**0.5 Ω は薄膜 1% 系に無いため 1 Ω を採用** — IC 消費 ~20 mA で降下 20 mV、無害 |
| 100 Ω | 0603WAF1000T5E | **C22775** | **Basic** | 充電 LED 電流制限 |
| **120 Ω (1206)** | 1206W4F1200T5E | **C17909** | **Basic** | 充電 **RCB** (均等化電流 34 mA / 0.14 W → 1206 必須) |
| 1.5 kΩ | 0603WAF1501T5E | **C22843** | **Basic** | ラッチ R8 (電源 ON LED、2.0 mA) |
| 10 kΩ | 0603WAF1002T5E | **C25804** | (2P 実績) | ラッチ R6 / R7 (ボタン直列・ESD) |
| 20 kΩ | 0603WAF2002T5E | **C4184** | **Basic** | 降圧 R2 (FB 下側) |
| 51 kΩ | 0603WAF5102T5E | **C23196** | **Basic** | 充電 RNTC (**NTC 不使用処理。入れ忘れると充電しない**) |
| 68 kΩ | 0603WAF6802T5E | **C23231** | **Basic** | 充電 RUV (入力 UV 4.35 V) |
| **91 kΩ** | 0603WAF9102T5E | **C23265** | Extended | 充電 **RISET** → **ICHG = 0.99 A** (§下の注記) |
| 100 kΩ | 0603WAF1003T5E | **C25803** | (2P 実績) | 降圧 R3 (補償) |
| 105 kΩ | 0603WAF1053T5E | **C16840** | Extended | 降圧 R1 (FB 上側) |
| 200 kΩ | 0603WAF2003T5E | **C25811** | **Basic** | 降圧 RFREQ (fsw ≈ 485 kHz) |
| 1 MΩ | 0603WAF1004T5E | **C22935** | **Basic** | ラッチ R2 / R5 |
| 2.2 MΩ | 0603WAF2204T5E | **C22938** | Extended | ラッチ R1 (**電源投入時 OFF を保証する要**) |
| 2.4 MΩ | 0603WAF2404T5E | **C13319** | Extended | ラッチ R3 (オフタイマ) |
| 4.7 MΩ | 0603WAF4704T5E | **C23163** | Extended | ラッチ R4 (T ノードのリーク排出) |

⚠️ **RISET は 90 kΩ ではなく 91 kΩ**: 90 kΩ は E24 / E96 いずれにも無い標準外の値。
E24 の 91 kΩ を使うと `ICHG = 90000/91000 = 0.99 A` で設計意図 (1.0 A) と実質同じ
([`docs/02`](02-ip2326-module.md) §3.1)。

### コンデンサ (8 種)

| 値 / 耐圧 | MPN | LCSC | 区分 | サイズ | 使用箇所 |
| --- | --- | --- | --- | --- | --- |
| 22 µF / **25 V** X5R | CL31A226KAHNNNE | **C12891** | **Basic** | **1206** | 充電 VSYS ×2 / 降圧 入力 ×2 / 出力 ×2 = **6 個** |
| 10 µF / **25 V** X5R | CL21A106KAYNNNE | **C15850** | **Basic** | 0805 | 充電 C1 / C3 / C6 |
| 4.7 µF / **25 V** X5R | CL21A475KAQNNNE | **C1779** | **Basic** | 0805 | ラッチ C2 (オフタイマ) |
| 1 µF / 50 V X5R | CL10A105KB8NNNC | **C15849** | **Basic** | 0603 | ラッチ C1 (保持タイマ) |
| 100 nF / 50 V X7R | CL10B104KB8NNNC | **C1591** | Extended | 0603 | 充電 BST / バランス C7,C8 / 降圧 BST・各段デカップリング |
| 10 nF / 50 V X7R | CL10B103KB8NNNC | **C1589** | Extended | 0603 | ラッチ C3 (`L` ノイズフィルタ) |
| 1 nF / 50 V X7R | CL10B102KB8NNNC | **C1588** | **Basic** | 0603 | ラッチ C5 (ボタン線フィルタ) |
| 220 pF / 50 V **C0G** | CL10C221JB8NNNC | **C27675** | Extended | 0603 | 降圧 C3 (補償) / ラッチ C4 (EN ノイズ対策) |

⚠️ **22 µF は 1206 で確定**: 0805 の 22 µF は **16 V 品までしか存在しない** (実測: C296720 が 16 V、C87997 が 6.3 V)。
25 V が必要なので 1206 (C12891) を使う。**6 個載る**ので面積影響が大きい ([`docs/04`](04-layout-thermal.md))。

⚠️ **10 µF は C2980800 ではなく C15850 を使う**: **MPN は同一** (CL21A106KAYNNNE) だが、
C2980800 は Extended でライブラリにパラメータが入っておらず、**C15850 は Basic で 25 V と明記**されている。
2P 版は C2980800 を使っているので**差し替えが必要**。

## 3. 基板仕様 (発注パラメータ)

| 項目 | 指定 |
| --- | --- |
| 層数 | **4 層** (stackup は JLC 標準で可、[`docs/04`](04-layout-thermal.md)) |
| サイズ | 40 × 40 mm |
| 板厚 | 1.6 mm |
| 銅箔 | 外層 1 oz ([`docs/04`](04-layout-thermal.md) Q1 の計算次第で 2 oz) |
| 実装 | **片面実装 (Top のみ)** — Economic PCBA が使える可能性が高い |
| レジスト色 | 未確定 (§5 Q2) |
| 表面処理 | 未確定 (§5 Q2) |

## 4. 発注前チェックリスト

- [ ] ERC クリーン (未接続ピン・重複 Designator・NET_PORT の孤立が無いこと)
- [ ] DRC クリーン (JLCPCB 4 層のルール。min trace/space は余裕をもって 0.15/0.15 mm 以上)
- [ ] 全実装部品に LCSC 番号あり、在庫確認済み
- [ ] 極性部品の向きを 3D / 実装プレビューで目視確認
- [ ] **2P 版からの残留部品が無いこと** ([`docs/07`](07-easyeda-schematic-rules.md) §5 手順 5)
- [ ] 四隅 M2 穴 (Φ2.2) の位置と、球体コア側との干渉確認
- [ ] フィデューシャル (PCBA 用) の要否確認

## 5. Open questions

- ~~Q1: IP2326 の LCSC 在庫~~ → **クローズ** (2026-08-10、C2832094 在庫 23,110 / JLCPCB Extended で実装可)
- Q2: レジスト色・表面処理
- Q3: 発注数量と実装範囲 (PCBA 何枚 + 基板のみ何枚)
