sastles-com/power-2S-02/docs/01-legacy-analysis.md

# 01 — legacy power-2S 基板の完全解析

<subproject>
- name: legacy-analysis
- parent: power-2s-02
- status: stable (解析完了、参照専用)
- source: `legacy/power-2S.kicad_sch` / `legacy/power-2S.kicad_pcb` (KiCad 10.0)
</subproject>

## Scope

旧版 power-2S (50×40 mm, 2 層) の回路・ネット構成の記録。**新基板 (power-2s-02) の回路リファレンス (正)** として使う。
解析は 2026-08-10 に `kicad-cli sch export netlist` の出力から行った。

## 1. システム全体像

```text
USB充電器 ──> J14 "CHARGE" ──POWER──> D1(ショットキー) ──CHARGE──> [U3 IP2326モジュール VIN]
                                                                        │ B+ ── P+ ネット
                                                                        │ BM ── BM ネット (セル中点直結)
                                                                        │ B− ── PGND
2S LiPo セル ──> J5/J6 ──B+/BM/B−──> [U2 XR-2S-30A BMS ※オフボード] ──P+/P−──> P+ / PGND
P+ ──FB1──> VIN ──> [U5 MP1584モジュール] ──> VOUT (5V)
VOUT ──> [Q2 DMG3415 P-FET] ──> VOUT_SWITCHED ──> J9 "OUTPUT"
              ↑ GATE
        [U1 MAX16054 プッシュボタンON/OFFラッチ]  (電源検出は POWER ネット)
```

ポイント:

- **充放電電流は必ず BMS (U2) の FET を通る** (U3 の B+/B− は保護後の P+/PGND に接続)
- **BM (バランス端子) だけは BMS を経由せずセル中点へ直結** — 新基板でも必ず踏襲
- U2 はフットプリント無し (基板非実装、ワイヤ接続)。回路図に結線記録として残す方式も踏襲する

## 2. 主要部品 (legacy BOM)

| Ref | Value | Footprint | 役割 |
| --- | --- | --- | --- |
| U1 | MAX16054 | TSOT-23-6 | プッシュボタン ON/OFF ラッチコントローラ |
| U2 | 2S-BMS (XR-2S-30A) | **無し (オフボード)** | 2S 保護 (過充放電・過電流) |
| U3 | IP2326 | neon:TS2326 (モジュール搭載穴) | Type-C 15W 2-3S 昇圧充電モジュール → **新基板でディスクリート化** |
| U5 | MP1584EN | neon:MP1584EN (モジュール搭載穴) | 降圧 5V モジュール → **新基板でディスクリート化** |
| Q2 | DMG3415 | SOT-23 | P-ch FET、5V 出力スイッチ |
| D1 | ショットキー (SS34 系) | Vishay SMPA | 充電入力の逆流防止 |
| FB1 | フェライトビーズ | 0603 | P+ → MP1584 入力のノイズフィルタ |
| C1, C7 | 100 µF タンタル | EIA-3528-12 | MP1584 入出力バルク |
| C3, C5, C6 | 22 µF | 0805 | 入出力セラミック |
| C2, C4, C8 | 0.1 µF | 0603 | パスコン |
| R5 | 47 kΩ | 0603 | POWER 検出プルダウン |
| R6 | 10 kΩ | 0603 | CLR プルダウン |

## 3. 全ネット表 (netlist から抽出 — これが新基板回路の正)

| ネット | 接続 (Ref.Pin) | 意味 |
| --- | --- | --- |
| **B+** | J5.2, U2.1(B+) | セル上端 (保護前) |
| **BM** | J5.1, J6.2, J1.2, J2.2, J8.5, U2.2(BM), U3.2(BM) | **セル中点。IP2326 バランス端子直結** |
| **B−** | J6.1, U2.3(B−) | セル下端 (保護前) |
| **P+** | U2.4(P+), U3.1(B+), FB1.1, J1.3, J2.3, J8.6 | 保護後パック + (充放電共通) |
| **PGND** | U2.5(P−), U3.3(B−), U3.5(GND), U5.1(IN−), U5.4(OUT−), C1-C8 の GND 側, R5.2, R6.1, U1.2, J1.1, J2.1, J3.1, J4.1, J7.1, J7.6, J8.1, J8.4, J9.1, J14.1 | 保護後 GND (基板のベタ GND) |
| **POWER** | J14.2, J8.2, J8.3, D1.2(A), C8.1, R5.1, U1.1(IN) | 充電入力 (5V, ダイオード前) |
| **CHARGE** | D1.1(K), U3.4(VIN) | 充電入力 (ダイオード後) → IP2326 VIN |
| **VIN** | FB1.2, C1.1, C2.1, C3.1, J3.2, U5.2(IN+) | MP1584 入力 (= フィルタ後 P+) |
| **VOUT** | U5.3(OUT+), C4.1, C5.1, C6.1, C7.1, J4.2, J7.4, J7.5, Q2.2(S), U1.6(VCC) | 5V (スイッチ前) |
| **VOUT_SWITCHED** | Q2.3(D), J9.2, J7.2, J7.3 | 5V (スイッチ後、負荷へ) |
| **GATE** | U1.4(OUT#), Q2.1(G) | FET ゲート駆動 |
| **OUT** | U1.5(OUT), J11.1 | ラッチ状態モニタ |
| **CLR** | U1.3(CLR), R6.2, J12.1 | 強制オフ入力 |

補足: U1 MAX16054 のプッシュボタン入力ピン結線は新基板作図時に legacy 回路図で再確認すること (netlist 抽出時の対象外)。

### 3.1 新基板で使うネット名 (ASCII 規約) — 作図時はこの右列を使う

⚠️ **上表の `B−` `P−` `IN−` `OUT−` のマイナスは Unicode の U+2212 (数学記号) で、ASCII のハイフンではない。**
この文字をそのまま EasyEDA のネット名にすると、検索・BOM 突き合わせ・ERC メッセージ・ネットクラス指定で
一致しなくなる事故が起きる。また `+` もネット名には使いにくい。**実ネット名は下表の ASCII 名に統一する。**

| legacy 表記 | **EasyEDA 上のネット名 (正)** | 意味 |
| --- | --- | --- |
| B+ | `BATT_P` | セル上端 (保護前) |
| BM | `BATT_M` | セル中点 (IP2326 バランス端子直結) |
| B− | `BATT_N` | セル下端 (保護前) |
| P+ | `PACK_P` | 保護後パック + |
| P− / PGND | `GND` | 保護後 GND (ベタ GND。作図規約により NET_PORT を使わない例外) |
| POWER | `CHG_IN` | 充電入力 (ショットキー前) |
| CHARGE | `CHG_VIN` | 充電入力 (ショットキー後) → IP2326 VIN |
| VIN | `SW_VIN` | MP1584 入力 (フィルタ後 PACK_P) |
| VOUT | `V5V` | 5V 出力 (2P 版の NET_PORT 名と一致させる) |

- `BATT_M` は **M = Middle (中点)**、`BATT_N` は **N = Negative (下端)**。紛らわしいので混同しないこと。
- 廃止ネット (`VOUT_SWITCHED` / `GATE` / `CLR` / `OUT`) は §5 参照。

### 3.2 新規ネット (2026-08-11 作図時に確定)

**CHARGE ブロック** ([`docs/02`](02-ip2326-module.md)):

| ネット | 意味 |
| --- | --- |
| `CHG_VINF` | IP2326 の **VIN ピン**側 (R14 = 1 Ω フィルタ後)。**EN もここに接続**して常時イネーブルにする |
| `CHG_LX` | 昇圧スイッチノード (LX ピン ×3 ↔ L10 ↔ BST コンデンサ) |
| `CHG_BST` | BST ピン (LX との間に 0.1 µF) |
| `CHG_VSYS` | 昇圧中間ノード (VSYS ピン ×2 に 22 µF ×2) |
| `CHG_VBATM` | **VBATM ピン側** (RCB = R16 の手前)。RCB の先が `BATT_M` |
| `CHG_ISET` / `CHG_UVSET` / `CHG_NTC` | 設定抵抗 (91 k / 68 k / 51 k) → GND |
| `CHG_LED` / `CHG_LEDA` | 充電表示 LED (LED ピン → R15 → D11 → GND) |
| ~~`BAT_STAT`~~ | **廃止 (2026-08-12)** — 情報価値が無いため未使用 NC に ([`docs/02`](02-ip2326-module.md) §3.5a) |

**PMIC ブロック** ([`docs/06`](06-power-switch.md) §3.6):

| ネット | 意味 |
| --- | --- |
| `PMIC_L` | ラッチノード。H = 電源 OFF / L = 電源 ON |
| `PMIC_H` | 自己保持ノード (Q31 のベース)。~0.7 V にクランプ |
| `PMIC_T` | オフタイマノード (Q32 のベース) |
| `SW_BTN` | 押しボタン線 (基板外)。TVS は基板側 |
| `PWR_EN` | MP1584 の EN へ |
| `TMR_CHG` / `BTN_G` / `LED_A` | オフタイマ充電経路 / Q33 ゲート / 電源 ON LED |

**DCDC ブロック** ([`docs/03`](03-mp1584-module.md)):

| ネット | 意味 |
| --- | --- |
| `DC_SW` | スイッチノード (SW ピン ↔ L20 ↔ D20 キャッチ ↔ BST コンデンサ) |
| `DC_BST` | BST ピン。C26 (100 nF) と **D21 (外付け BST ダイオード)** が付く |
| `DC_FB` | FB ピン (R20 105 k / R21 20 k の分圧点) |
| `DC_COMP` / `DC_COMPR` | 補償ネットワーク (COMP → R22 100 k → C27 220 pF → GND の直列 RC) |
| `DC_FREQ` | FREQ ピン → R23 (200 kΩ) → GND。fsw ≈ 485 kHz |

⚠️ **内部ノードは `CHG_` / `PMIC_` / `DC_` 接頭辞を付ける** — NET_PORT の一覧で
システムバス (`PACK_P` / `V5V` / `BATT_*` / `CHG_IN` / `PWR_EN` / `SW_BTN`) と区別するため。

## 4. コネクタ: legacy 11 個 → 新基板は最小構成へ削減 (2026-08-10 決定)

40×40 ではコネクタ面積が支配的になるため、**最小構成 (4〜5 個) に削減**し、デバッグ口はテストポイントで代用する。

### 新基板のコネクタ構成 (確定方針)

**電源の主インターフェースは 6p 2.54mm ヘッダ 2 個** (2P 版の CN5/CN6、legacy の J7/J8 に相当) で、
**基板の左右端・同一 Y・対向に配置する** ([`docs/04`](04-layout-thermal.md) §3.1)。
6p のうち複数ピンを電源に割り当てて電流容量を稼ぐ流儀を踏襲する。

| Ref (新) | 用途 | 主な信号 | 由来 |
| --- | --- | --- | --- |
| **CN6 (VIN 6p)** | 入力側インターフェース | GND / 充電入力 / P+ / BM | legacy J8、2P 版 CN6 |
| **CN5 (VOUT 6p)** | 出力側インターフェース | GND×2 / 5V×2 ほか | legacy J7、2P 版 CN5 |
| セル 1 | B+ / BM | 2p | legacy J5 |
| セル 2 | BM / B− | 2p | legacy J6 |
| BMS 戻り | P+ / P−(PGND) | 2p | legacy J1/J2 を 1 個に統合 |

### 実装した電池系コネクタ (2026-08-12 — 上表のセル 1/2 を 3P 1 個に統合)

**すべて `HX PZ2.0` (2.00 mm SMD 縦型) 系で統一**した。`CN7`/`CN8` (北極) と同シリーズで、
ハーネスのコネクタを 1 種類に揃えられる。

| Ref | Value | 極数 / LCSC | ピン割り当て | 流れる電流 |
| --- | --- | --- | --- | --- |
| `CN1` | `CHARGE` | 2P / **C41417341** | 1=GND / 2=`CHG_IN` | 充電入力 ~1.83 A |
| `CN2` | `CELLS_2S` | 3P / **C41417342** | 1=`BATT_P` (B+) / 2=`BATT_M` (BM) / 3=`BATT_N` (B−) | 充電 0.99 A (BM は均等化 34 mA のみ) |
| `CN3` | `BMS_RET` | 4P / **C41417343** | 1,2=`PACK_P` / 3,4=GND | **放電 ~2.8 A** → 2 ピン並列 |

- **`CN3` を 4P にした理由**: `PACK_P` は 5V/3A 出力の元電流を全部担う。
  効率 90% / パック電圧 6.0 V (放電末期) で **2.8 A**。`HX PZ2.0` は **2 A/ピン**なので 1 ピンでは足りない。
  **2 ピン並列で ~4 A** を確保する (P+ 側 / P− 側の両方)
- **`CN2` は 3P で足りる**: 充電電流 0.99 A は 2 A/ピンの範囲内。BM は均等化の 34 mA しか流れない
- ⚠️ **`CN2` (3P) だけシンボルの pin 2 が右側に出る**ライブラリ作りになっている
  (pin 1,3 は左、pin 2 だけ右)。回路図では `BATT_M` を右へ引き出してある。フットプリントは正常な 1×3
- ⚠️ **`CN1` と `CN6` の `VBUS` が重複していないか要確認** → §6 Q4

### XR-2S-30A の端子と本基板のネットの対応 (2026-08-12 整理)

BMS は **B+ / BM / B− (電池側)** と **P+ / P− (ポート側)** の 5 端子。
充電器と負荷は**どちらも P+ / P− に付く** (コモンポート型)。

| BMS 端子 | 本基板のネット | コネクタ | 役割 |
| --- | --- | --- | --- |
| **B+** | **`BATT_P`** | `CN2.1` | 上セル + 。IP2326 の VOUT (充電電流が入る) |
| **BM** | **`BATT_M`** | `CN2.2` | セル中点。RCB 120 Ω 経由で pin 23 (均等化 34 mA) |
| **B−** | **`BATT_N`** | `CN2.3` | 下セル −。**IP2326 pin 24 のセンス + 均等化の戻りだけ。GND ではない** |
| **P+** | **`PACK_P`** | `CN3.1,2` | 保護後のパック + 。MP1584 と LDO の入力 |
| **P−** | **`GND`** | `CN3.3,4` | **系のグランドはここ。B− ではない** |

#### ⚠️ `BATT_N` は GND ではない

`B−` と `P−` の間に**保護 FET が入っている**ため、両者は別ノードである:

- 通常時は FET の Rds 分 (数 mV) しか違わないが、**保護がトリップすると完全に切り離される**
- したがって `BATT_N` を基板上で GND に落としてはいけない。
  **回路図で確認済み (2026-08-12): `BATT_N` は GND と DC 短絡していない** (`C8` 0.1 µF の AC 結合のみ) ✓
- 充電電流の戻りは `B− → 保護 FET → P− (=GND) → IP2326 の PGND/EPAD` を通る。
  **この経路が保護 FET を通ることが、充電も保護対象になる条件**

#### `BATT_P` と `PACK_P` は「同じ銅」かもしれないが、基板上で結んではいけない

XR-2S-30A の写真では **FET 群が B− / BM 側に寄っている** → **低圧側 (B−) スイッチング**と読める。
その場合 **`P+` は基板内部で `B+` と繋がっている** ので、`BATT_P` と `PACK_P` は電気的に同じノードになる。

**それでも本基板では 2 本の別ネット・別コネクタのまま維持する。** 理由:

1. **FET がどちら側に入っているかは実物を測らないと確定できない。** 万一**高圧側**スイッチングだった場合、
   基板上で `BATT_P` と `PACK_P` を結ぶと**保護を丸ごとバイパスする**致命的な配線になる
2. legacy もこの 5 線構成で動いていた (§3)
3. コスト差は電線 1 対だけで、`CN2`/`CN3` として既に確保済み

**確認方法 (テスター)**: `B+`–`P+` 間が 0 Ω なら低圧側スイッチング / `B−`–`P−` 間が 0 Ω なら高圧側。
→ [§6](#6-open-questions) Q5 の検証項目。

- **Type-C レセプタクルは載せない** (充電入力はコネクタのみ、[`docs/02`](02-ip2326-module.md))
- セル 1 / セル 2 / BMS 戻りを 1 個の多極コネクタに統合するかは型番選定時に判断 (§6 Q1)
- 6p ヘッダ 2 個の**ピン割り当ての確定は未了** (§6 Q3)

### 廃止する legacy コネクタ

| Ref | 名称 | 廃止理由 |
| --- | --- | --- |
| J1, J2 | BATTERY 3p ×2 | 重複。BMS 配線用に 1 個へ統合 |
| J3 | BATTERY 2p (VIN 直タップ) | 用途不明・不要 |
| J4 | DIRECT (FET 迂回 5V) | **EN 制御方式では FET が無いため概念自体が消滅** |
| J9 | OUTPUT 2p | CN5 (6p) に統合 |
| J11 | OUT (ラッチ状態) | テストポイントで代用 |
| J12 | CLR (強制オフ) | **強制オフ端子は設けない方針** ([`docs/06`](06-power-switch.md)) |
| J14 | CHARGE 2p | CN6 (6p) に統合 |

## 5. 新基板で廃止されるネット

EN 制御方式への移行 ([`docs/06`](06-power-switch.md)) により、§3 のネット表から以下が消える:

| ネット | 廃止理由 |
| --- | --- |
| `VOUT_SWITCHED` | 直列 P-FET が無くなり、VOUT 自体を EN で断続するため |
| `GATE` | P-FET のゲート駆動が不要 |
| `CLR` | 強制オフ端子を設けない |
| `OUT` | MAX16054 のラッチ状態出力が不要 |

新規に必要なネット: ラッチ回路の内部ノード、**降圧 IC の EN**、**LED 駆動**。
(ESP32 ソフト電源断はペンディングのため、ラッチのオフ側ノードにパッドを 1 個予約するだけ — [`docs/06`](06-power-switch.md))

## 6. Open questions

- ~~Q1: セル/BMS 系コネクタの型番確定~~ → ✅ **確定 (2026-08-12)**。`HX PZ2.0` 系で統一し
  **`CN1` 2P (充電入力) / `CN2` 3P (セル B+/BM/B−) / `CN3` 4P (BMS 戻り、2 ピン並列)** を実装 (§4)
- **Q5 (NEW, 2026-08-12): XR-2S-30A の保護 FET は低圧側 (B−) か高圧側 (B+) か** —
  実物で `B+`–`P+` / `B−`–`P−` の導通を測って確定する。低圧側なら `BATT_P` = `PACK_P` (同じ銅) になるが、
  **どちらでも基板上では結ばない** (§4)。あわせて**保護トリップ後にパックが自己放電しないか**を実測する
  (IP2326 pin 24 は B− に繋がるので、GND が B− より高くなると内部 ESD ダイオードが
  保護をバイパスする寄生経路になりうる。~30 µA 級なら実用上無害だが要確認)
- **Q4 (NEW): `CN1` (`CHG_IN`) と `CN6` の `VBUS` は同じ電流経路ではないか** —
  南極磁気端子の 5 V が「本基板へ直接 (`CN1`)」来るのか「コア/mother-ring 経由 (`CN6` の `VBUS`)」なのかで
  どちらか一方が不要になる。現状は両方が図面にあり、`VBUS` は `CN6` に 2 ピンぶら下がっているだけで
  基板内のどこにも繋がっていない (2P 版の残骸の可能性)。**Q3 と同時に決める**
- Q2: MAX16054 のプッシュボタン結線の詳細 — **参考情報としてのみ** (方式が変わったため踏襲はしない)
- Q3: **CN5 / CN6 (6p 2.54mm) のピン割り当ての確定** — legacy J7/J8 と 2P 版 CN5/CN6 で内容が違うため、
  2S 版として何を通すか (充電入力 / P+ / BM / 5V / GND の配分と、電流容量のための重複ピン数) を決める必要がある
