sastles-com/power-2S-02/(list of files, drawings)

Other design files:
legacy/tools/schematic-dump.json
tools/schematic-dump.json
