sastles-com/power-2S-02/legacy/power-2S.kicad_pcb

## KiCad design legacy/power-2S.kicad_pcb (2026-08-09, an earlier design)

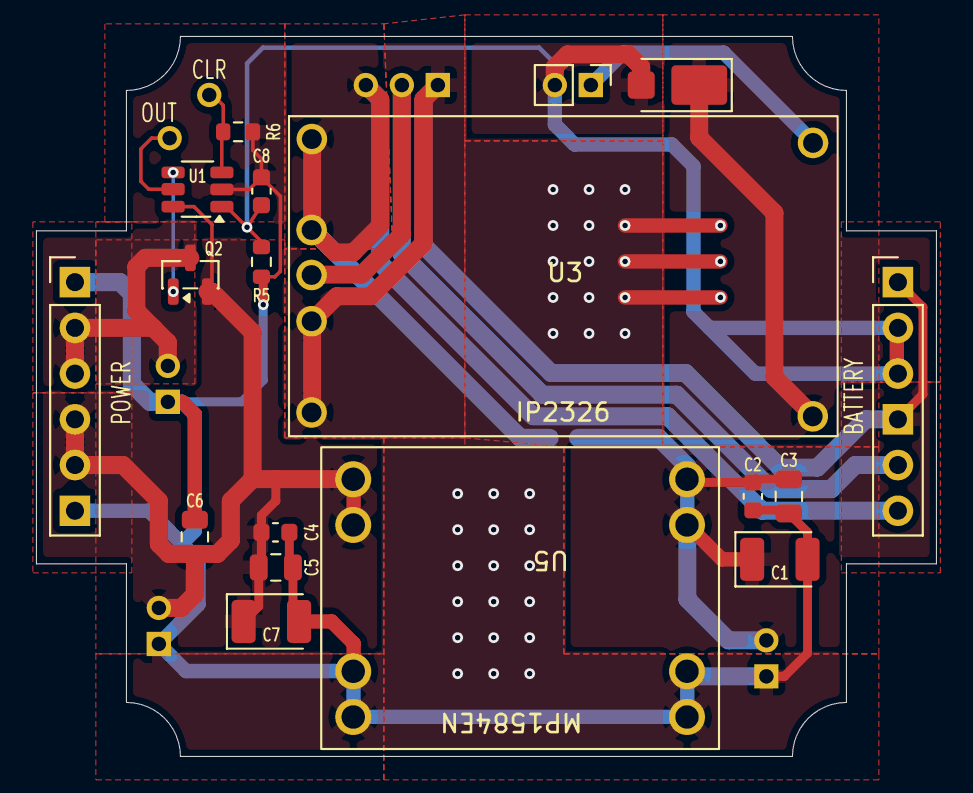
[picture p1: board power-2S.kicad_pcb from above]

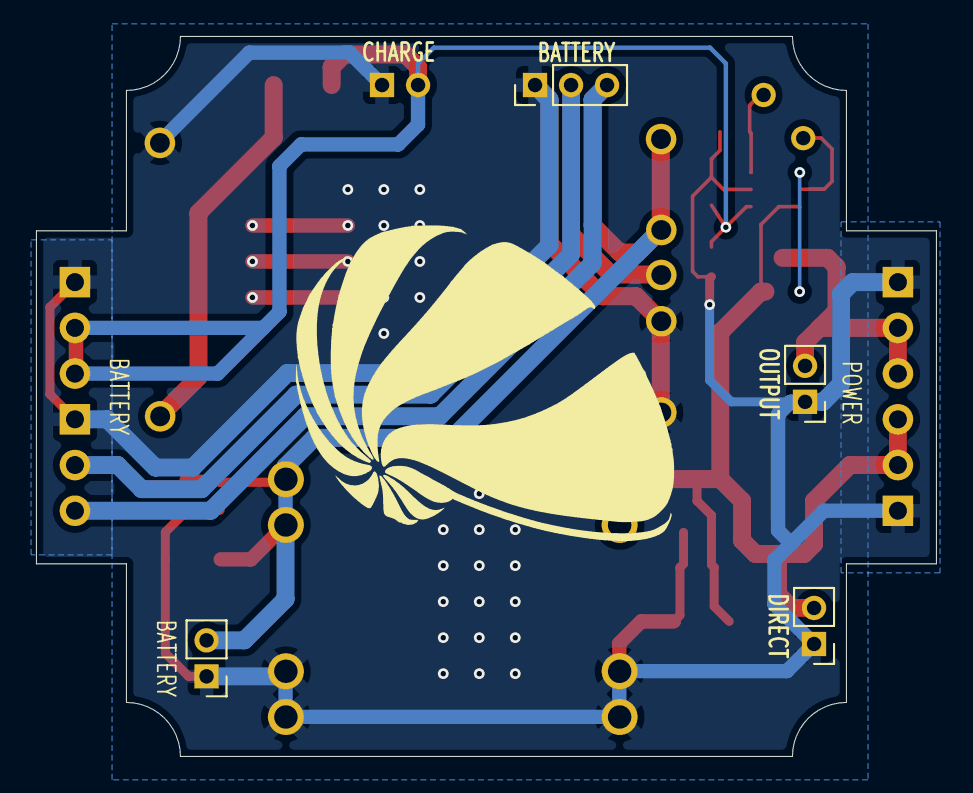
[picture p2: board power-2S.kicad_pcb from below]

Board: 2 copper layers, 50.0 x 40.0 mm, 25 parts (5 on the bottom side), 11 nets.

Parts:
C1, C7: 100uF; CP_EIA-3528-12_Kemet-T
C2, C4, C8: 0.1uF; C_0603_1608Metric
C3, C5, C6: 22uF; C_0805_2012Metric
D1: D_Schottky_Small; Vishay_SMPA
FB1: FerriteBead; L_0603_1608Metric
J1: BATTERY; PinHeader_1x03_P2.00mm_Vertical
J3: BATTERY; PinHeader_1x02_P2.00mm_Vertical
J4: DIRECT; PinHeader_1x02_P2.00mm_Vertical
J7: VOUT; PinHeader_1x06_P2.54mm_Vertical
J8: VIN; PinHeader_1x06_P2.54mm_Vertical
J9: OUTPUT; PinHeader_1x02_P2.00mm_Vertical
J11: OUT; PinHeader_1x01_P2.00mm_Vertical
J12: CLR; PinHeader_1x01_P2.00mm_Vertical
J14: CHARGE; PinHeader_1x02_P2.00mm_Vertical
Q2: DMG3415; SOT-23
R5: 47kΩ; R_0603_1608Metric
R6: 10kΩ; R_0603_1608Metric
U1: MAX16054; TSOT-23-6_HandSoldering
U3: IP2326; TS2326
U5: MP1584EN

Connections:
BM: J1.2, J8.5, U3.2 (BM)
CHARGE: D1.1 (K), U3.4 (VIN)
CLR: J12.1 (Pin_1_1), R6.2, U1.3 (CLR)
GATE: Q2.1 (G), U1.4 (OUT_)
OUT: J11.1 (Pin_1_1), U1.5 (OUT)
P+: FB1.1, J1.3, J8.6, U3.1 (B+)
PGND: C1.2, C2.2, C3.2, C4.2, C5.2, C6.2, C7.2, C8.2, J1.1, J3.1, J4.1, J7.1, J7.6, J8.1, J8.4, J9.1, J14.1, R5.2, R6.1, U1.2 (GND), U3.3 (B-), U3.5 (GND), U5.1 (IN-), U5.4 (OUT-)
POWER: C8.1, D1.2 (A), J8.2, J8.3, J14.2, R5.1, U1.1 (IN)
VIN: C1.1, C2.1, C3.1, FB1.2, J3.2, U5.2 (IN+)
VOUT: C4.1, C5.1, C6.1, C7.1, J4.2, J7.4, J7.5, Q2.2 (S), U1.6 (VCC), U5.3 (OUT+)
VOUT_SWITCHED: J7.2, J7.3, J9.2, Q2.3 (D)
