sastles-com/power-2S-02/(commit log)

2026-08-09 kiban: power-2s-02 仕様書一式を追加 (IP2326/MP1584 ディスクリート化プロジェクト)
    - power-2s-02/CLAUDE.md: 自己完結型プロジェクトガイド (40x40/4層/JLCPCB/KiCad継続)
    - HANDOFF.md: 作業状態・判断済み事項・次アクション
    - docs/01-05: legacy完全解析(全ネット表)・IP2326/MP1584オンボード化仕様・
    レイアウト排熱設計・JLCPCB発注/LCSC部品選定ルール
    - legacy/: 旧版 power-2S (回路リファレンス一次資料) を追跡対象に追加
    - ルート CLAUDE.md §8.1 索引に power-2s-02 行を追加
    [power-2S.kicad_pcb, power-2S.kicad_sch]
2026-08-10 kiban: power-2s-02 回路図作図ルールを追加 (モジュール枠 + グローバルラベル規約)
    - §3.5 新設: 機能モジュールごとに四角でくくる / モジュール内は直接配線 /
    モジュール間はグローバルラベル経由のみ
    - Hard Rules に ALWAYS 行を追加
2026-08-10 kiban: power-2s-02 に 2P/2S 対比の明記 + 電源スイッチ方式検討 doc を追加
    - CLAUDE.md §7: EasyEDA 2P 版 (isolation-sphere-power) との対比表を追加。
    電源変換段 (TP4056/TPS61088) の流用禁止と流用可能項目を明記
    - docs/06-power-switch.md 新設: MAX16054 を必須とせず方式比較
    (legacy 踏襲 / MAX16054+EN / ディスクリートラッチ+EN / 他)。
    推奨は 2S 直動作ディスクリートラッチ + MP1584 EN 制御
    - CLAUDE.md §1 / HANDOFF.md を方針変更に合わせて更新
2026-08-10 kiban: power-2s-02 に .gitignore を追加 (単独リポジトリ運用向け)
2026-08-10 kiban: power-2s-02 仕様確定 — EasyEDA Pro 移行 + 作図規約 doc + 主要設計判断
    方針決定 (2026-08-10):
    - EDA を EasyEDA Pro へ移行 (KiCad は legacy 参照専用に降格)
    - 2P 版 isolation-sphere-power を複製して 2S 版に改造する方式
    - 5V は固定 5V / 最大 3A (MP1584 維持)、IC 引き上げは行わない
    - 電源 ON/OFF はディスクリートラッチ + EN 制御 (MAX16054 と直列 P-FET 廃止)
    付帯: ESP32 ソフト電源断 + 電源状態 LED、強制オフ端子は無し
    - 充電入力はコネクタのみ (Type-C レセプタクル非搭載)
    - コネクタは最小構成 4〜5 個へ削減、四隅 M2 穴 + 片面実装
    - 回路定数は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
2026-08-10 kiban: power-2s-02 別PC作業前提のパス整理 + CN5/CN6 配置制約 + skill 化方針
    ユーザー指示の反映 (2026-08-10):
    - LiPo 構成 (2S 2000mAh×2) は確認済みで正しい → 親doc への申し送りを撤回
    - ESP32 ソフト電源断を一旦ペンディング (回路は実装せず、ラッチのオフ側に
    パッド1個のみ予約して後付け可能にする)
    - CN5 (VOUT 6p) / CN6 (VIN 6p) は基板左右端・同一Y・対向配置。
    2P 版 PCB の実測値 (x=-1.65mm / +41.66mm, y≈-19.7mm, rot -90) を docs/04 §3.1 に収録。
    これに伴い J9/J14 を 6p ヘッダへ統合し、ピン割り当てを Open Question に追加
    - パスは別PCで作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
2026-08-10 kiban: power-2s-02 正本を単独リポジトリに確定 + Linux 作業環境の構築手順を収録
    - リポジトリ運用: 単独リポジトリ `sastles-com/power-2S-02` を正本に確定し、
    モノレポとの二重管理 (git subtree split) を廃止。逆方向 (モノレポへの取り込み)
    だけを許可する運用に変更 (CLAUDE.md §5 / HANDOFF 判断済み事項)
    - docs/07 §3: ブリッジの実体を明記
    - Claude --HTTP--> bridge-server.mjs --WS--> run-api-gateway 拡張 --> eda.* の経路
    - EDA 側から外向きに繋ぐ方式 (`eda.sys_WebSocket.register()`) なので
    ブリッジを先に起動する必要があること、外部交互権限が必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
2026-08-10 kiban: power-2s-02 レビュー指摘 3 件を修正 (電流予算 / ネット名 / 充電中LED)
    1. 5V 電流予算の二重計上を修正 (CLAUDE.md §9 / docs/03 §4 / HANDOFF 申し送り1)
    設計上限 3 A のうち WS2812 の静止電流 0.6-0.8 A は消灯でも消費するため、
    発光に使えるのは約 2.2 A。LED 1 個あたりの上限は 3.75 mA ではなく
    **2.75 mA** (全白の約 5%)。3.75 mA は総電流を単純に 800 で割った値で、
    静止電流を二重に数えていた。稼働時間の見積りにも効率損失の注記を追加。
    2. ネット名の ASCII 規約を新設 (docs/01 §3.1、Hard Rule 化)
    legacy 表記 `B−` `P−` `IN−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
2026-08-10 kiban: power-2s-02 Linux 作業機で EasyEDA ブリッジの疎通を確認 + 落とし穴を記録
    EasyEDA Pro 3.2.149 (Linux) と run-api-gateway v1.0.5 の疎通を確認し、
    つまずいた 3 点を docs/07 §3 と eda-connect skill に反映した。
    - 起動順: 拡張の自動接続は 3s x 5 = 約 15 秒で打ち切り、以後再試行しない。
    ブリッジ → EasyEDA Pro の順で起動する。逆順の復旧は API Gateway → Reconnect
    - Online モード必須: 半離線ではクラウドプロジェクトが 0 件になる。
    getUserInfo() もローカル用の別 uuid を返すため原因を見誤りやすい
    - プロジェクト照会: getAllProjectsUuid() は引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
2026-08-10 kiban: power-2s-02 EasyEDA プロジェクトを 2P 版から複製して作成
    GUI「名前を付けて保存」で isolation-sphere-power を複製し power-2S-02 を作成。
    API に複製手段は無く、getProjectFileByProjectUuid + importProjectByProjectFile は
    beta かつライブラリ参照が張り替わる恐れがあるため採用しなかった。
    - project uuid 12e4820a5a9c49509b15e944859df944
    - 複製直後: 部品 73 / 配線 76 / 枠 4 — docs/07 §1 の実測記録と一致
    - 複製元は無傷。中身の改変は未実施 (TP4056/TPS61088/MAX16054 が残存)
    BOM を吐かせて 2P 版の実装 IC を確定させ、CLAUDE.md §7 の対比表が正しいことを
    裏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
2026-08-10 kiban: power-2s-02 IP2326 の入手性確認とデータシート照合を完了
    - 入手性 (律速項目) をクリア: LCSC C2832094 / 在庫 23,110 / VQFN-24-EP(4x4) /
    EOL なし / JLCPCB Extended で SMT 実装可 → 代替 IC の検討は不要
    - 派生品 IP2326_NPD (C5441281) は充電電流 700mA 未満品。取り違え注意を BOM ルールに明記
    - データシート (ChipSourceTek V1.2, 19p) から 24 ピン配置・全設定抵抗・標準回路 BOM を確定
    - 充電電流 1.0A (RISET 90k) を推奨値に: IC 上限 1.5A ではなく AWG26 の ~2A が律速
    (入力 1.83A)。親プロジェクト Q41 への回答になる
    - 充電中 LED のブロッカー解消: IP2326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
2026-08-10 kiban: power-2s-02 充電段の残り 3 件を決着 — IP2326 の定数を全確定
    ユーザー判断 (2026-08-10):
    - バランス: RCB を入れる。**値は 120Ω/1206** — データシート標準回路の 100Ω は
    VCBON=4.1V を代入すると ICB<40mA 制約を破るため E24 一段上へ。ICB=34mA / 0.14W。
    RCB 1 個で上下セル両方のシャント経路に直列に入る (どちらも pin23 を通る) ことを確認。
    0Ω は禁止 (内蔵均等化 MOS がセルを短絡する)
    - Type-C なし → DM/DP は未接続 (配線を引かない)。CC 抵抗 5.1kΩ×2 も不要。
    交渉失敗時は 5V 充電へ自動フォールバックするので機能欠落なし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
2026-08-10 kiban: power-2s-02 MP1584 のデータシート照合と定数設計を完了
    入手性:
    - MP1584EN-LF-Z = LCSC C15051 (SOIC-8-EP, 在庫 4681, JLCPCB Extended)
    - MP1584 系で在庫があるのはこれだけ。他 19 品目は全て在庫 0
    定数 (データシート Rev 1.0 全 18p + 自前計算):
    - 固定 5V: R1 105k / R2 20k (1%) → 正確に 5.000V。標準値 210k/40.2k は
    無負荷ブリード電流 20.0uA が制約 (>20uA) ギリギリなので採らない
    - fsw ≈ 485kHz (RFREQ 200k)。標準回路の 100k (≈911kHz) では最小オフ時間
    100ns の制約で VIN 6.1V 以下の 3A regulation が不能
    - L1 = 4.7uH / Isat >= 5A / DCR <= 30mΩ (計算 4.17uH)
    - 外付け B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
2026-08-10 kiban: power-2s-02 電源スイッチの実装方式を 3 案に絞って評価 (判断待ち)
    単押しトグルは原理的にエッジトリガを要求し、ボタンバウンスに晒される。
    真ディスクリートの双安定 + 容量ステアリングは部品ばらつきに敏感で
    リファレンス回路も存在しないため、UX を変える案を含めて 3 案を比較した。
    - 候補 A (推奨): 真ディスクリート / タップ=ON・長押し 1.5s=OFF
    エッジ検出を使わないので構造的にバウンス耐性あり。状態記憶は 5V レール自身。
    電源投入時 OFF はプルアップ抵抗 1 本で保証 (競合状態なし)。
    部品 11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
2026-08-10 kiban: power-2s-02 電源スイッチのラッチ回路を確定 (候補 A / 全定数 + BOM)
    ユーザー判断で候補 A (真ディスクリート) を採用。docs/06 §3.6 に回路図・全定数・
    BOM 21 点・動作表・タイミング計算・要注意点・検証項目を確定。
    UX: 押下 130ms 以上で ON / 押下 1.5s 以上で OFF (長押しはどの状態からでも OFF)。
    状態記憶は 5V 出力レール自身で、エッジ検出を使わないためデバウンス回路が不要。
    主要な設計判断:
    - 電源投入時 OFF は R1 2.2M 1 本で保証 (競合状態なし)。BMS 過放電カットオフ→
    自動復帰時の再突入ループも構造的に防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
2026-08-10 kiban: power-2s-02 作図前の棚卸し skill を追加 + eda-schematic-init の SKILL.md を補完
    - eda-schematic-dump: 回路図の全要素 (部品/NET_PORT/ワイヤのネット/枠/注釈) を
    読み取り専用で構造化出力。作図前の棚卸し・作図後の差分確認・2P 版残留物チェック・
    LCSC 番号欠落検出に使う。
    target フィールドで「複製元 2P 版を開いていないか」を最初に警告する
    (回路図の document uuid が複製元と同一なので project uuid でしか判別できない)
    - eda-schematic-init: scripts だけあって SKILL.md が無く skill として認識されない
    状態だったので補完。座標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
2026-08-10 kiban: power-2s-02 EDA 作図の経路を確立 — 座標符号・ページ開き方・LCSC からの部品配置
    ブリッジ接続 → power-2S-02 の回路図 P1 を開き、棚卸しまで完了。docs/07 に実測を追記。
    ⚠️ 座標系の重大な発見 (2026-08-11 実測、2 回検証):
    sch_PrimitiveRectangle.create() の Y と getAll() の topLeftY は符号が逆。
    create(1000,-100) → 読み +100 / create(1000,+785) → 読み -785。テキストは round-trip。
    → docs/07 §1 の枠座標表 (負値) をそのまま create() に渡すと図面が上下反転して
    A4 シート (1170x825) の外に出る。符号反転が必須。
    ページの開き方 (落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
2026-08-10 kiban: power-2s-02 全部品の LCSC 選定を完了 (35 品番、空欄なし)
    EasyEDA ライブラリ (lib_Device.getByLcscIds / search) で全件を実測解決し、
    docs/05 §2.1 に確定 BOM を新設。半導体 9 / インダクタ 2 / 抵抗 16 / コンデンサ 8。
    設計値の修正 (標準外の値・入手性で 4 件):
    - RISET 90kΩ → 91kΩ (C23265)。90kΩ は E24/E96 いずれにも無い標準外の値。
    ICHG = 90000/91000 = 0.99A で設計意図と実質同じ
    - 充電段 R1 0.5Ω → 1Ω (C112305)。0.5Ω は薄膜 1% 系に存在しない。
    IC 消費 20mA で降下 20mV、UV 閾値 4.35V に対し 0.5% で無害
    - 10µF/25V は C2980800 → C15850 に差し替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
2026-08-10 kiban: power-2s-02 EDA 書き込み系 API を実測 (create/delete 往復を検証)
    回路図への初回書き込み前の検証。1 部品で create → 読み戻し → delete を往復させ、
    部品数が 73/45 に戻ることを確認した (回路図は無改変のまま)。
    - create(dev, x, y) は成功。SupplierId / ManufacturerId が戻り値から読める
    - ⚠️ Designator は "Q?" のまま自動採番されない → modify() で明示設定が必要
    - modify(primitiveId, {designator, name, ...}) の property 全フィールドを記録
    - getAllPinsByPrimitiveId() が **絶対座標**でピンを返す (配線に必須)。
    実測: MAX16054 はシンボル幅 100 units /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
2026-08-10 kiban: power-2s-02 回路図の枠を再配置 (PMIC +21% / CHARGE +126%) — 初回の書き込み
    作図に入る前段として、ブロック枠のサイズ配分を実測に基づいて組み直した。
    部品・配線は無変更 (73 部品 / 45 part / 76 ワイヤのまま)。
    | ブロック | 変更前 | 変更後 |
    | PMIC | 35..700 / 575..785 (665x210) | 35..510 / 430..785 (475x355) |
    | CHARGE | 35..480 / 370..545 (445x175) | 35..510 / 30..400 (475x370) |
    DCDC と connector は変更なし。
    再配置の理由:
    - 新ラッチは 21 部品で旧 PMIC 枠 (4 枠中 2 番目に小さい) では密度が高すぎる
    - CHARGE 枠 445x175 は 4 枠で最小なのに IP2326 は 18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
2026-08-10 kiban: power-2s-02 全シンボルのピン形状を実測 (配線座標の計算に必須)
    捨て配置 → getAllPinsByPrimitiveId() → 削除 で 8 種類のシンボルを実測し docs/07 に記録。
    部品数は 73 に復帰 (プローブは全削除済み)。
    回転 0 での中心オフセット:
    - N-MOS / P-MOS (2N7002, BSS84): G(-20,0) D(+10,+20) S(+10,-20)
    - NPN (MMBT3904): B(-10,0) C(+10,+20) E(+10,-20) ← B だけ -10 で MOSFET と違う
    - 抵抗 0603 / セラコン 0603: 1(-20,0) 2(+20,0)
    - セラコン 0805 (CL21): 1(-15,0) 2(+15,0) ← 0603 より狭い
    - LED: K(-20,0) A(+20,0) / TVS SMF12A: C(-20,0) A(+20,0)
    - JST PH 2p: 1(-20,+5) 2(-20,-5)
    回転の変換規則も確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
2026-08-11 kiban: power-2s-02 配線 API の挙動を実測 — 交差は繋がらない (レイアウト設計の前提)
    回路図は無変更に復帰 (部品 73 / part 45 / ワイヤ 76 / 文字 11)。
    ⚠️ 最重要: 交差の扱いを確定
    - X 交差 (端点を共有しない) → **繋がらない**。別ネットのまま独立して残る
    - T 字接続 (端点が他方の線上) → **繋がる**。2 本が 1 本に統合されネット名も寄る
    → 配線が交差してよいので、L/H/T/B のように相互に絡むノード群を平面的に
    並べる必要がない。前回「交差するから設計を練る」と止めた懸念は解消。
    逆に端点を他のワイヤ上に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
2026-08-11 kiban: power-2s-02 PMIC 回路図の座標設計を確定 (docs/06 §3.6.6)
    交差が繋がらないと分かったので、L/H/T/B が相互に絡む本回路でも平面配置に
    こだわらずに設計できるようになった。25 個 (部品 21 + NET_PORT 4) の配置表を確定。
    設計の骨格:
    - Y レベルを帯として割当 (760 PACK_P レール / 730 V5V レール / 660 ボタン横枝 /
    460 GND レール など)
    - 縦のノード列を X 固定 (110 B / 210 L / 310 H / 400 T)
    - ⚠️ PACK_P レールは左側だけ、V5V レールは右側だけに限定する。
    V5V を左へ伸ばすと x=110 の PACK_P 立上りと T 字接続して電源短絡になる
    (交差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
2026-08-11 kiban: power-2s-02 PMIC ブロックの部品配置を完了 (21 部品 + NET_PORT 4)
    旧 PMIC (MAX16054 + 直列 P-FET) を削除し、ディスクリートラッチの部品を
    docs/06 §3.6.6 の座標表どおりに配置した。配線は未実施。
    実行内容:
    - 削除: U1/Q1/Q2/R1-R4/TP_RST/TP_STATE の 9 部品 + 付随ワイヤ 12 本
    (巻き込みチェックを実装し、残す部品 CN2/CN4/R13/LED1/R5/R6/TP_CHRG が
    ワイヤを失わないことを確認 = collateral 0 件)
    - 配置: 21 部品 (Q30-Q35 / R30-R37 / C30-C34 / D30-D31) + NET_PORT 4
    (PACK_P / V5V / SW_BTN / PWR_EN)
    - 検証: 部品 57 / NET_PORT 31 / ワイヤ 64、LCSC 不正 0 件、ダイオード向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
2026-08-11 kiban: power-2s-02 配線の制約を実測で確定 — 縦配線は「ピンの無い X」で降ろす
    配置後に全ピンの実座標を読み、同一 X 上に別ネットのピンが並ぶ列を洗い出した。
    ワイヤがピンの上を通ると接続されるため、部品の X をそのまま縦配線に使うと短絡する。
    危険な列 (縦配線不可):
    x=260 520:GND / 560:LATCH_L / 580:GND / 620:PWR_EN ← Q30 と Q31 の右側ピンが全部この列
    x=340 540:LATCH_T / 580:GND / 620:LATCH_H / 660:SW_BTN
    x=430 520:GND / 560:LATCH_T / 710:TMR_CHG
    x=480 / 400 / 470 / 310 も同様
    具体例: Q30.S(260,580) を x=260 のまま GND へ降ろすと
    Q31.C(260,5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
2026-08-11 kiban: power-2s-02 GND/電源記号 (createNetFlag) を実測 — 配線 0 本で接続できる
    createNetFlag('Ground','GND',x,y) / ('Power','V5V',x,y) が使えることを確認。
    ComponentType は netflag で part/netport とは別種。
    シンボルは Ground-GND (uuid d6cb921064447e46) / Power-5V (dad5364639ba3e4f)。
    重要: netflag のピンは配置座標そのものなので、部品ピンの座標に直接置けば
    ワイヤを 1 本も引かずに接続できる。GND のように多数のピンが散在するネットで
    縦配線の貫通事故 (docs/06 §3.6.6 の危険な X 列) を根本的に回避できる。
    ⚠️ netflag は delete() に primitiveId 文字列を渡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
2026-08-11 kiban: power-2s-02 拡大された枠に合わせて PMIC の 21 部品を再配置
    ユーザーが GUI で枠を調整 (PMIC 475x355 → 575x465 = +59%、CHARGE/DCDC も変更)。
    新しい枠に収まるよう全部品を再設計・再配置し、docs/06 §3.6.6 と docs/07 §1 を更新。
    再設計はオフラインで検証してから適用した (ピンオフセット + 回転変換規則で
    全ピン座標を計算し、枠外・同座標・同一 X 列の衝突をチェック):
    - 枠外のピン 0 / 別ネットの同座標ピン 0
    - PMIC_L が x=200 に 4 ピン揃う (R30.1 + N-MOS 3 個のゲート) → 縦線 1 本で結線でき、
    PACK_P(720) は貫通しない
    - PMIC_H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
2026-08-11 kiban: power-2s-02 PMIC ブロックの配線を完成 — 幾何検証クリア
    GND 記号 13 個 + NET_PORT 4 個追加 + 配線 31 本を実装。
    自前の幾何検証で「短絡なし / 未接続なし」を確認した。
    21 部品の全 48 ピンがすべて意図したネットに繋がっている
    (GND 13 / PMIC_L 7 / PMIC_H 5 / PMIC_T 5 / SW_BTN 5 / PACK_P 2 / V5V 3 /
    PWR_EN 2 / TMR_CHG 2 / LED_A 2 / BTN_G 2 = 48)。
    検証方法: ネットリスト API が両方使えないため (getNetlistFile は falsy、
    sch_Netlist.getNetlist は "i is not iterable" で例外) 自前で幾何チェックした。
    全ワイヤ線分に対し、線上に乗るピンを列挙して「ワイ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
2026-08-11 kiban: power-2s-02 CHARGE ブロック (IP2326) を作図完了 — 幾何検証クリア
    シート内に 2S 版 CHARGE 枠 (685x280) を新設し、18 部品 + GND 記号 13 +
    NET_PORT 6 + 配線 25 本を実装。短絡なし / 未接続なし を確認した。
    IP2326 のシンボル実測: 幅 150 / ピンピッチ 10 / 12 ピン x2 + EP は pin 25。
    ピン名はデータシート (docs/02 §2) と完全一致した。
    ネットごとの接続 (検証結果):
    CHG_VIN 4 / CHG_VINF 5 / CHG_LX 3 / CHG_VSYS 3 / BATT_P 3 /
    CHG_VBATM 3 / BATT_M 2 / BATT_N 3 / GND 13 + 設定抵抗と LED 系が各 2
    NC にしたピンは DM/DP/VSET/TIME_SET/VIN_OVSET/CON_SEL で設計どおり
    (CON_SEL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
2026-08-11 kiban: power-2s-02 旧 2P CHARGE を削除 + DCDC 枠を新設。巻き込み事故を記録
    ユーザー確認「シート外の charge は不要」に基づき旧 2P CHARGE 系を削除:
    - 部品 13 個 (U2 TP4056 / C1 / C2 / D1 / CN1 / R5 / R6 / LED1 / TP_CHRG /
    TP_STDBY、および PMIC 枠内に残っていた CN2 / CN4 / R13) と配線 19 本
    - シート外の旧 CHARGE 枠とタイトル / 孤立していた NET_PORT 6 個
    ⚠️ 事故と復旧: ワイヤは T 字接続で 1 オブジェクトに統合されるため、
    「削除部品のピンに触れるワイヤ」を消したときに別ブロック (PMIC) の SW_BTN
    配線 5 本まで巻き込まれて消えた。削除時の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
2026-08-11 kiban: power-2s-02 DCDC ブロック (MP1584) を作図完了 — 3 ブロック全て完成
    枠 X 690..1400 / Y 340..700 (710x360) に 16 部品 + GND 記号 12 +
    NET_PORT 3 + 配線 15 本を実装。幾何検証で短絡なし / 未接続なしを確認した。
    DC_SW 4 (U20.SW / L20.2 / D20.K / C26.1)
    DC_BST 3 (U20.BST / C26.2 / D21.K) ← 外付け BST ダイオードが入っている
    V5V 7 (L20.1 / C22.1 / C23.1 / C25.1 / R20.1 / D21.A / NET_PORT)
    SW_VIN 5 / DC_FB 3 / DC_COMP 2 / DC_COMPR 2 / DC_FREQ 2 / PWR_EN 2 / GND 12
    D20 (SS34) はカソードが上 = DC_SW 側、D21 (1N4148W) はカソードが BST 側で
    いずれも実測ピ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
2026-08-11 kiban: power-2s-02 HANDOFF を更新 — 回路図 3 ブロックの作図完了を記録
    EasyEDA 上での実装完了状況を HANDOFF に集約。設計データはクラウドにあるため
    リポジトリには回路図ファイルを置かず、状態を文書で引き継ぐ。
    - PMIC 21 部品 / 配線 34、CHARGE 18 / 25、DCDC 16 / 15
    - LCSC 番号の欠落 0 件 (全 55 部品)、GND は netflag 38 個を直置き
    - ネット別ピン数 34 ネットすべて設計どおり
    - 旧 2P 版の部品 43 個と枠 2 個はすべて削除済み
    検証方法も明記: ネットリスト API が両方使えず ERC も件数しか返さないため、
    自前の幾何チェック (全ワ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
2026-08-11 kiban: power-2s-02 Designator を種類ごとの連番にリナンバー (55 部品)
    旧 2P 部品を全削除したのでブロック番号帯 (10/20/30 番台) をやめ、
    種類ごとの連番 (ブロック順 CHARGE → DCDC → PMIC) に統一した。
    U1 (IP2326) / U2 (MP1584) / L1 / L2 / Q1-Q6 (PMIC)
    R1-R6 (CHARGE) / R7-R10 (DCDC) / R11-R18 (PMIC)
    C1-C8 (CHARGE) / C9-C16 (DCDC) / C17-C21 (PMIC)
    D1 (充電 SS34) / D2 (降圧 SS34) / D3 (1N4148W) / D4 (TVS)
    LED1 (充電表示) / LED2 (電源 ON)
    検証: 55 部品すべて改番、Designator の重複なし、LCSC 番号の欠落なし。
    手順の要点 (HANDOFF に記録):
    - modify() は省略フィールドを壊すの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
2026-08-11 kiban: power-2s-02 回路図に注釈を追加 — 図面単体で動作が読めるようにした
    ユーザー指摘「グローバルラベルの意味など、このままではどのように動作するか
    わからない」に対応。各ブロックに fontSize 10 太字の注釈を計 34 行入れた。
    - SYSTEM / NET MAP 枠を新設 (X 720..1380 / Y 10..310)
    ブロック間のネットマップを図示。特に **BATT_* は基板上で PACK_P と
    繋がっておらず、基板外の BMS (XR-2S-30A) を経由して戻る** ことを明記。
    これが分からないと「充電出力と放電入力が繋がっていない」ように見える
    - CHARGE (7 行): 充電電流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
2026-08-11 kiban: power-2s-02 回路図を KiCad 10 形式へ変換する Python ツールを追加
    目的: (c) バックアップ / 版管理。設計データはクラウドのみ (CLAUDE.md §5) だったので
    テキスト形式のスナップショットをリポジトリに置けるようにした。
    tools/eda-dump-full.js EasyEDA から全要素をダンプ (読み取り専用)
    tools/eda2kicad.py .kicad_sch を生成 (外部ライブラリ不要)
    tools/verify_kicad.py ネットリストが一致するか検証 (KiCad 不要)
    kicad/power-2S-02.kicad_sch 生成物 (256KB / 16351 行)
    kicad/README.md 手順と限界
    検証結果: **部品ピン 154 / ネット 48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
    [power-2S-02.kicad_sch, schematic-dump.json]
2026-08-11 kiban: power-2s-02 docs/07 の getState_Line() の記述を訂正 + KiCad 版は単一シートで確定
    ⚠️ docs/07 の訂正: getState_Line() の戻り値は「入れ子 + 点の順序が逆のポリライン」
    ではなく、**平坦化すると「独立した線分の並び」(2 点ずつが 1 線分)** だった。
    隣接ペア (0,1)(1,2)(2,3)… で解釈すると存在しない斜め線分ができる
    (実際に 125 線分を 183 線分に膨らませた)。実例つきで書き直した。
    あわせて「T 字統合ワイヤは 1 オブジェクトに複数線分」「長さ 0 の線分が混じる」も明記。
    KiCad 版は**単一シートで維持する**ことに決定 (ユ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
2026-08-11 kiban: power-2s-02 北極ステータス窓のハンドオフ資料 (docs/08) を新設
    - 北極キャップを透光ステータス窓にする作業指示書。別セッションが単独で
    着手できるよう、会話文脈に依存しない自己完結形式で記述
    - 電源 ON 表示はフリップフロップの Q から駆動 → 磁石をかざした瞬間に点灯し
    AtomS の起動を待たない。充電中 LED も北極へ移設
    - M5 AtomS3R が GPIO を使い切っている制約を反映。veto / PWR_OFF の
    GPIO 拡張 3 案 (I2C エキスパンダ / WS2812 データ線多重化 / 載せ替え) を比較
    - 北極 pillar の配線通路 Φ3 mm 追加は親リポジト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
2026-08-11 kiban: power-2s-02 docs/08 にユーザー確定 3 件を反映 (音なし / 2灯一括 veto)
    - ブザーは鳴らさないことを確定 (Q3 クローズ、再提案禁止)
    - 動画再生中は電源 ON / 充電の両インジケータを消灯する仕様に変更。
    veto を LED アノードレール LED_VCC の 1 素子で切る設計に改め、
    IP2326 pin 6 の駆動経路に手を入れずに 2 灯を一括制御する
    - これに伴い pillar 配線を 5 本 → 6 本に。V3P3 (ホール専用) と LED_VCC を
    分離しないと再生中に電源を切れなくなるため、共用禁止を明記
    - キャリア基板の搭載予定を 5 部品と確定し、追加候補 (RGB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
2026-08-11 kiban: power-2s-02 docs/08 の veto/PWR_OFF を I2C エキスパンダ方式で確定
    I2C 端子が電源基板上に実装済みで使用可能と判明したため方針変更。
    Grove を BNO055 が占有していても I2C はバスなので同居でき、GPIO は消費しない。
    - VETO と PWR_OFF を 1 個の I2C エキスパンダから供給。ESP32 ソフト電源断の
    ペンディングを解除 (docs/06 §1 の「パッド予約のみ」は要改訂)
    - WS2812 データ活動検出 (案 A) はフォールバックに降格。定数は算出済みのまま残置
    (実効デューティ 4.0% 最悪条件で平衡 1.76V / Vbe 0.6V に対し余裕 2.9 倍)
    - 落とし穴 2 件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
2026-08-11 kiban: power-2s-02 docs/08 の veto/PWR_OFF を PCA9632 (I2C LEDドライバ) で確定
    GPIO エキスパンダはパッケージが大きく保留。代わりに I2C LED ドライバ
    PCA9632 を採用する (ユーザー提示の Switch Science 基板)。
    採用理由:
    - 出力がオープンドレイン(シンク) = 「プルアップされたノードを GND へ引く」
    という必要な操作と極性が完全一致 → N-MOS バッファ 2 石 + 抵抗 4 本が不要
    - LED ドライバなので power-up 時は出力オフ = 両信号とも非アサート →
    boot-safe が無条件で成立。PCF8574 の「起動と同時に電源が切れる」危険が無い
    - 8bit PWM x 4ch +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
2026-08-11 kiban: power-2s-02 システム構造とボード間インターフェース (docs/09) を新設
    基板が 6 種に増え、PCA9632 が core 基板側に載ることが決まったため、
    電源基板から見た取り合いを 1 箇所に集約する doc を新設。
    - 基板/アセンブリ一覧 (B1 電源 / B2 core / B3 マザーリング / B4 inner_deck /
    B5 北極キャリア / B6 FPC) と全体ブロック図
    - 電源ドメイン 5 系統とオフ時電流の内訳
    - ボード間インターフェース: B1<->B5 (北極 6 本) / B1<->B2 (VETO・PWR_OFF は
    オープンドレインで基板間を渡す) / B2<->B3
    - 電源 ON/OFF の全体シーケンス 8 段
    ★ サブ doc 間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
2026-08-11 power-2s-02: 電源 SW 方式を全面改訂 — ホール素子 + 常時オン LDO + D-FF + EN 直結
    ディスクリートラッチ (押下 130 ms / 長押し 1.5 s) を廃止した。docs/08 の確定事項
    「状態表示は FF の Q で駆動し、かざした瞬間に点灯 (MP1584 の soft-start すら待たない)」と
    旧方式の「状態記憶は 5V レール自身」が論理的に両立しないため。旧設計は docs/06 §8 付録に
    全文保存 (再提案禁止)。
    新構成:
    PACK_P → HT7333-1 LDO (常時オン 3.3V) → ホール素子 (北極)
    → 74LVC1G14 Schmitt インバータ → 74LVC1G74 D-FF (トグル) → Q を MP1584 EN へ直結
    データシ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
2026-08-11 kiban: power-2s-02 ring/core 改版指示書 (docs/10) + 実基板解析と確定判断を docs/09 に反映
    mother-ring / core-M5atom-FPC の KiCad プロジェクトからネットリストを抽出し、
    推測に頼っていた部分を一次情報で置き換えた。
    docs/09 §0.5 (実測):
    - core 基板の正体 = kiban/resized/core-M5atom-FPC (部品19/ネット16)
    - GPIO06 → R1(0Ω) → C7(0.1uF) → LS1 スピーカ。R1 が事実上のジャンパで
    C7 で AC 結合されている
    - WS2812 は GPIO01-05 → 33Ω ダンピング → DIN01-05、DOUT は終端
    - I2C は ring の J16 に引き出し済み。プルアップは AE-BNO055 に内蔵
    - ring の +3V3 は AtomS3R の 3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
2026-08-11 kiban: power-2s-02 docs/10 に ring 実装のレビュー結果と B 案 (外部直ハンダ) の要件を反映
    mother-ring (kiban/re-design/mother-ring) の回路図/PCB を読んで検証。
    反映済みとして確認できた項目:
    - PCA9632 (U1) + パスコン C13 を追加。配置は角度 107.3 度 / 半径 39.0mm で
    推奨領域 (88-121 度) に的中
    - SDA->pin7 / SCL->pin6 / VSS->pin5 / VDD->pin8 がデータシートと一致
    - VETO=U1.1(LED0) / PWR_OFF=U1.2(LED1) を J7.5 / J7.6 へ
    - 旧 BM / P+ ネットが消滅、5V-ALWAYS -> V3P3-ALWAYS、+3V3 -> V3P3-SW
    - V3P3-SW と V3P3-ALWAYS は別ネットで分離できている
    検出して修正された不具合:
    - V3P3-SW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
2026-08-11 kiban: power-2s-02 北極キャリア基板の確定仕様を docs/08 §5.2a に記載
    ユーザー決定: ホール素子 = S-5716A / 指示器 = 単色 2 灯 (案 A)。
    これで北極基板の回路が全部埋まった (部品 5 点 + ハンダパッド 6)。
    確定した内容:
    - S-5716A の SOT-23-3 ピン配置 (1=VSS / 2=VDD / 3=OUT) を
    EasyEDA ライブラリの検証済みシンボル (C2152468) から取得
    - 電流制限抵抗 680 ohm を計算で確定 (3.3V / Vf 2.0V / 1.84mA)
    - 電源 OFF 中は両 LED のカソードが開くので V3P3 からの消費は 0mA
    解決した Open questions:
    - Q1 ホール素子選定 → S-5716A。LCSC にも SOT-23-3 品があるため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
2026-08-11 kiban: power-2s-02 docs/08 の機構仕様を実機準拠に全面改稿 + 部品を確定
    写真とユーザー確認で機構が判明し、それまでの記述が誤った指示書に
    なっていたため §5 を書き直した。
    実機で確定 (§5.0 に新設):
    - 北極の五角形穴 (φ5-6mm) は「LED を覗かせる窓」として使う
    - 基板は球体の内側・pillar 先端に載る (外側ではない)
    - 外形 φ14.7mm (南極の送信側基板と同一。実測)
    - ホール素子は外殻 5mm を透かして検出 (Bop 1.8mT 品を選定済み)
    - 外部露出が無いので ESD 保護素子は不要
    ★ charge-connector-06 は球体の部品ではなく充電ドック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
2026-08-11 kiban: power-2s-02 北極基板に逆貼りタクトSWを採用 (ダイオードOR・線6本維持)
    ユーザー決定 3 件を反映。
    1. 逆貼りタクトスイッチを採用 (前回の「不採用」を撤回)。
    五角形穴の深さ 5mm で指が届かないため「クリップで突く」操作になるが、
    それが当初からの想定。球体を分解せずに電源を入れられるので
    電源基板上の SW1 より保守性が高い。部品はユーザー手持ちの RT3301AF260Q 系。
    2. 案 2 (ダイオード OR) を採用し pillar の線を 6 本に保つ。
    ホール素子が CMOS 出力なので単純並列だと L 側ドライバ (Ron 50 ohm) が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
2026-08-11 kiban: power-2s-02 J6.4/J6.5 を V3P3-ALWAYS から SDA/SCL に再振り替え
    ユーザー決定: V3P3-ALWAYS は負荷ゼロのままで、かつ電源基板側で LiPo 残量測定に
    I2C が必要になったため、実需のある I2C に振り替える。
    ★ 副産物: 「ring 上に 3.3V が 2 系統できる」危険が消滅した。
    ring の 3.3V は V3P3-SW の 1 本だけになり、docs/09 と docs/10 で
    最重要警告として書いていた項目が不要になった (経緯は履歴として保存)。
    ring 側の作業も 2 件減る (V3P3-ALWAYS ネットの新設が不要 / J12 の意味変更が不要)。
    あわせて J6 のピン順見直しを推奨として追加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
2026-08-11 docs/08: 北極基板の確定回路を KiCad 正本に同期 (C2 追加 / Ref 指定子 / ネット名 / 残作業)
    - BOM を 11 点に更新 (C2 = U1 VDD パスコン 100nF を追加)
    - Ref 指定子を KiCad に合わせる: LED = D1/D2、OR ダイオード = D3
    - ネット名を確定: +3V3 / GND / LED_VCC / OUT / STAT_CHG_K / STAT_PWR_K
    - J1(2P) / J2(1x4) のピン割り当て表を追加
    - C2 を直列に入れると U1 が無通電になる誤りを警告として明記
    - 回路図の外に残る作業 5 件を列挙
    - D4 の成果物置き場を EasyEDA → KiCad 正本に変更 (EasyEDA の試作 Board2 は削除済み)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
2026-08-11 kiban: power-2s-02 新 PMIC の中核を作図 (旧ディスクリートラッチを削除 → LDO + Schmitt + D-FF)
    EasyEDA 側の作業:
    - 旧ディスクリートラッチを削除 (部品 21 / netport 9 / GND flag 13 / ワイヤ 18 / 注釈 9)
    枠を跨ぐワイヤ 0 件を事前確認したので他ブロックの結線は無傷
    - 2P 版の残骸 [5] Boost TPS61088 の注釈も削除
    - 新規 13 部品を配置・結線 (U3 HT7333-1 / U4 74LVC1G17 / U5 74LVC1G74DP + 受動 10 点)
    - 9 ネットすべて幾何検証済み。PWR_EN → U2.EN の界面は無改造で維持
    - 全 49 部品の LCSC 番号を確認 (create() が supplierId を型番で埋める不具合を 13 点修正)
    - R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
2026-08-11 kiban: power-2s-02 IP2326 pin6 はソースと判明 → LED を共通カソードへ / PWR_OFF-PWR_EN の短絡を修復
    pin 6 の駆動方向をデータシート Figure 5 (p.16) の図で検証:
    - pin6 → R2 100Ω → LED → GND = ソース出力。docs/08 §7 Q2 の「シンク」は誤読だった
    - これで docs/08 §4.3④ と §4.4b の矛盾 (ブロッカー ③) が解消
    - LED は共通カソード LED_K へ。LED_VCC は廃止
    - veto = 2N7002 1個 + 100kΩ プルアップ = 2点。P-MOS + PNP 反転段は不要
    - 電源 ON LED は MOSFET 不要 (74LVC1G74 の Q ±24mA から直接駆動)
    - 充電 LED の抵抗は 100Ω (メーカー指定値) に戻す。pin6 の出力電圧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
2026-08-11 kiban: power-2s-02 veto 出力段を作図 + docs/08 を共通カソード方式へ改訂
    EasyEDA (PMIC 枠に veto 出力段を追加、部品 50 点):
    - Q1 = 2N7002 (C8545) : LED_K を GND から切り離す低側スイッチ
    - R23 = 1M (C22935) : ゲートを V3P3 へプルアップ = default 点灯 (boot-safe)
    ⚠️ 100k ではオフ時 33uA が未通電 PCA9632 の ESD へ流れて 50uA 予算を超える
    - C28 = 1nF (C1588) : ゲートのノイズ対策。tau = 1ms
    - netport VETO / LED_K / V3P3 を追加。3 ネットとも幾何検証済み
    - 注釈を更新 (未実装項目はデバッグ SW 2 個と CN7 のみに)
    ⚠️ API の落とし穴を再確認: modify() に {x,y,rotatio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
2026-08-11 docs/08: コネクタ表を J1/J2 + 共通カソードのネット名に統一 (前 commit で置換漏れ)
2026-08-11 docs/08: north KiCad をネットリストで実測 — LED の向きは正しく、カソードが未接続だった
    kicad-cli sch export netlist で /Users/katano/work/kiban/re-design/north を実測 (読み取りのみ):
    - ✅ LED の向きは正しい。PWR_EN → R1.1 / R1.2 → D1.2[A] でアノードが駆動側
    → 前回「画像から向きが逆に見える」と書いたのは私の読み違い。訂正した
    - ⚠️ 本当の欠陥: D1.1[K] / D2.1[K] が未接続で LED_K が J2.1 のみ
    → カソードを束ねて J2.1 へ配線する必要がある (残作業 #0)
    - R2 が 680Ω のまま → 100Ω へ (残作業 #0b)
    - U1 の Value が のまま (残作業 #1)
    - SW1 の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
2026-08-11 kiban: power-2s-02 PMIC のピン単位監査で C25 の未接続を検出・修復
    ピン単位のネット解決で全 42 ピンを監査 (全ピン座標 → ワイヤ束 → 束に乗る netflag/netport 名):
    - ⚠️ C25.2 がピンから外れて未接続だった → GND netflag を追加して修復
    これは重大: パワーオンリセットが機能せず、電池挿入時に勝手に電源が入る可能性があった
    - 長さ 0 のワイヤ残骸 7 本を削除
    - 残る未接続は U4.1 (NC ピン) のみ = 物理的に NC なので正常
    - それ以外の 41 ピンは全て期待どおり (V3P3 / PACK_P / HALL_OUT / CLK / トグル / SD /
    PWR_OFF / PWR_EN / VETO / LED_K /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
2026-08-11 kiban: power-2s-02 北極コネクタ CN7/CN8 とテストポイントを追加
    コネクタ (north の J1/J2 と 1:1 対応・2.00mm ピッチで統一):
    - CN7 = 2P (HX PZ2.0-1x2P TP-YQ / C41417341) : 1=GND / 2=V3P3
    - CN8 = 4P (HX PZ2.0-1x4P TP-YQ / C41417343) : 1=LED_K / 2=HALL_OUT / 3=CHG_LED / 4=PWR_EN
    - ピン順も north と一致するのでストレートハーネスで済む
    - docs/06 §7 Q8 (北極コネクタ品番) はこれで解決
    - 従来 CN8 に予定していた core 基板コネクタは CN9 以降へ繰り下げ
    テストポイント:
    - 部品は Test-Point (Test-Point-0.5mm / LCSC 番号なしの裸パッド) を addIntoBom=false で使う
    - V3P3 / HALL_OUT / VETO / PWR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
2026-08-12 kiban: power-2s-02 CHARGE 段をピン単位で再監査 — 結線切れ 2 件を修復
    - EN (pin 12) が宙浮きだった (CHG_VINF の NET_PORT が VIN 側から消失)
    → 充電器が一切動かない状態。VIN ノードへ NET_PORT を復元
    - L1.1 と LX バスの間に 25 mil の隙間 → 昇圧の主電流経路が断線。ワイヤ追加
    - NC フラグ 6 本 (DM/DP/VSET/TIME_SET/VIN_OVSET/CON_SEL) を追加
    - 図面注釈を現状に更新 + EN の扱いを 1 行追記
    - charge-audit.js を skill に追加 (ネットタグ 1 個 = 宙浮きを検出)
    - C3 が BATT_M に乗っている件は docs/02 §3.11 残件 ② として記録 (未修正)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
2026-08-12 kiban: power-2s-02 電池系コネクタ CN2/CN3 を実装 + シート注釈の不整合を一掃
    コネクタ (HX PZ2.0 系で統一、CN7/CN8 と同シリーズ):
    - CN2 3P (C41417342): BATT_P / BATT_M / BATT_N — セル
    - CN3 4P (C41417343): PACK_P x2 + GND x2 — BMS 戻り。放電 ~2.8A に対し
    PZ2.0 は 2A/ピンなので 2 並列で ~4A を確保
    - CN1 2P (充電入力) はユーザー配置。docs/01 §4 に実装表を追加、Q1 をクローズ
    注釈の不整合:
    - 旧ディスクリートラッチの説明 7 行を削除 (廃止方式)
    - SYSTEM/NET MAP が 2 か所に重複していたので枠内に 18 行で作り直し
    - 2P 版の残骸 (TPS61088 / VBAT / PROBE) を削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
2026-08-12 kiban: power-2s-02 DCDC 段を再監査 (docs と完全一致) + 監査スクリプトの座標比較を許容誤差化
    - dcdc-audit.js を追加。16 部品 37 ピンを照合し docs/03 §3.10 の表と完全一致。
    短絡・未接続なし
    - ⚠️ 監査の座標比較が厳密一致だったため「出力コンデンサ 3 個の GND 未接続」を
    誤検出していた (API が 504.9999999999999 のような値を返す)。実際は接続済み。
    誤検出を信じて追加した重複 netflag 3 個は削除
    - charge/dcdc/pmic の 3 監査を許容誤差 0.01 に統一。PMIC の C25 (POR) も
    誤検出で、実際は正常だった
    - U4.1 (NC) に NC フラグ。API のタ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
2026-08-12 kiban: power-2s-02 充電器側 USB-C 化の可否を検討 (docs/02 §3.3a)
    - 電流は足りる: USB-C の素の能力 5V/3A に対し必要は 1.83A
    - 交渉は必ずケーブル側 — 磁気端子が 2 極なので CC/DP/DM を球体内に持ち込めない
    - ⚠️ 2S モードは入力 ~7V が上限 (昇圧なので VIN<VOUT 必須、OVP も 8.75V)
    → USB-PD の固定 9V は使えない。7V は PPS/QC3 のみ
    - USB-C 化しても充電は速くならない (律速は AWG26)。速くするには 7V 化が唯一の道
    → その場合 RISET 91k→75k (1.2A) で 2.0-2.5h
    - ROV=1k で OV 無効化して 9V を入れる案は過充電になるため禁止として明記
    - Q7 とし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
2026-08-12 kiban: power-2s-02 XR-2S-30A の端子と本基板ネットの対応を整理 (docs/01 §4)
    - PACK_P = P+ / GND = P− / BATT_P = B+ / BATT_M = BM / BATT_N = B−
    - ⚠️ BATT_N は GND ではない — B− と P− の間に保護 FET が入るため別ノード。
    回路図で DC 短絡が無いことを確認済み (C8 の AC 結合のみ)
    - BATT_P と PACK_P は低圧側スイッチングなら同じ銅だが、基板上では結ばない
    (高圧側だった場合に保護を丸ごとバイパスするため)
    - Q5 を起票: FET がどちら側かをテスターで確定 + 保護トリップ後の自己放電を実測
    (pin 24 の ESD ダイオードが寄生経路になりうる)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
2026-08-12 kiban: power-2s-02 BAT_STAT を未使用 (NC) に確定 — テストパッドも出さない
    データシートの規定は「トリクル中 L / CC 以降 H」だけで、充電中か否かも満充電か否かも
    判別できない。H レベル電圧も未規定で、ESP32 への経路も無い (CN5/CN6 を 1 本消費する)。
    ユーザー表示は pin 6 (CHG_LED) が充電中/満充電/異常を区別できるので足りている。
    テストパッドも不要 — トリクル判定は充電電流を測れば分かり、LX 近傍にスタブを
    増やす方が害が大きい。
    - 回路図: NET_PORT と引き出し線を削除、pin 5 に NC フラグ
    - 注釈: NET MAP の BAT_STAT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
2026-08-12 kiban: power-2s-02 充電器側は DC プラグで確定 (Q7 クローズ)
    ユーザー確認により USB-C 化は採らない。以下が確定として維持される:
    - 入力 5V 固定 (PD/QC/PPS 交渉なし)
    - 充電電流 0.99A (RISET 91k = C23265) 据え置き → 入力 1.83A で AWG26 内
    - 満充電 2.5〜3 時間
    - DM/DP は NC、CC 抵抗も不要
    将来 USB-C にする場合の案 A (5V / 追加部品ゼロ) と案 B (7V PPS + RISET 75k) は
    docs/02 §3.3a に判断材料として残す。
